BearXP/DLY_2014_Sumo/Electronics/Images as References/2007-09-15 IR Sensor/IR Sensor.jpg

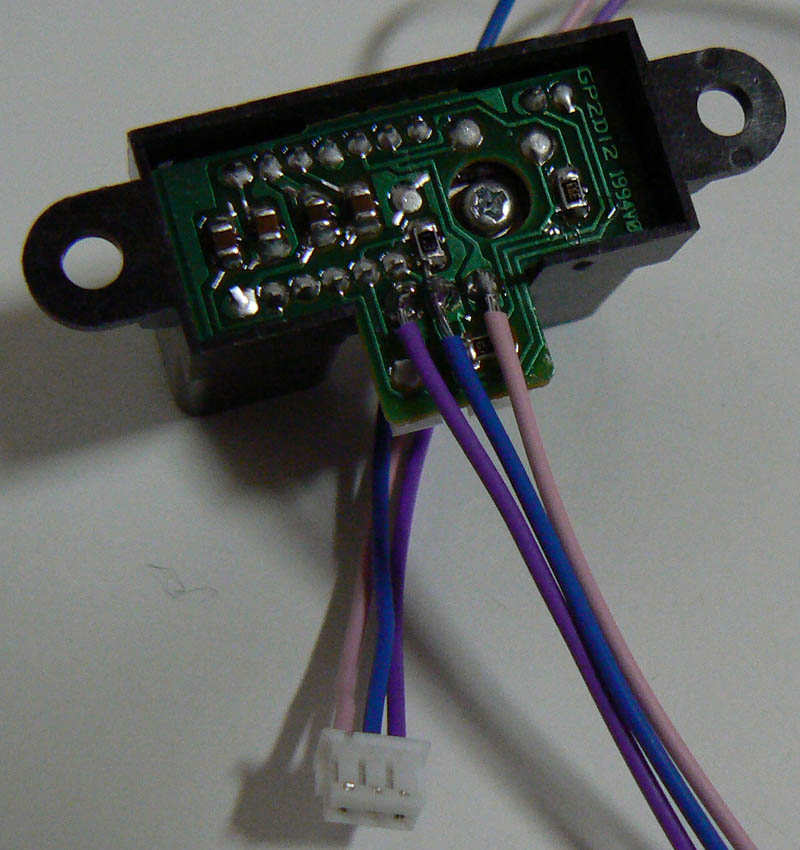
Electronics/Images as References/2007-09-15 IR Sensor/IR Sensor.jpg
