BearXP/DLY_2014_Sumo/Electronics/2007-04-16/Sumobot/Sumo info/Invetech Sumo Helpful Hints.pdf

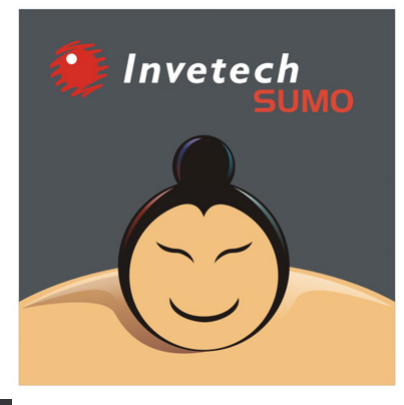
[picture p3: figure]

## Invetech Sumo Startup

Competition Day : Friday, June 30th, 12.30pm

Useful Pages

www.lynxmotion.com

www.minibearings.com.au

www.electusdistribution.com.au

www.jaycar.com.au

Example Sensors

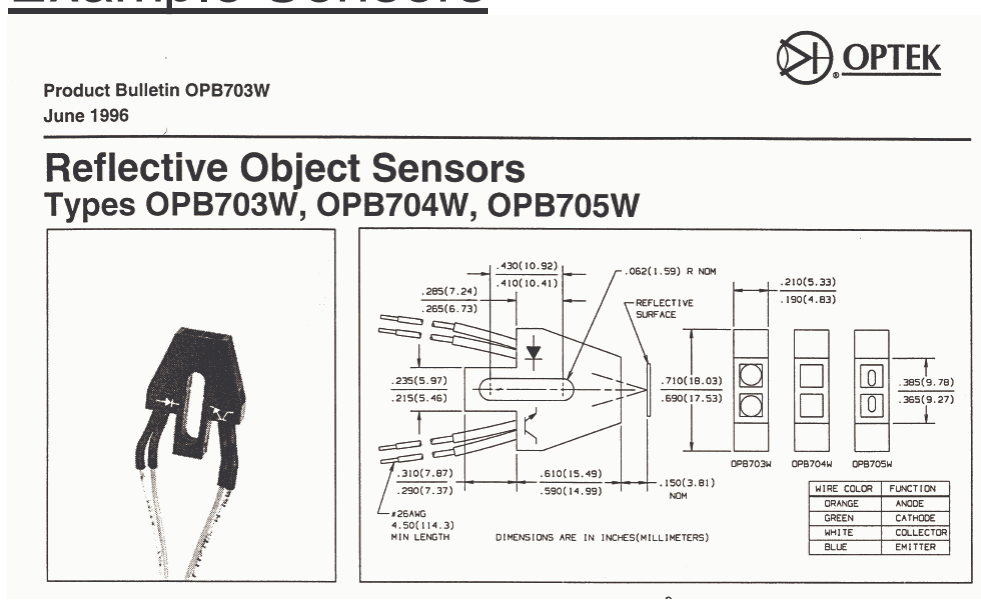
[picture p4: figure]

Farnell part No : 489 0917 $14.89

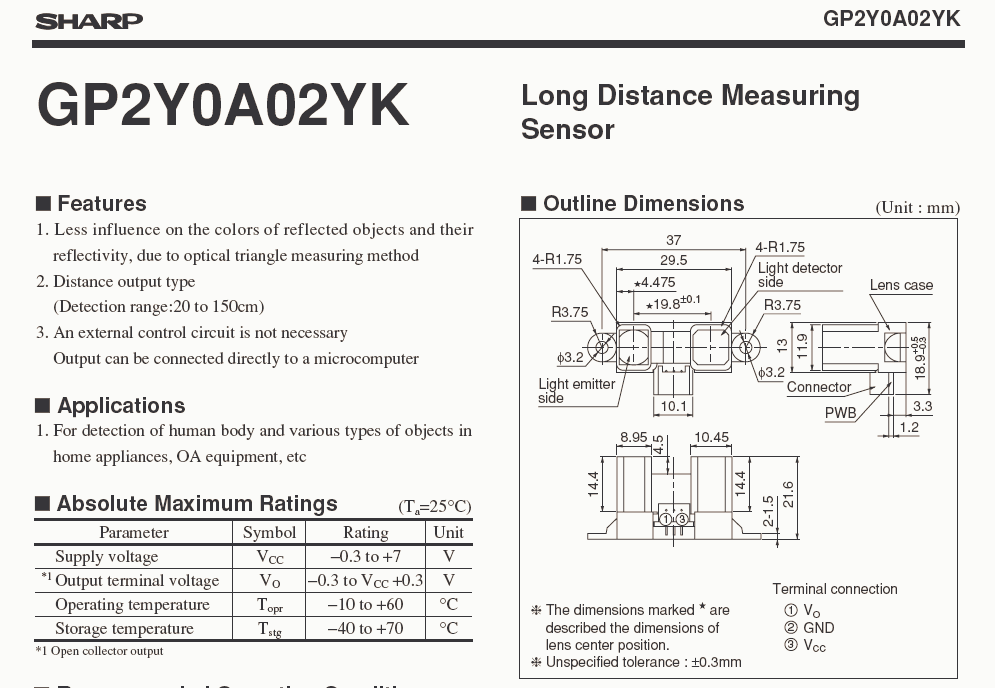
[picture p5: figure]

www.manuco.com.au around $12.00
