BearXP/DLY_2014_Sumo/Electronics/2007-04-16/Sumobot/PDFs/22-03-2007/ToDoList.pdf

## To-Do List Report For Sumobot 2007.PRJPCB

Done | Action Item | Priority | Document | Owner | Category
False | Decouple HIP4081AIBZ VCC and 12V | Normal
False | ARef require decoupling? | Normal
False | Choose resistor values | Normal
False | Sort out duplicated component names | Normal
False | Add fuse for VBat and maybe 5V? | Normal
March 22, 2007 10:26:19 PM | Page 1 of 1
