BearXP/DLY_2014_Sumo/Electronics/2007-04-16/Sumobot/Motor layout copy.gif

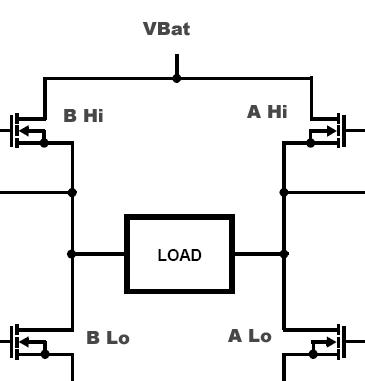
Electronics/2007-04-16/Sumobot/Motor layout copy.gif
