BearXP/DLY_2014_Sumo/Electronics/Programmers/ponyprog_sch.png

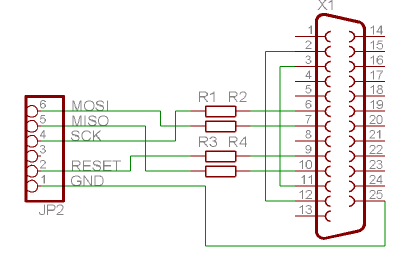
Electronics/Programmers/ponyprog_sch.png
