BearXP/DLY_2014_Sumo/Software/AVRStudio/Atmel Corporation_files/AVRstudio.jpg

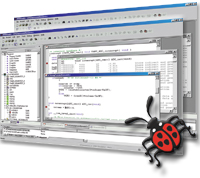
Software/AVRStudio/Atmel Corporation_files/AVRstudio.jpg
