BearXP/DLY_2014_Sumo/Electronics/2007-06-05 reroute/BOM/sumobom.xls

Sheet: Overall
Costs
 |  |  | Board | Components
PCB | 180 | QTY of Sumos | 11 | 6
PCB Components | 571.2907317 | QTY Of Motor | 15 | 11
Sensors | 520.5609756 | QTY of sumobots | 7 | 7
frame |  | Exchange Rate
 |  | $1AU = | 0.82 | $US
Total Cost | 1091.851707
Cost per person | 99.25924612

Sheet: Sumo PWA
Part |  |  |  |  |  |  | Price Each |  | Price |  |  |  | Approx Cost | Order Quantity
No | QTY | Man Part Num | Description | Man | Supplier | Supplier PN | Price AU | Price US | Break | Component | Notes | Cost/board | $US | (Using price break and num boards)
1 | 2 | SN74LVC2G14DCKR | INVERTER DUAL SHMT-T | TI | Digikey/Sample | 296-13011-1-ND |  | $0.40 | 1 | U21,U31(motor) |  | $0.80 | $4.80 | 12
2 | 0 | NTD5406NG (http://www.onsemi.com/PowerSolutions/product.do?id=NTD5406NG) | Power MOSFET 40 V, 70 A, Single N-Channel, DPAK | On Semi |  |  |  |  |  |  |  | $0.00 | $0.00 | 0
2.1 | 0 | IRFR2405TRPBF | HEX/MOS N-CHAN 55V 56A DPAK | IRF | Digikey | IRFR2405PBFCT-ND |  | 1.879 | 10 | Q1,Q2,Q3,Q4,Q5,Q6,Q7,Q8 |  | $0.00 | $0.00 | 0
2.2 | 8 | IRLR2905 | MOSFET N-CH 55V 42A DPAK | IRF | Digikey | IRLR2905-ND |  | $0.88 | 10 | Q1,Q2,Q3,Q4,Q5,Q6,Q7,Q8 |  | $7.04 | $77.44 | 88
3 | 2 | HIP4081AIBZ | IC DRIVER FET FULL BRIDGE 20SOIC | Intersil | Digikey | HIP4081AIBZ-ND |  | $5.50 | 1 | DC motor only | Drops to 4.18 @ 25 | $11.00 | $66.00 | 12
4 | 4 | LTST-C170TBKT | LED BLUE CLEAR 0805 SMD | Lite-on | TDT | 160-1579-1-ND |  | $0.30 | 10 | DS1,DS2,DS3,DS8 |  | $1.20 | $7.20 | 24
5 | 8 | LTST-C170GKT | LED GREEN CLEAR 0805 SMD | Lite-on | TDT | 160-1179-1-ND |  | $0.09 | 10 | DS4,DS5,DS6,DS7,DS10,DS11,DS12,DS13 |  | $0.74 | $4.46 | 48
6 | 1 | LM2595S-5.0 | 5V Switching Reg TO-263-5 | Nat Semi | Digikey/Sample | LM2595S-5.0-ND |  | $3.85 | 1 | VR1 |  | $3.85 | $23.10 | 6
7 | 1 | MC7812CD2T | 1A 12V Linear Reg D2PAK-3 | On Semi | Digikey | MC7812CD2TR4GOSCT-ND |  | $0.91 | 1 | VR2 |  | $0.91 | $5.46 | 6
8 | 1 | TPS76333DBV | 3.3V 150MA LDO REG SOT-23-5 | TI | Digikey | 296-2705-1-ND |  | $0.96 | 1 | VR3 |  | $0.96 | $5.76 | 6
9 | 0 | MAX232CSE | RS232 Tranceiver 5V 16 SOIC | Maxim | Digikey/sample | MAX232ECSE+-ND |  | $4.19 | 1 | U100 |  | $0.00 | $0.00 | 0
9.1 | 1 | MAX232D | RS232 Tranceiver 5V 16 SOIC | TI | Digikey/sample | 296-6936-5-ND |  | $0.90 | 1 | U100 |  | $0.90 | $5.40 | 6
10 | 1 | MAX3392E | Low Voltage Level translator TSSOP | Maxim | sample |  |  | $0.00 |  | U101 |  | $0.00 | $0.00 | 6
11 | 1 | 145638009211862 | SD Card connector press fit | AVX | Digikey | 478-2018-1-ND |  | $2.67 | 1 | CON1 |  | $2.67 | $16.02 | 6
12 | 0 | S1124 | PCB mount tactile switch |  | Alltronics | S1124 |  | $0.50 | 10 | S1, S2 |  | $0.00 | $0.00 | 0
0.1 | 2 |  | Toggle switch |  | Alltronics |  |  | $0.50 |  | S1, S2 |  | $1.00 | $6.00 | 12
13 | 1 | Atmega2560-16AU | AVR MCU 256K 16MHZ 100TQFP | Atmel | Digikey | ATMEGA2560-16AU-ND |  | $17.97 | 1 | U1 |  | $17.97 | $107.82 | 6
14 | 1 | 74VHC373M | LATCH OCTAL D-TYPE 20-SOIC | Fairchild | Digikey | 74VHC373M-ND |  | $0.43 | 1 | U2 |  | $0.43 | $2.58 | 6
15 | 1 | K6R1008C1D | 128Kx8 Bit High-Speed CMOS Static RAM 5V | Samsung | UNKNOWN |  |  |  |  | U3 |  | $0.00 | $0.00 | 6
15.1 |  | CY7C1019B |  | Cypress | Jameco |  |  |  |  |  |  |  |  | 0
15.2 |  | IDT71124 |  | ISSI |  |  |  |  |  |  |  |  |  | 0
16 | 1 | 10BQ100TRPBF | DIODE SCHOTTKY 100V 1A SMB | Vishay SGI | Digikey | 10BQ100PBFCT-ND |  | $0.63 | 10 | D1 |  | $0.63 | $3.78 | 6
17 | 1 | PE-53935SNL | INDUCTOR POWER 250UH 150KHZ SMD | Pulse | Digikey | 553-1418-ND |  | $1.49 | 10 | L2 |  | $1.49 | $8.95 | 6
18 | 1 | CDRH125NP-470MC | POWER INDUCTOR 47UH 1.8A SMD | Sumida | Digikey | 308-1451-1-ND |  | $1.84 | 10 | L1 |  | $1.84 | $11.03 | 6
19 | 5 | EEU-FC1H221 | CAP 220UF 50V ELECT FC RADIAL | Panasonic | Digikey | P10325-ND |  | $0.45 | 10 | C39, C40, C41, C44, C46 |  | $2.24 | $13.44 | 30
20 | 18 | C0805C104K5RACTU (http://www.digikey.com/scripts/DkSearch/dksus.dll?Detail?Ref=16902&Row=164772&Site=US) | CAP 100nF 50V CERAMIC X7R 0805 10% | Kemet | Digikey | 399-1170-1-ND |  | $0.03 | 100 | C8,C10,C11,C12,C13,C14,C15,C43, C45, C47, C60, C61, C110, C111, C130, C131, C132, C133 |  | $0.49 | $2.95 | 108
21 | 2 |  | 22uF 10V Tantalum SMB |  | Sample |  |  | $0.00 |  | C48, C49 |  | $0.00 | $0.00 | 12
22 | 2 | EKY-500ELL102ML25S | CAP 1000UF 50V ELECT KY RAD | United Chemi-Con | digikey | 565-1617-ND |  | $0.62 | 10 | C42, C1(motor) |  | $1.23 | $32.08 | 52
23 | 1 | FOXSLF/160-20 | 16MHz HC49SLF crystal 20pF | FOX | digikey | 631-1108-ND |  | $0.57 | 1 | Y1 |  | $0.57 | $3.42 | 6
24 | 1 | CFS206-32.768KDZB-UB | CRYSTAL 32.768 KHZ CYL 6PF | Citizen | digikey | 300-8301-ND (http://www.digikey.com/scripts/DkSearch/dksus.dll?Detail?Ref=119705&Row=116973&Site=US) |  | $0.28 | 1 | Y2 |  | $0.28 | $1.68 | 6
25 | 2 | CC0805DRNP09BN6R0 | CAP CERAMIC 6.0PF 50V NP0 0805 | Yageo Corporation | digikey | 311-1095-1-ND (http://www.digikey.com/scripts/DkSearch/dksus.dll?Detail?Ref=123550&Row=124398&Site=US) |  | $0.08 | 10 | C6, C7 |  | $0.16 | $0.97 | 12
26 | 2 | GRM1885C2A200JA01D | CAP CER 20PF 100V 5% C0G 0603 | Murata Electronics | digikey | 490-1334-1-ND (http://www.digikey.com/scripts/DkSearch/dksus.dll?Detail?Ref=125249&Row=204994&Site=US) |  | $0.06 | 10 | C4, C5 |  | $0.12 | $0.71 | 12
27 | 12 | SS1H10-E3/61T | DIODE SCHOTTKY 1A 100V SMA | Vishay | digikey | SS1H10-E3/61TGICT-ND (http://www.digikey.com/scripts/DkSearch/dksus.dll?Detail?Ref=4457&Row=1056503&Site=US) |  | $0.20 | 10 | D20,D21,D22,D23,D24,D25,D30,D31,D32,D33,D34.D35 |  | $2.34 | $14.04 | 72
28 | 4 | C0805C473K5RACTU | CAP 47000PF 50V CERAMIC X7R 0805 | Kemet | digikey | 399-1166-1-ND |  | $0.06 | 10 | C20,C21,C30,C31 |  | $0.24 | $1.46 | 24
29 | 2 | 171-009-203L031 | CONN DB9 FEMALE SLD CUP NICKEL | Norcomp Inc. | sample | 3209FE-ND |  | $1.69 | 1 | J100, J101 |  | $3.38 | $20.28 | 12
30 | 2 | 743C083271JPTR | RES ARRAY 270 OHM 8TERM 4RES SMD 4x0603 62.5mW | CTS | digikey |  |  | $0.05 | 10 | RP2, RP3 |  | $0.09 | $0.55 | 12
31 | 8 | ECJ-2FB1E105K | CAP CERAMIC 1UF 25V X5R 0805 | Panasonic | digikey | PCC2319CT-ND |  | $0.13 | 10 | C32,C100,C101,C103,C104,C105,C113, C114,C115 |  | $1.03 | $6.19 | 48
32 | 1 | TLC5920 | 16x8 LED Driver/Controller | TI | digikey | 296-10348-5-ND |  | $2.48 | 1 | U5 |  | $2.48 | $14.88 | 6
33 | 2 |  | 0R 0805 resistor |  | INV |  |  |  |  | R1, R2 |  | $0.00
35 | 1 |  | FuseHolder Miniblade |  | INV |  |  |  |  | FH_8 |  | $0.00
36 | 2 |  | Mini-Fit Jnr 2x1 4.2mm |  | INV |  |  |  |  | JP122, JP123 |  | $0.00
37 | 4 |  | KK 1x2 2.54mm |  | INV |  |  |  |  | JP130, JP131, JP132, JP133 |  | $0.00
38 | 1 |  | DC Jack 2.1mm |  | DLY |  |  |  |  | JP124 |  | $0.00
39 | 4 |  | ZHR 1x3 1.5mm |  | INV |  |  |  |  | JP112, JP113, JP114, JP115 |  | $0.00
40 | 1 |  | KK 1x3 2.54mm |  | INV |  |  |  |  | JP116 |  | $0.00
41 | 2 |  | PHR 1x6 2mm |  | INV |  |  |  |  | JP120, JP121 |  | $0.00
42 | 3 |  | ZHR 1x4 1.5mm |  | INV |  |  |  |  | JP109, JP110, JP111 |  | $0.00
43 | 1 |  | EHR 1x4 2.5mm |  | INV |  |  |  |  | JP105 |  | $0.00
44 | 1 |  | microfit 2x4 3mm |  | INV |  |  |  |  | JP102 |  | $0.00
45 | 4 |  | EHR 1x4 2.5mm |  | INV |  |  |  |  | JP125, JP126, JP127, JP128 |  | $0.00
46 | 2 |  | HDR2X5 |  | INV |  |  |  |  | JP100, JP101 |  | $0.00
47 | 4 |  | ZHR 1x6 1.5mm |  | INV |  |  |  |  | JP30, JP31, JP32, JP33 |  | $0.00
48 | 1 |  | KK 1x7 2.54mm |  | INV |  |  |  |  | JP107 |  | $0.00
49 | 1 |  | PHR 1x8 2mm |  | INV |  |  |  |  | JP1 |  | $0.00
50 | 3 |  | 22uF Polarized Capacitor (Axial) Tant |  | TDT |  |  |  |  | C1, C2, C3 |  | $0.00
51 | 2 |  | DSUB1.385-2H9 Simple |  | INV |  |  |  |  | JP100, JP101 |  | $0.00
52 | 2 |  | 10K 0805 resistor |  | INV |  |  |  |  | R110, R111 |  | $0.00
53 | 38 |  | 1k 0805 resistor |  | INV |  |  |  |  | R3, R4, R5, R10, R65, R66, R67, R68, R70, R71, R72, R73, R74, R75, R76, R77, R100, R101, R102, R103, R104, R105, R106, R107, R120, R121, R122, R123, R124, R125, R126, R127, R201, R202, R203, R204, R205, R206 |  | $0.00
54 | 4 |  | 20k 0805 resistor |  | INV |  |  |  |  | R11, R108, R109, R118 |  | $0.00
55 | 1 |  | SW DPDT |  | Altronics |  |  |  |  | S3 |  | $0.00
56 | 2 |  | 8x8 LED matrix |  | Sure Electronics | 296-10348-5-ND |  |  |  | LED1,LED2 |  | $0.00
57 | 1 | 743C083223JPTR | 22K 4x0805 Resistor pack |  | digikey | 743C083223JPCT-ND |  | $0.16 | 10 | RP1 |  | $0.16
58 | 1 | 743C083124JTR | 120K 4x0805 Resistor pack |  | digikey | 743C083124JCT-ND |  | $0.16 | 10 | RP4 |  | $0.16
 |  |  |  |  |  |  |  |  |  |  | Approx total | $68.42 | $571.29
Motor driver board
 | 4 |  | CAP 47nF 0805 |  | INV |  |  |  |  | C20,C21,C30,C31
 | 2 |  | CAP 100nF 50V CERAMIC X7R 0805 10% |  | INV |  |  |  |  | C22,C32 |  |  |  | NA( ordered above)
 | 4 |  | FuseHolder Miniblade |  | INV |  |  |  |  | FH_1,FH_3,FH_5,FH_7
 | 1 |  | PHR 1x8 2mm |  | INV |  |  |  |  | JP1
 | 2 |  | microfit 2x3 3mm |  | INV |  |  |  |  | JP20,JP21
 | 1 |  | Screw Terminals x 2 x M4 |  | INV |  |  |  |  | JP30
 | 1 |  | Mini-Fit Jnr 2x1 4.2mm |  | INV |  |  |  |  | JP31
 | 1 |  | 1k 0805 resistor |  | INV |  |  |  |  | R1
 | 8 |  | 10R 0805 resistor |  | INV |  |  |  |  | R22,R23,R24,R25,R32,R33,R34,R35
 | 2 |  | 20K 0805 resistor |  | INV |  |  |  |  | R30,R31
 | 2 | HIP4081AIBZ | 80V/2.5A Peak, High Frequency Full Bridge FET Driver SOIC20A |  | Only if using DC motor |  |  |  |  | U20,U30
 | 12 |  | Jumper SMT 3 Way |  | N/A |  |  |  |  | W20,W21,W22,W23,W24,W25,W30,W31,W32,W33,W34,W35
Programmer and development kit
 |  | AVRDEVKIT1-ND | Dragon programmer |  | Digikey | AVRDEVKIT1-ND |  | $49 |  |  |  |  | $196 | 4

Sheet: Sumo Sensors
 |  |  |  |  |  | Price Each |  | Price |  |  |  | Approx Cost | Approx Cost | Order Quantity
QTY | Man Part Num | Description | Man | Supplier | Supplier PN | Price AU | Price US | Break | Component | Notes | Cost/bot | $AU | $US | (Using price break
4 |  | Bump Switches |  |  |  | $1.00 |  | 1 |  |  | $4.00 | $28.00 | $0.00 | 28
4 | GP2Y0A02YK | IR Range Sensors Analog output | Sharp | digikey |  |  | $11.50 | 25 |  |  | $46.00 | $0.00 | $322.00 | 28
4 | QRB1114 | Opto reflective line sensors | Fairchild | digikey |  |  | 0.875 | 10 |  |  | $3.50 | $0.00 | $24.50 | 28
2 | OM02 | Mouse Sensors |  | MSY |  | $5.00 |  | 1 | Cheap optical mouse |  | $10.00 | $70.00 | $0.00 | 14
 |  |  |  |  |  |  |  |  |  | Total | 63.5 | $520.56

Sheet: PCBs
Description | PCB specs | PCB Cost | Price Break
 |  | per board | QTY
Main board | 30 sq inch | 12 | 10 | 120
Motor board | 11 sq inch | 6 | 10 | 60
 |  | Total | 180
