BearXP/DLY_2014_Sumo/Electronics/2007-04-16/Sumobot/BOM/sumo bom.xls

Sheet: Sumo PWA
Part |  |  |  |  |  |  | Price Each |  | Price
No | QTY | Man Part Num | Description | Man | Supplier | Supplier PN | Price AU | Price US | Break | Component | Notes
1 | 2 | SN74LVC2G14DCKR | INVERTER DUAL SHMT-T | TI | Digikey/Sample | 296-13011-1-ND |  | $0.40 | 1 | U21,U31
2 | 8 | NTD5406NG (http://www.onsemi.com/PowerSolutions/product.do?id=NTD5406NG) | Power MOSFET 40 V, 70 A, Single N-Channel, DPAK | On Semi
2.1 | 0.1 | IRFR2405TRPBF | HEX/MOS N-CHAN 55V 56A DPAK | IRF | Digikey | IRFR2405PBFCT-ND |  | 1.879 | 10 | Q1,Q2,Q3,Q4,Q5,Q6,Q7,Q8
2.2 | 0.2 | IRLR2905 | MOSFET N-CH 55V 42A DPAK | IRF | Digikey | IRLR2905-ND |  | $0.88 | 10 | Q1,Q2,Q3,Q4,Q5,Q6,Q7,Q8
3 | 2 | HIP4081AIBZ | IC DRIVER FET FULL BRIDGE 20SOIC | Intersil | Digikey | HIP4081AIBZ-ND |  | $5.50 | 1 | Q1,Q2,Q3,Q4,Q5,Q6,Q7,Q8 | Drops to 4.18 @ 25
4 | 4 | LTST-C170TBKT | LED BLUE CLEAR 0805 SMD | Lite-on | Digikey | 160-1579-1-ND |  | $0.30 | 10 | DS1,DS2,DS3,DS8
5 | 4 | LTST-C170GKT | LED GREEN CLEAR 0805 SMD | Lite-on | Digikey | 160-1179-1-ND |  | $0.09 | 10 | DS4,DS5,DS6,DS7
6 | 1 | LM2595S-5.0 | 5V Switching Reg TO-263-5 | Nat Semi | Digikey/Sample | LM2595S-5.0-ND |  | $3.85 | 1 | VR1
7 | 1 | MC7812CD2T | 1A 12V Linear Reg D2PAK-3 | On Semi | Digikey | MC7812CD2TR4GOSCT-ND |  | $0.91 | 1 | VR2
8 | 1 | TPS76333DBV | 3.3V 150MA LDO REG SOT-23-5 | TI | Digikey | 296-2705-1-ND |  | $0.96 | 1 | VR3
9 | 1 | MAX232CSE | RS232 Tranceiver 5V 16 SOIC | Maxim | Digikey/sample | MAX232ECSE+-ND |  | $4.19 | 1 | U100
9.1 | 0.1 | MAX232D | RS232 Tranceiver 5V 16 SOIC | TI | Digikey/sample | 296-6936-5-ND |  | $0.90 | 1 | U100
10 | 1 | MAX3392E | Low Voltage Level translator TSSOP | Maxim | sample |  |  | $0.00 |  | U101
11 | 1 | 145638009211862 | SD Card connector press fit | AVX | Digikey | 478-2018-1-ND |  | $2.67 | 1 | CON1
12 | 2 | S1124 | PCB mount tactile switch |  | Alltronics | S1124 |  | $0.50 | 10 | S1, S2
0.1 | 2 |  | Toggle switch |  | Alltronics |  |  |  |  | S1, S2
13 | 1 | Atmega2560-16AU | AVR MCU 256K 16MHZ 100TQFP | Atmel | Digikey | ATMEGA2560-16AU-ND |  | $17.97 | 1 | U1
14 | 1 | 74VHC373M | LATCH OCTAL D-TYPE 20-SOIC | Fairchild | Digikey | 74VHC373M-ND |  | $0.43 | 1 | U2
15 | 1 | K6R1008C1D | 128Kx8 Bit High-Speed CMOS Static RAM 5V | Samsung | UNKNOWN |  |  |  |  | U3
16 | 1 | 10BQ100TRPBF | DIODE SCHOTTKY 100V 1A SMB | Vishay SGI | Digikey | 10BQ100PBFCT-ND |  | $0.63 | 10 | D1
17 | 1 | PE-53935SNL | INDUCTOR POWER 250UH 150KHZ SMD | Pulse | Digikey | 553-1418-ND |  | $1.49 | 10 | L2
18 | 1 | CDRH125NP-470MC | POWER INDUCTOR 47UH 1.8A SMD | Sumida | Digikey | 308-1451-1-ND |  | $1.84 | 10 | L1
19 | 1 | EEU-FC1H221 | CAP 220UF 50V ELECT FC RADIAL | Panasonic | Digikey | P10325-ND |  | $0.45 | 10 | C40, C41, C44, C46
20 | 10 | C0805C104K5RACTU (http://www.digikey.com/scripts/DkSearch/dksus.dll?Detail?Ref=16902&Row=164772&Site=US) | CAP 100nF 50V CERAMIC X7R 0805 10% | Kemet | Digikey | 399-1170-1-ND |  | $0.03 | 100 | C10,C11,C12,C13,C14,C15,C43, C45, C47
21 | 2 |  | 22uF 10V Tantalum SMB |  | Sample |  |  | $0.00 |  | C48, C49
22 | 1 | EKY-500ELL102ML25S | CAP 1000UF 50V ELECT KY RAD | United Chemi-Con | digikey | 565-1617-ND |  | $0.62 | 10 | C42
23 | 1 | FOXSLF/160-20 | 16MHz HC49SLF crystal 20pF | FOX | digikey | 631-1108-ND |  | $0.57 | 1 | Y1
24 | 1 | CFS206-32.768KDZB-UB | CRYSTAL 32.768 KHZ CYL 6PF | Citizen | digikey | 300-8301-ND (http://www.digikey.com/scripts/DkSearch/dksus.dll?Detail?Ref=119705&Row=116973&Site=US) |  | $0.28 | 1 | Y2
25 | 2 | CC0805DRNP09BN6R0 | CAP CERAMIC 6.0PF 50V NP0 0805 | Yageo Corporation | digikey | 311-1095-1-ND (http://www.digikey.com/scripts/DkSearch/dksus.dll?Detail?Ref=123550&Row=124398&Site=US) |  | $0.08 | 10 | C6, C7
26 | 2 | GRM1885C2A200JA01D | CAP CER 20PF 100V 5% C0G 0603 | Murata Electronics | digikey | 490-1334-1-ND (http://www.digikey.com/scripts/DkSearch/dksus.dll?Detail?Ref=125249&Row=204994&Site=US) |  | $0.06 | 10 | C4, C5
27 | 4 | SS1H10-E3/61T | DIODE SCHOTTKY 1A 100V SMA | Vishay | digikey | SS1H10-E3/61TGICT-ND (http://www.digikey.com/scripts/DkSearch/dksus.dll?Detail?Ref=4457&Row=1056503&Site=US) |  | $0.20 | 10 | D20, D21,D30,D31
28 | 4 | C0805C473K5RACTU | CAP 47000PF 50V CERAMIC X7R 0805 | Kemet | digikey | 399-1166-1-ND |  | $0.06 | 10 | C20,C21,C30,C31
29 | 2 | 171-009-203L031 | CONN DB9 FEMALE SLD CUP NICKEL | Norcomp Inc. | digikey | 3209FE-ND |  | $1.69 | 1
30 | 2 | 742C083471JPTR | RES ARRAY 470 OHM 8TERM 4RES SMD 4x0603 62.5mW | CTS | digikey | 742C083471JPCT-ND |  | $0.05 | 10 | RP2, RP3
31 | 5 | ECJ-2FB1E105K | CAP CERAMIC 1UF 25V X5R 0805 | Panasonic | digikey | PCC2319CT-ND |  | $0.13 | 10 | C32,C100,C101,C103,C104,C105
32
33
34
35
36
37
38
39

Sheet: Sumo Sensors
 |  |  |  |  |  | Price Each |  | Price
QTY | Man Part Num | Description | Man | Supplier | Supplier PN | Price AU | Price US | Break | Component | Notes
4 |  | Bump Switches
4 | GP2Y0A02YK | IR Range Sensors Analog output | Sharp | digikey |  |  | $11.50 | 25
4 | QRB1114 | Opto reflective line sensors | Fairchild | digikey |  |  | 0.875 | 10
2 | OM02 | Mouse Sensors |  | MSY |  | $5.00 |  | 1 | Cheap optical mouse
