BearXP/DLY_2014_Sumo/Electronics/Images as References/2007-07-30 Pics Assembled Boards/motor bottom.jpg

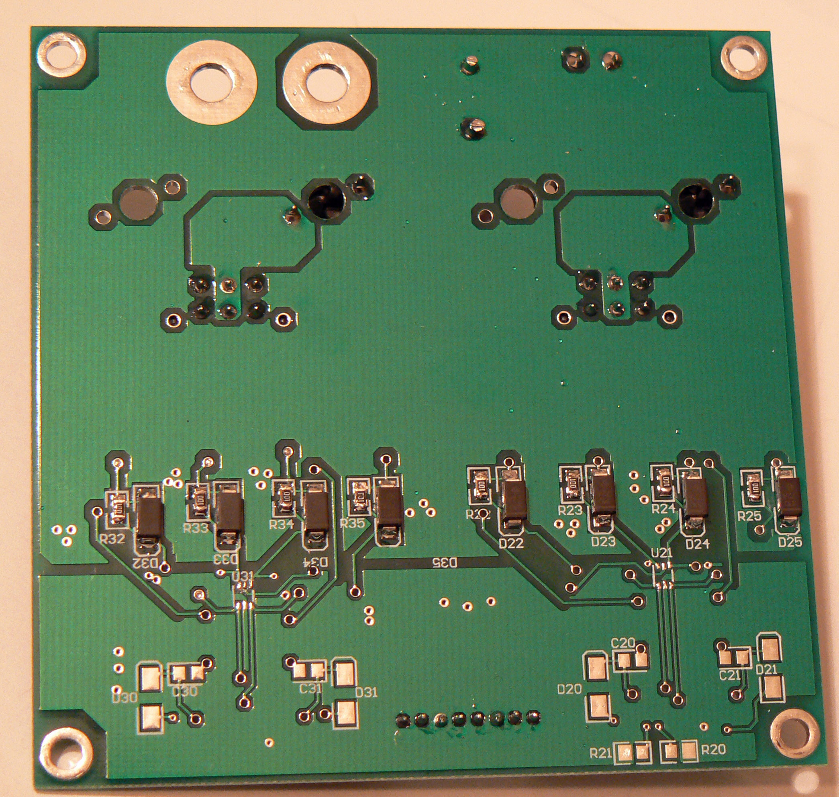
Electronics/Images as References/2007-07-30 Pics Assembled Boards/motor bottom.jpg
