BearXP/DLY_2014_Sumo/Electronics/2007-03-05 sch export/Interface and Connectors - Sensors.pdf

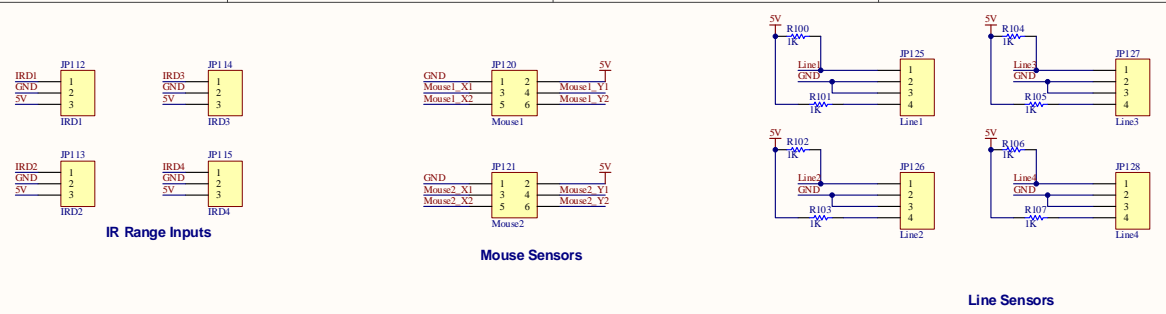
[picture p13: page 1]

Title

Size A4 | Number | | Revision

Date: 04-Mar-07 | | Sheet of
File: C:\Documents and Settings\..\Interfaces and Connectors - Sensors.SCHDOC Drawn By:
