BearXP/DLY_2014_Sumo/Electronics/2007-03-05 sch export/Interface and Connectors.pdf

## RS-232 Interface

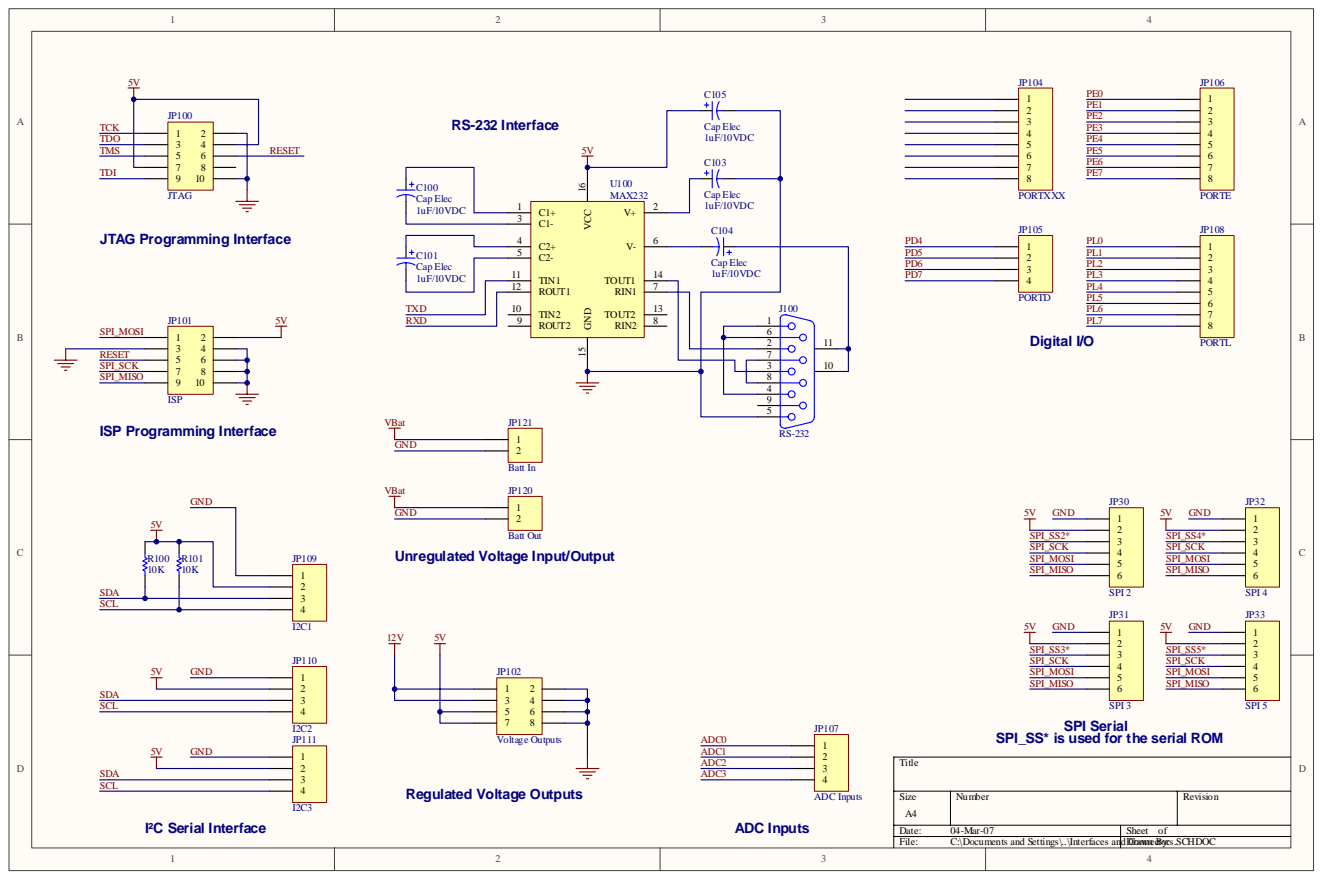
[picture p14: page 1]

Unregulated Voltage Input/Output

SPI_SS* is used for the serial ROM

Date: 04-Mar-07 | Sheet of
File: C:\Documents and Settings\..\Interfaces and Connectors.SCHDOC Drawn By:
