BearXP/DLY_2014_Sumo/Electronics/2007-03-05 sch export/Microcontroller.pdf

## Static RAM Extension

RESET* 30 | VCC ¹⁰ GND 11 XTAL2 33 | XTAL1 34 | I2C/SCL/INT0/PD0 | 43 I2C-SDA/INT1/PD1 | 44 RXD1/INT2/PD2 | 45 TXD1/INT3/PD3 | 46 ICP1/PD4 | 47 XCK1/PD5 | 48 T1/PD6 | 49 T0/PD7 | 50 PC0/A8 | 53 PC1/A9 | 54 PC2/A10 | 55 PC3/A11 | 56 PC4/A12 | 57 PC5/A13 | 58 PC6/A14 | 59 PC7/A15 | 60 PA7/AD7 | 71 PA6/AD6 | 72 PA5/AD5 | 73 PA4/AD4 | 74 PA3/AD3 | 75 PA2/AD2 | 76 PA1/AD1 | 77 PA0/AD0 | 78

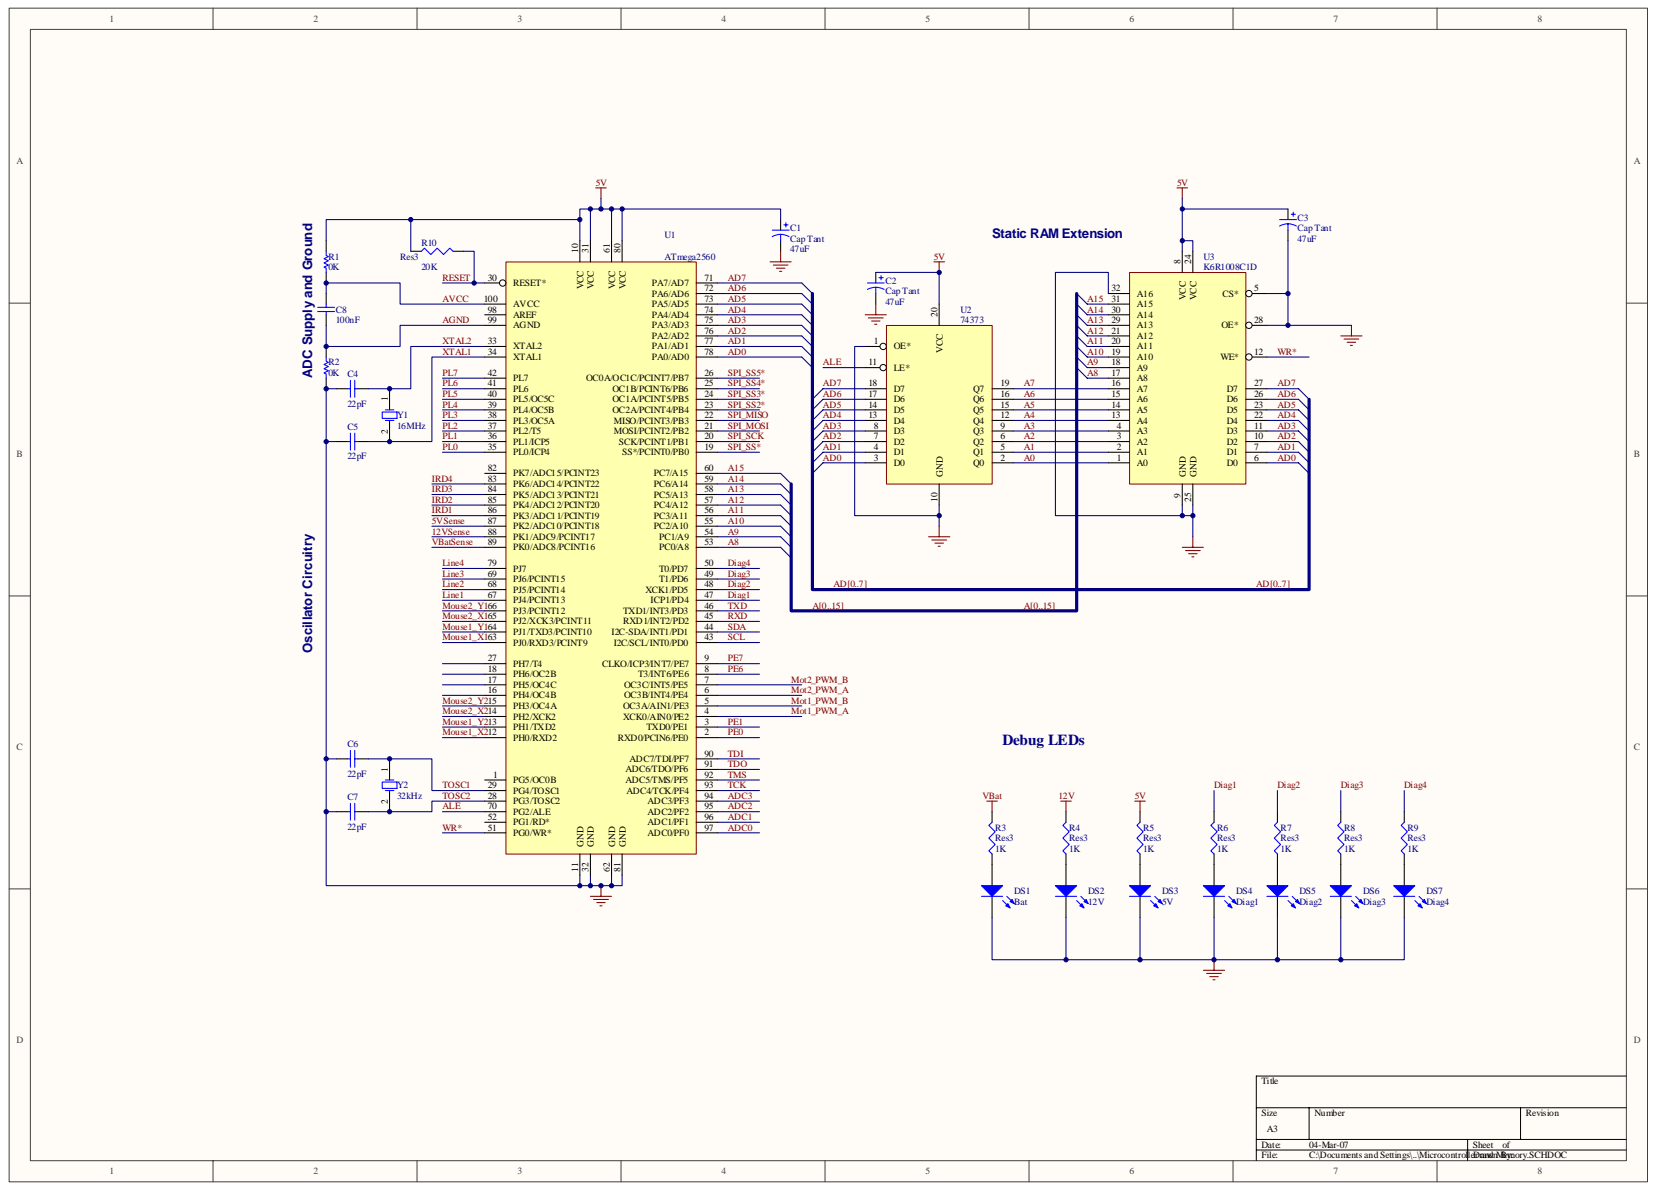
[picture p15: page 1]

ADC Supply and Ground PL7

VCC 61 GND 62 AREF 98 AGND 99 AVCC 100

VCC 20 GND 10 LE* 11 OE* 1 U2 74373 A7 A6 A5 A4 A3 A2 A1 A0

Title

Size A3 | Number | | Revision

Date: 04-Mar-07 | | Sheet of
File: C:\Documents and Settings\..\Microcontroller and Memory.SCHDOC Drawn By:
