BearXP/DLY_2014_Sumo/Electronics/2007-03-05 sch export/Motor Control.pdf

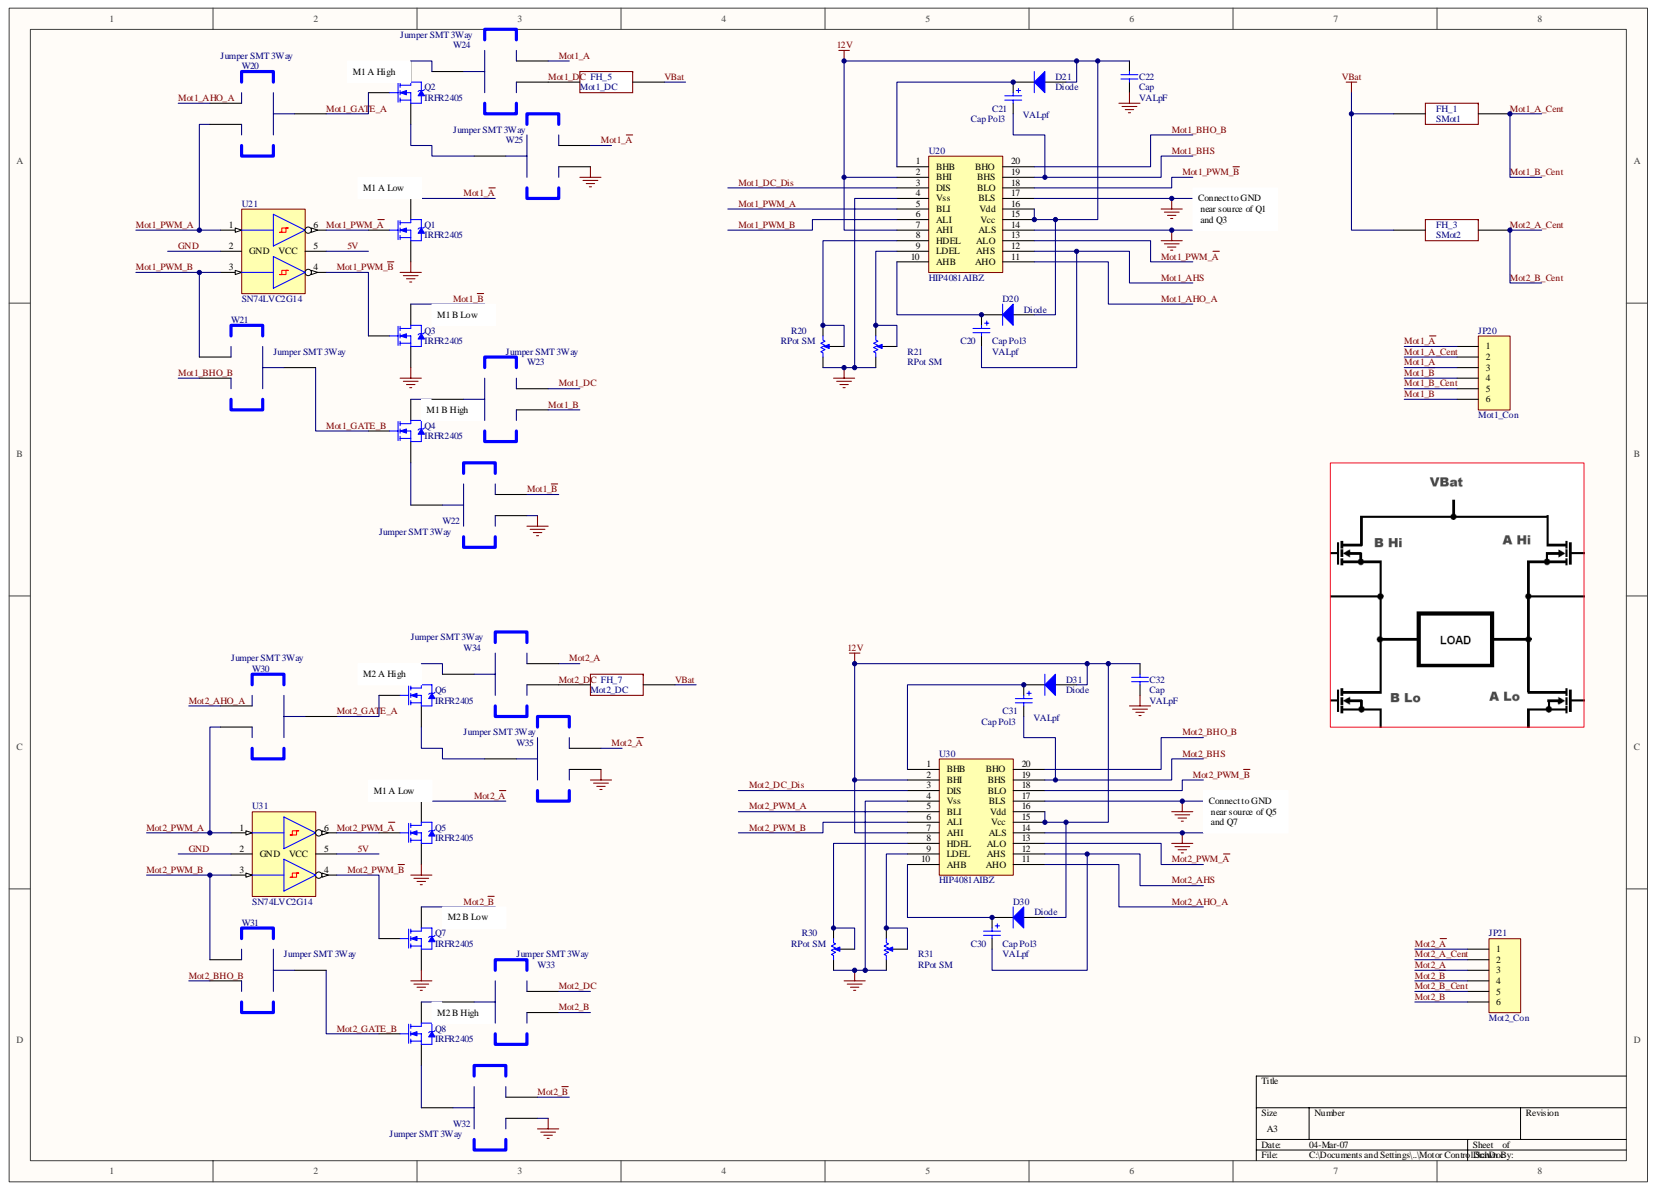
[picture p16: page 1]

Jumper SMT 3Way | W24 | Mot1_DC_Dis Mot1_PWM_A | 12V | | VBat

B | | W21 | M1 B Low | Jumper SMT 3Way | Diode | Mot1_A Mot1_A Mot1_B Mot1_B | JP20 | B

VALpf

AHI 7

LDEL 9

Mot2_B | R30 RPot SM | D30 | Diode | Mot2_AHO_A | JP21
M2 B Low

Title

Size A3 | Number | | Revision

Date: 04-Mar-07 | | Sheet of
File: C:\Documents and Settings\..\Motor Control.SchDoc Drawn By:
