BearXP/DLY_2014_Sumo/Electronics/2007-03-05 sch export/Power.pdf

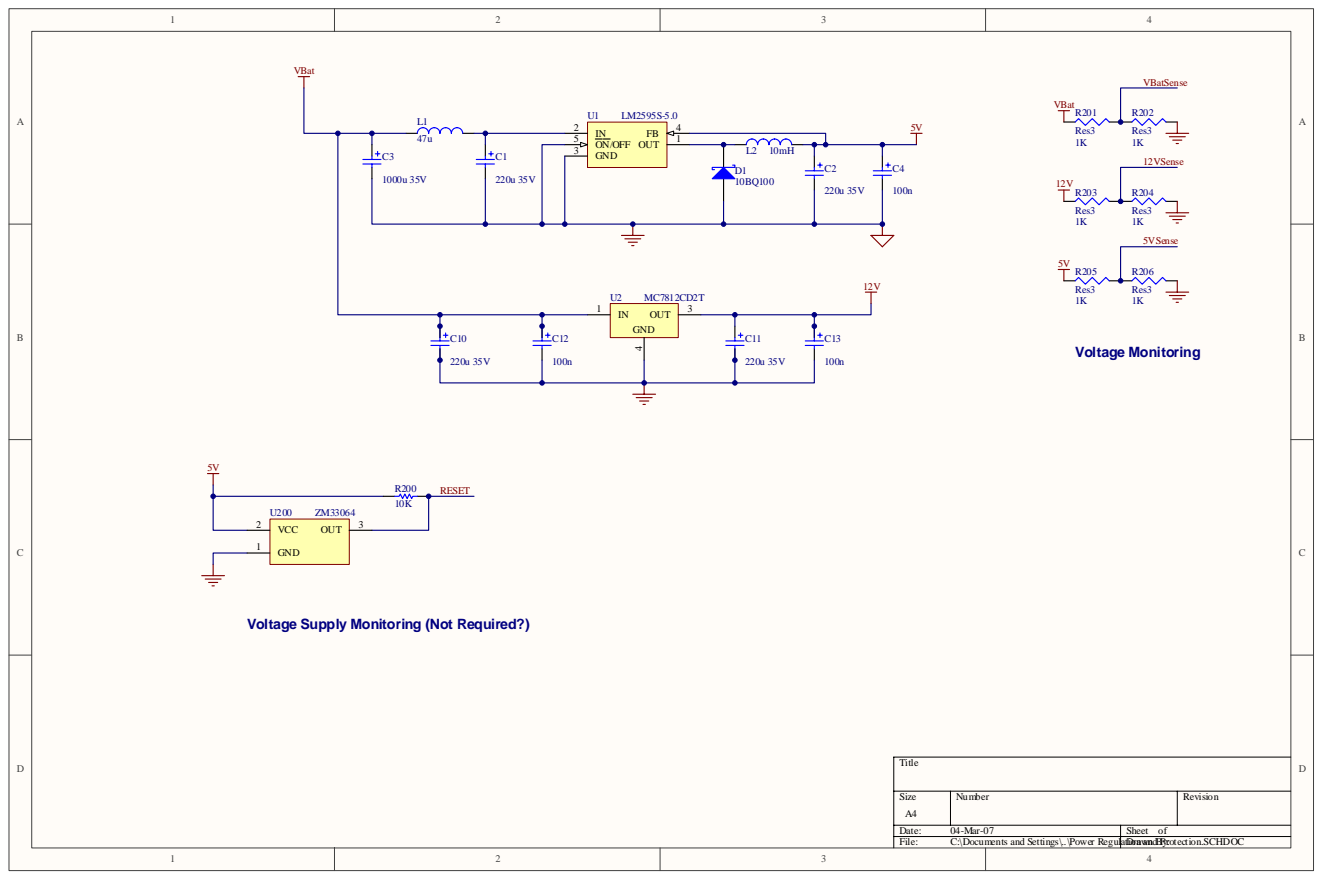
[picture p17: page 1]

VBat U1 LM2595S-5.0 | | VBatSense VBat

Voltage Supply Monitoring (Not Required?)

Title

Size A4 | Number | | Revision

Date: 04-Mar-07 | | Sheet of
File: C:\Documents and Settings\..\Power Regulation and Protection.SCHDOC Drawn By:
