BearXP/DLY_2014_Sumo/Electronics/2007-03-30/Interface and Connectors.pdf

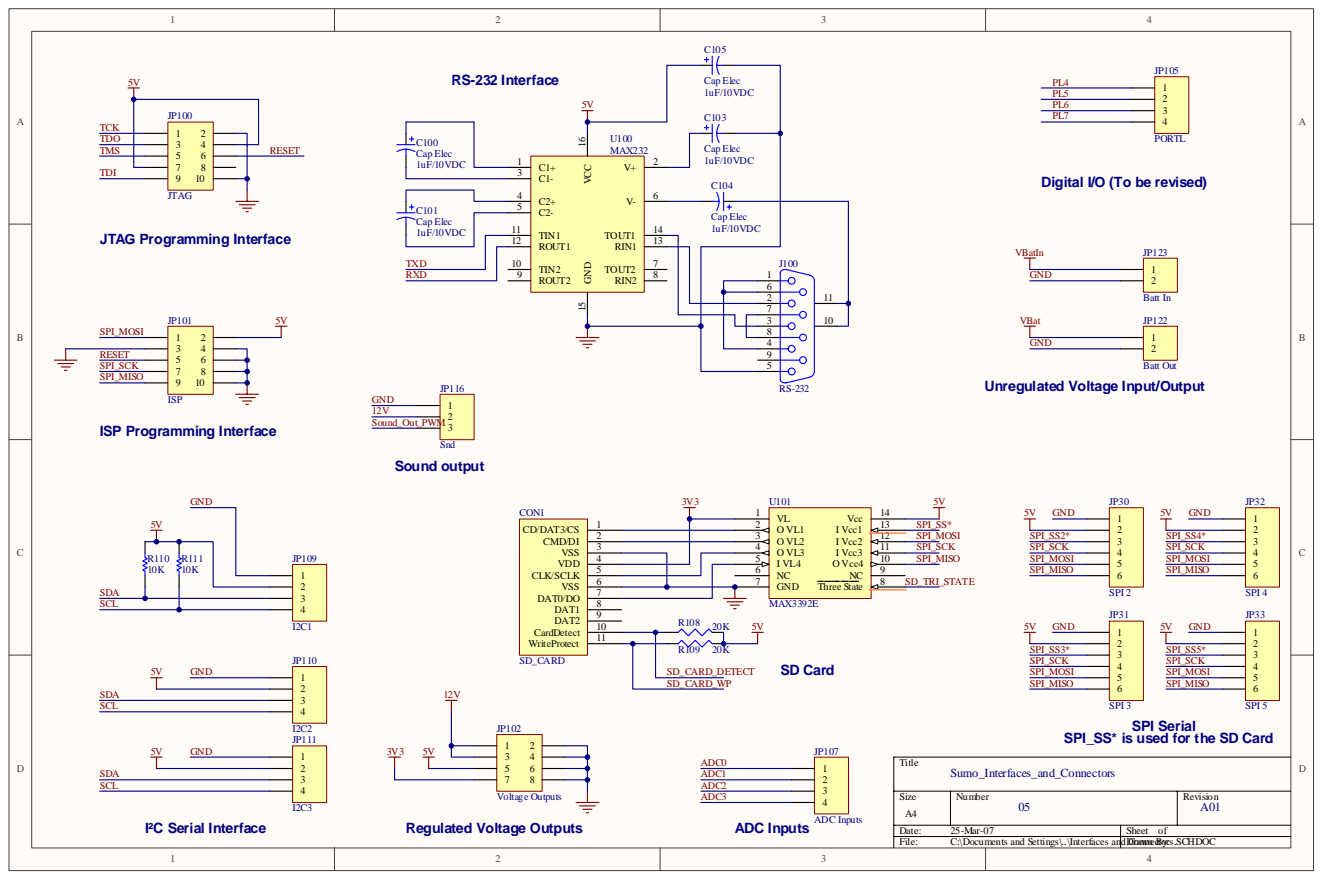
[picture p18: page 1]

RS-232 Interface 5V | C105 | JP105 Digital I/O (To be revised)

Unregulated Voltage Input/Output

SPI_SS* is used for the SD Card

Date: 25-Mar-07 | Sheet of
File: C:\Documents and Settings\..\Interfaces and Connectors.SCHDOC Drawn By:
