BearXP/DLY_2014_Sumo/Electronics/2007-03-30/Power.pdf

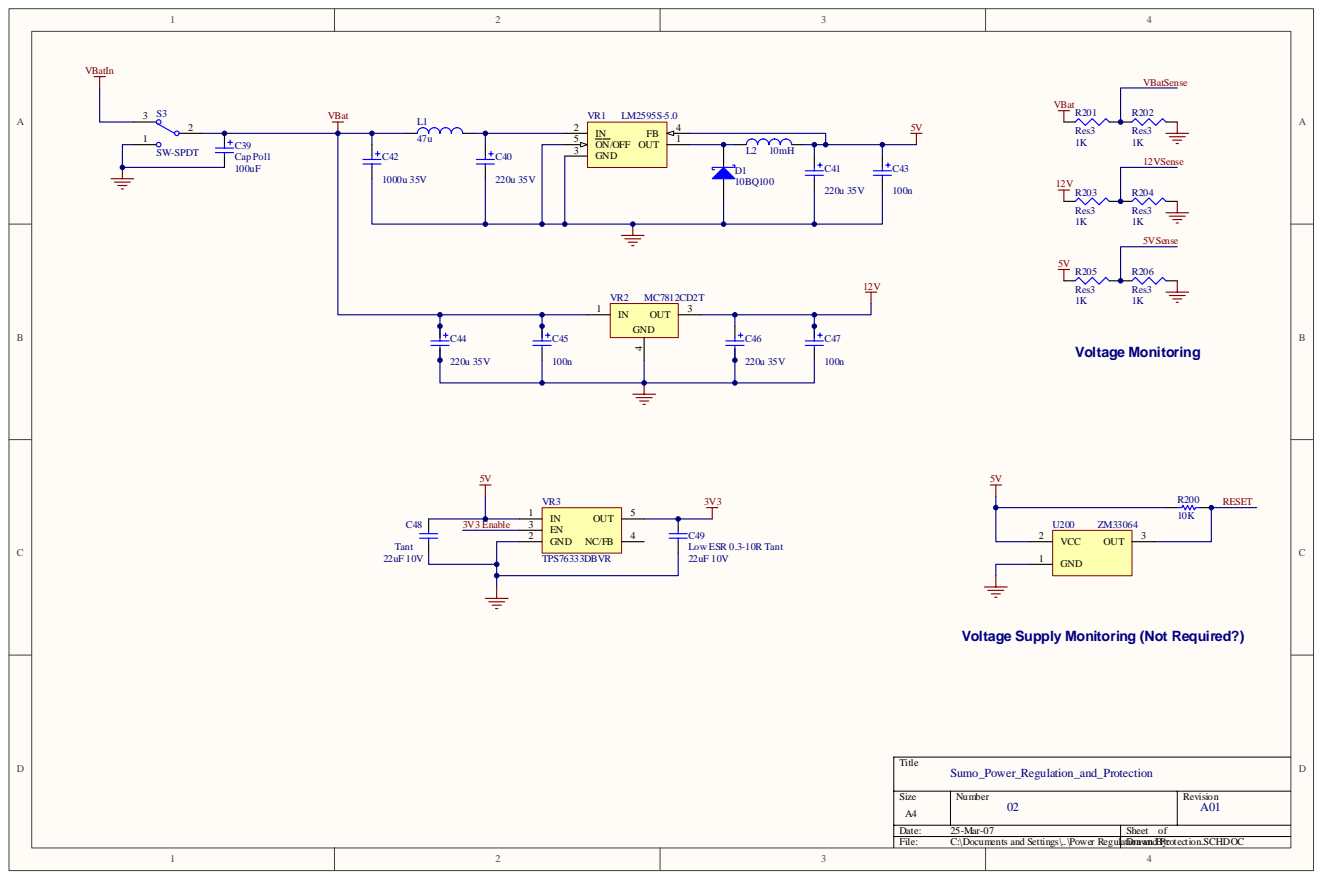
[picture p19: page 1]

VBatIn 3 S3 VBat VR1 LM2595S-5.0 | | VBatSense VBat

Voltage Supply Monitoring (Not Required?)

Title Sumo_Power_Regulation_and_Protection

Size A4 | Number | 02 | Revision A01

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
