BearXP/DLY_2014_Sumo/Electronics/2007-03-30/Sensors.pdf

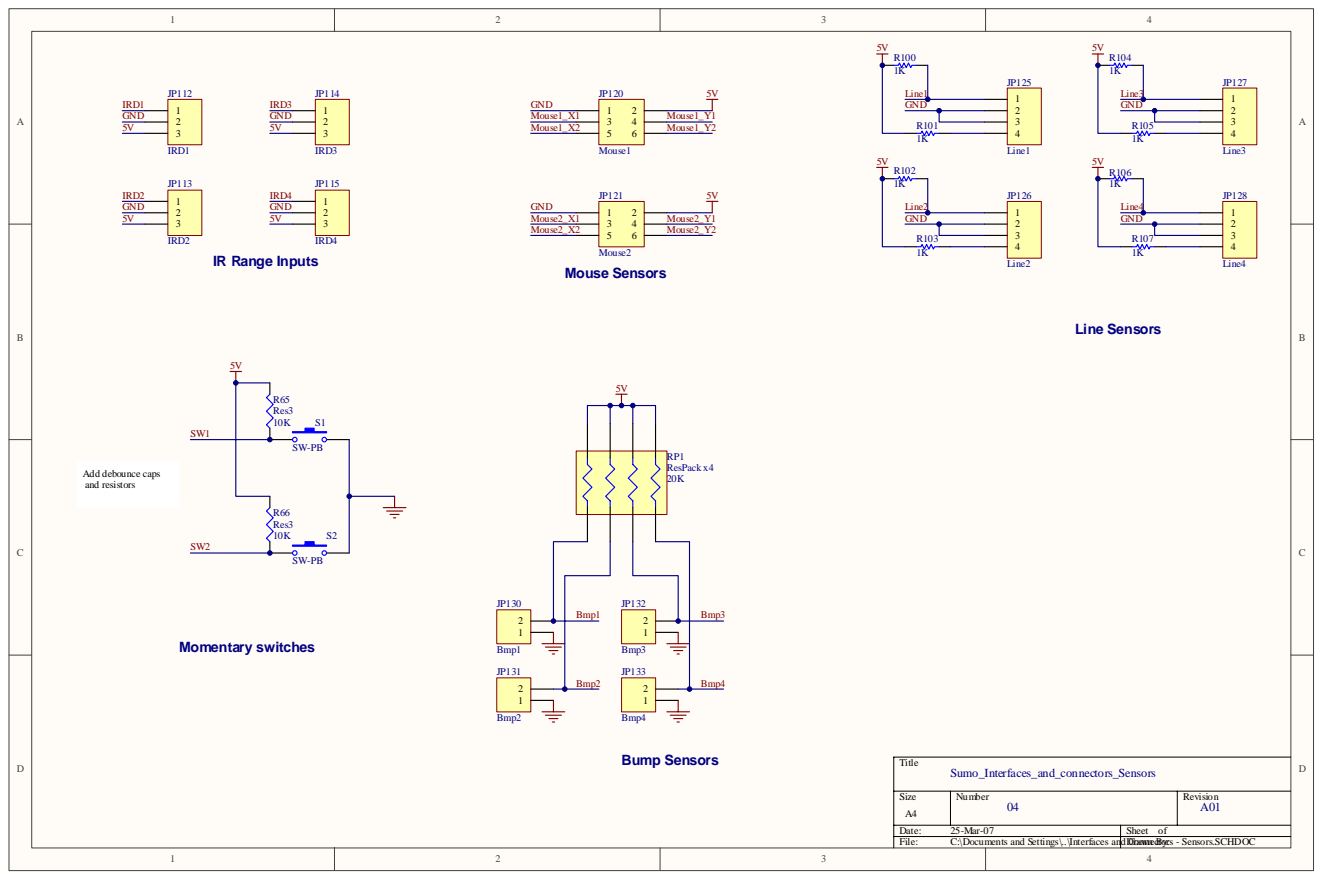
[picture p20: page 1]

Title Sumo_Interfaces_and_connectors_Sensors

Size A4 | Number | 04 | Revision A01

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
