BearXP/DLY_2014_Sumo/Electronics/2007-04-10 sch export/Microcontroller.pdf

## Static RAM Extension

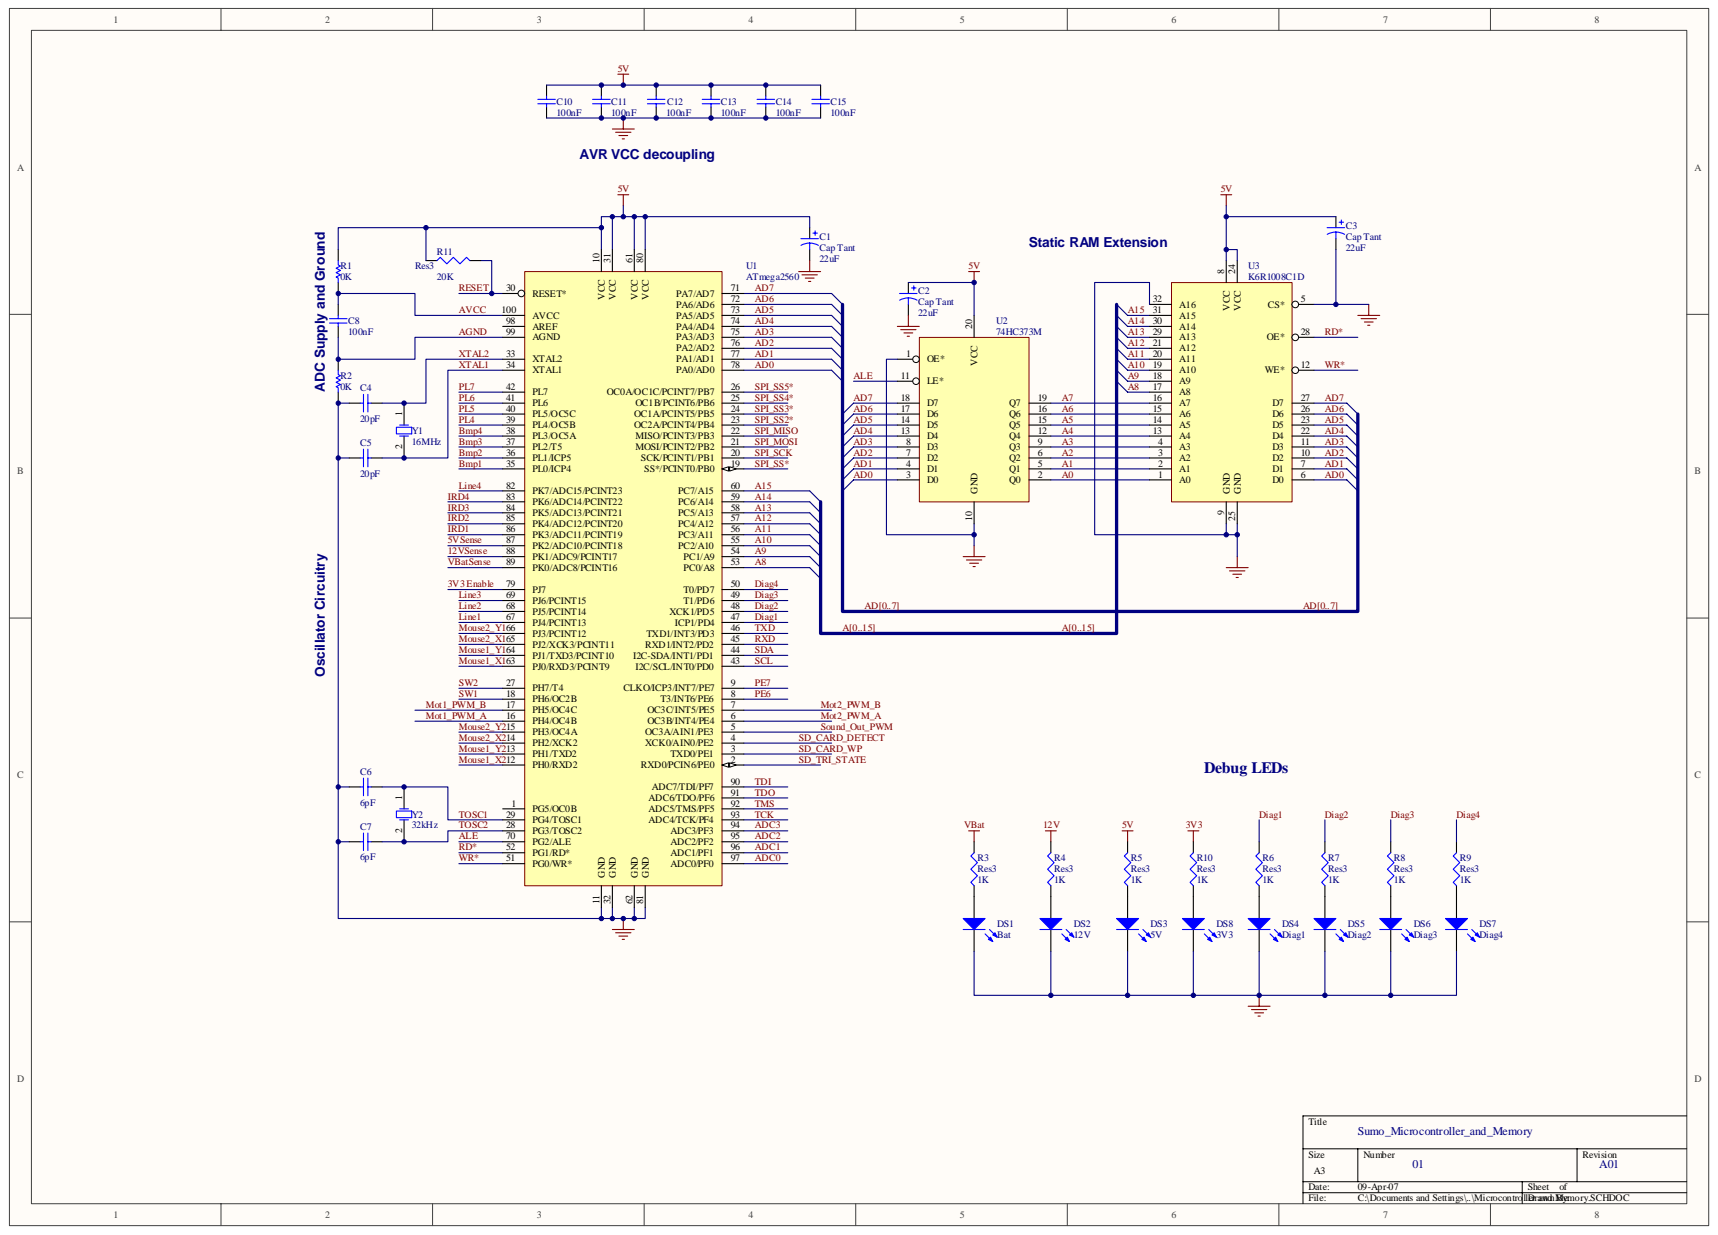
[picture p21: page 1]

5V AVR VCC decoupling | | | 5V | 5V

ADC Supply and Ground PL7

VCC 61 GND 62 AREF 98 AGND 99 AVCC 100

VCC 10 GND 11 XTAL2 33 XTAL1 34 I2C/SCL/INT0/PD0 43 I2C-SDA/INT1/PD1 44 RXD1/INT2/PD2 45 TXD1/INT3/PD3 46 ICP1/PD4 47 XCK1/PD5 48 T1/PD6 49 T0/PD7 50 PC0/A8 53 PC1/A9 54 PC2/A10 55 PC3/A11 56 PC4/A12 57 PC5/A13 58 PC6/A14 59 PC7/A15 60 PA7/AD7 71 PA6/AD6 72 PA5/AD5 73 PA4/AD4 74 PA3/AD3 75 PA2/AD2 76 PA1/AD1 77 PA0/AD0 78

RESET* 30

B | C8 100nF | AGND | SS*/PCINT0/PB0 | AD4 AD3 AD2 AD1 AD0 23 OC1A/PCINT5/PB5 24 OC1B/PCINT6/PB6 20 MOSI/PCINT2/PB2 19 SCK/PCINT1/PB1 26 21 MISO/PCINT3/PB3 22 OC2A/PCINT4/PB4 25 OC0A/OC1C/PCINT7/PB7 SPI_SS5* SPI_SS4* SPI_SS3* SPI_SS2* SPI_MISO SPI_MOSI SPI_SCK SPI_SS* A15 | A14 A13 A12 A11 A10 A9 A8 | A14 30 OE* | 28 RD* | B

VCC 20 GND 10 LE* 11 OE* 1 U2 74HC373M A7 A6 A5 A4 A3 A2 A1 A0

Title Sumo_Microcontroller_and_Memory

Size A3 | Number 01 | | Revision A01

Date: 09-Apr-07 | | Sheet of
File: C:\Documents and Settings\..\Microcontroller and Memory.SCHDOC Drawn By:
