BearXP/DLY_2014_Sumo/Electronics/2007-04-12 sch pcb export/Motor.pdf

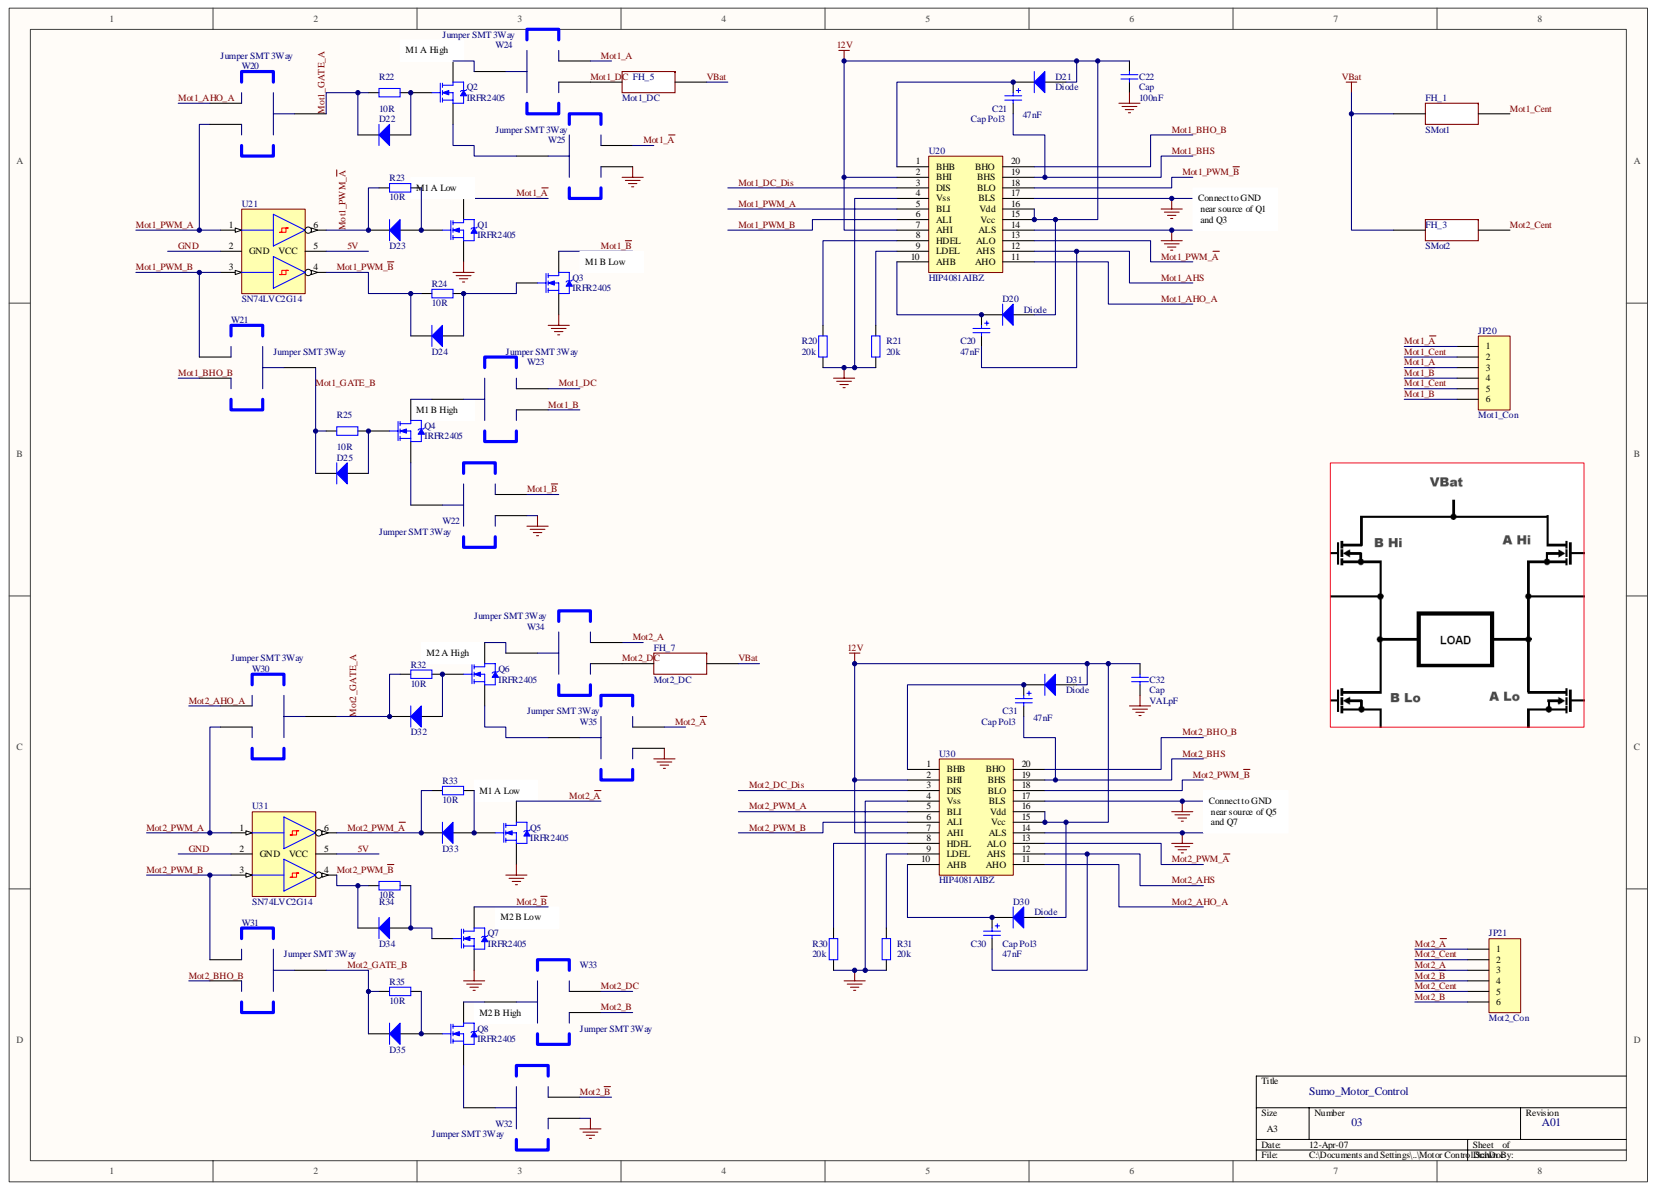
[picture p22: page 1]

W20 | | | | Mot1_DC_Dis Mot1_PWM_A | 12V | | VBat

AHI 7

LDEL 9

10R R34 | Mot2_B | R30 20k | D30 | Diode | Mot2_AHO_A | JP21

M2 B Low

Date: 12-Apr-07 | Sheet of
File: C:\Documents and Settings\..\Motor Control.SchDoc Drawn By:
