BearXP/DLY_2014_Sumo/Electronics/2007-04-23/Schematic Prints.pdf

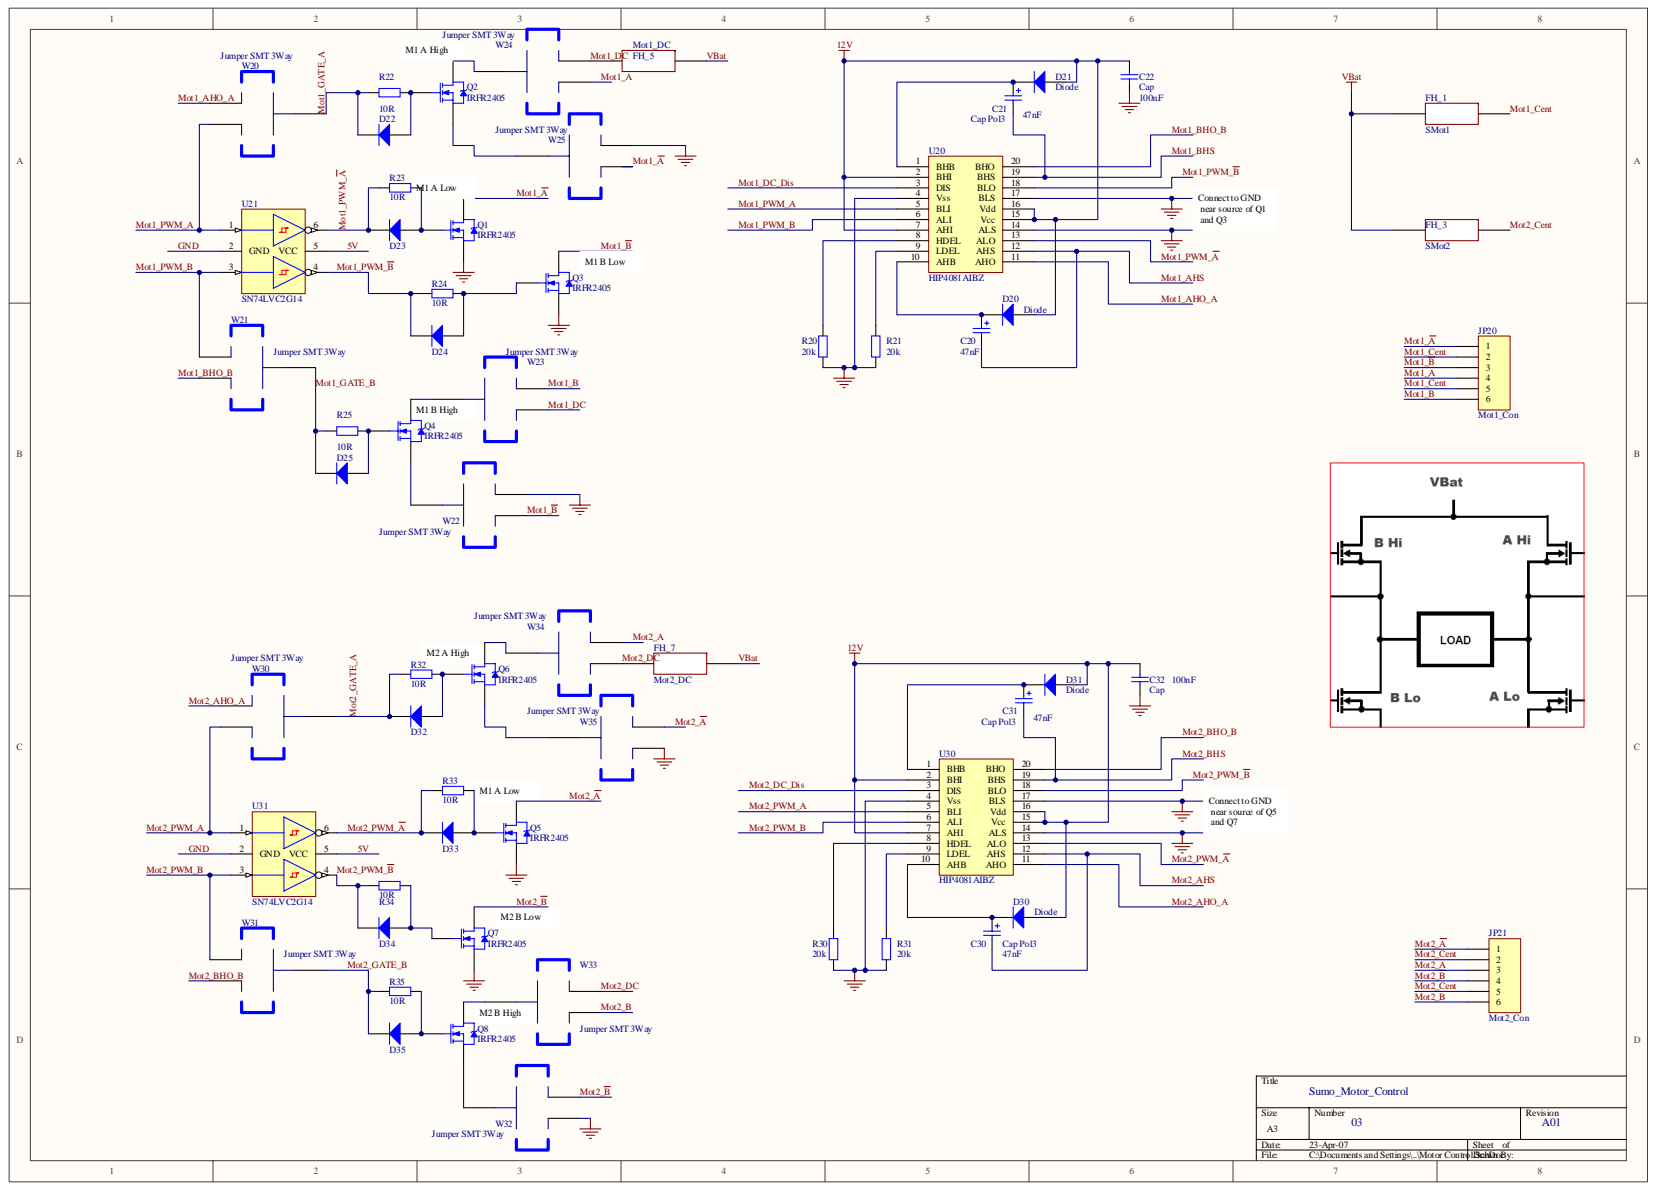
[picture p23: page 1]

AHI 7

LDEL 9

10R R34 | Mot2_B | R30 20k | D30 | Diode | Mot2_AHO_A | JP21

M2 B Low

Date: 23-Apr-07 | Sheet of
File: C:\Documents and Settings\..\Motor Control.SchDoc Drawn By:

## Static RAM Extension

## AVR VCC decoupling

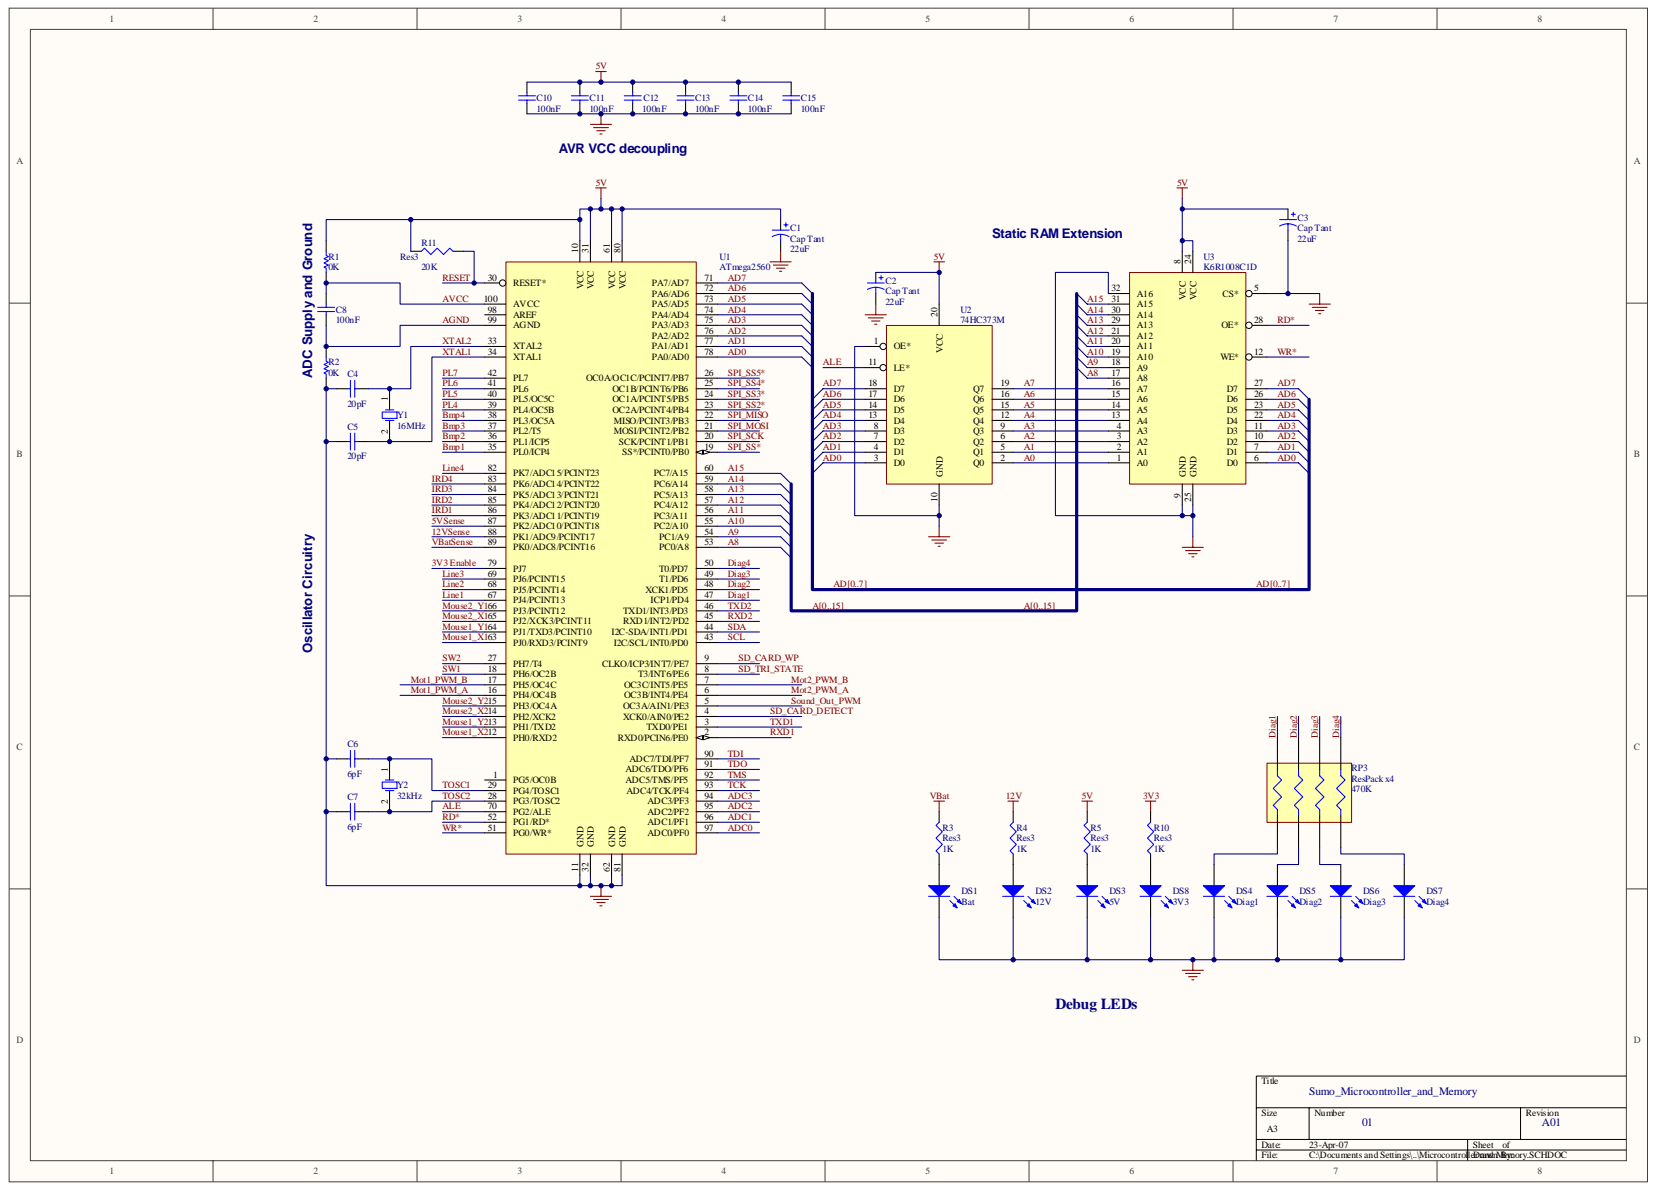
[picture p24: page 2]

ADC Supply and Ground PL7

VCC 61 GND 62 AREF 98 AGND 99 AVCC 100

VCC 20 GND 10 LE* 11 OE* 1 U2 74HC373M A7 A6 A5 A4 A3 A2 A1 A0

Title Sumo_Microcontroller_and_Memory

A | A

1

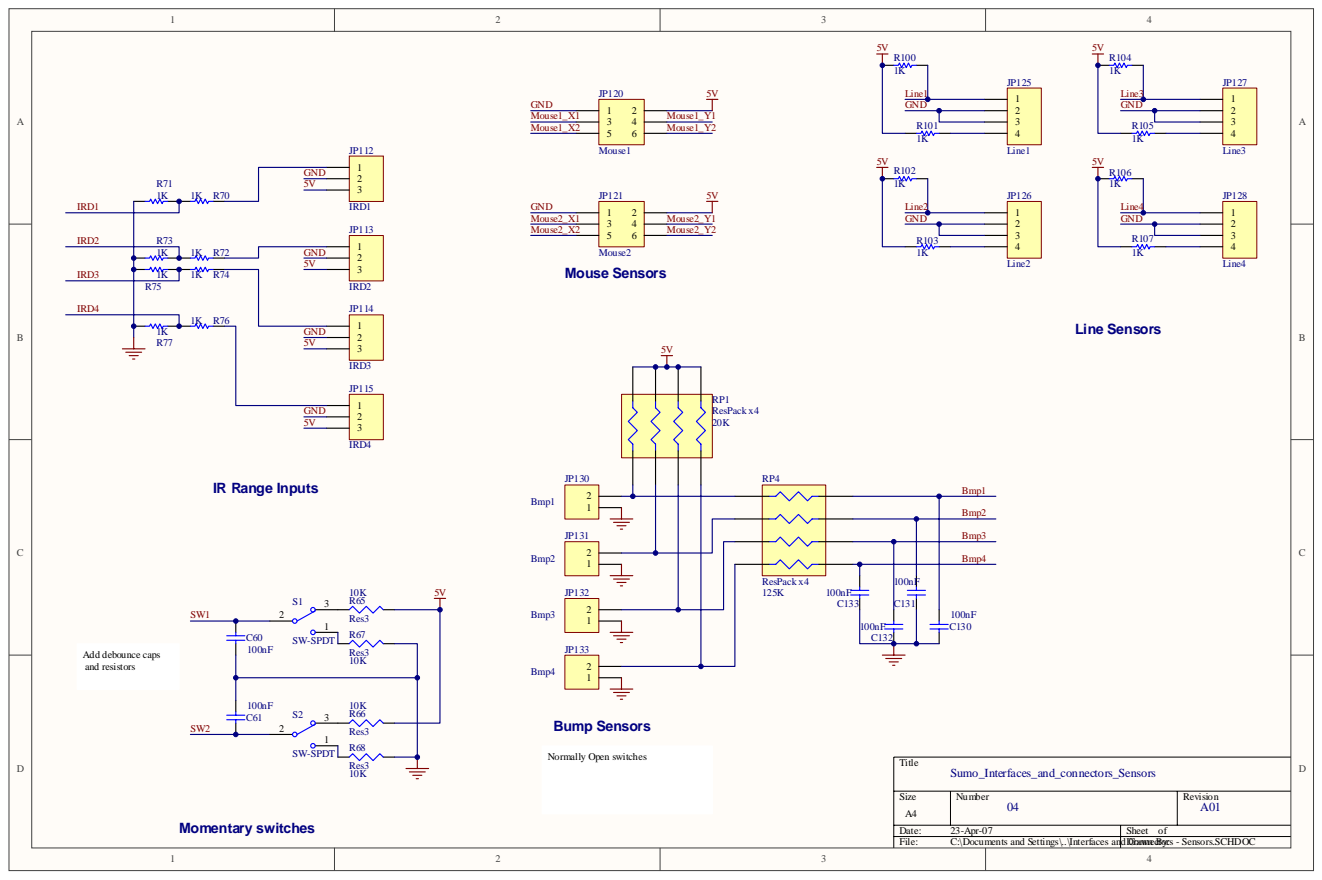
[picture p25: page 3]

Title Sumo_Interfaces_and_connectors_Sensors

Size A4 | Number | 04 | Revision A01

## JTAG Programming Interface

## RS-232 Interface

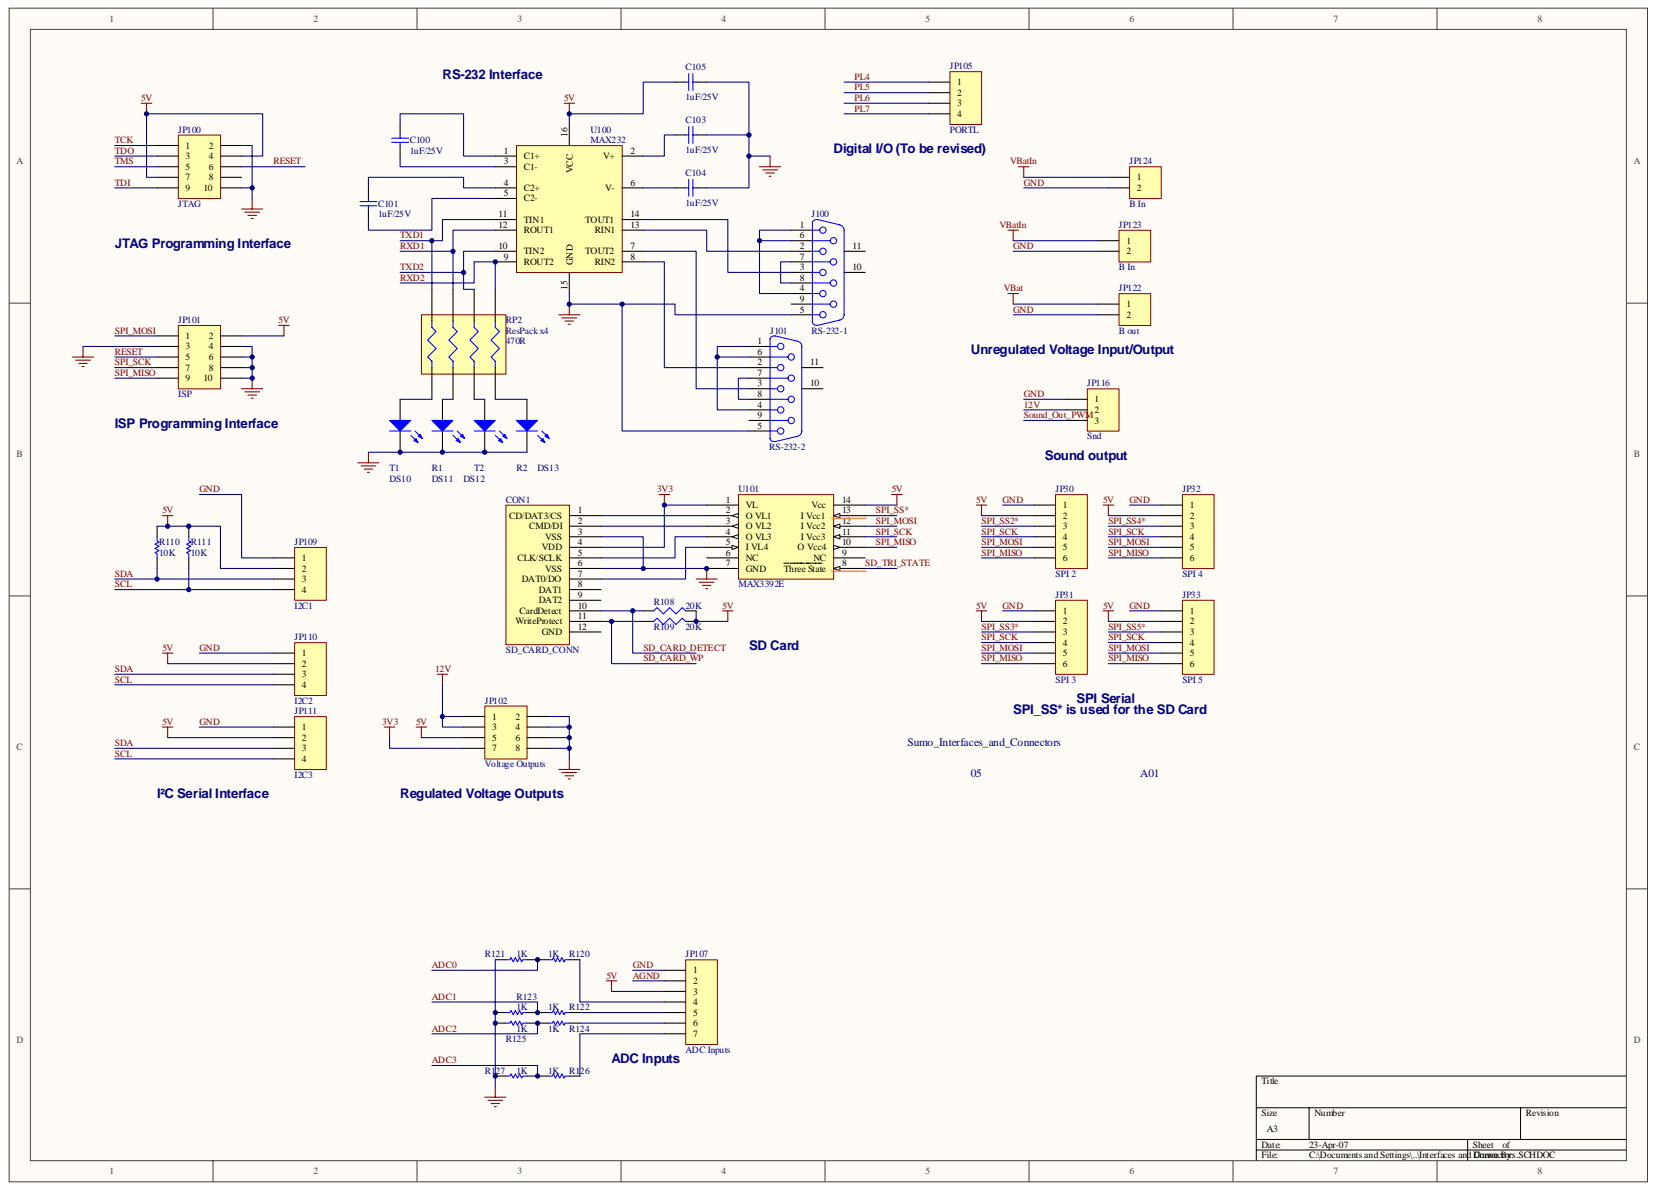
[picture p26: page 4]

Digital I/O (To be revised)

Unregulated Voltage Input/Output

SPI_SS* is used for the SD Card

A | A

### VBat

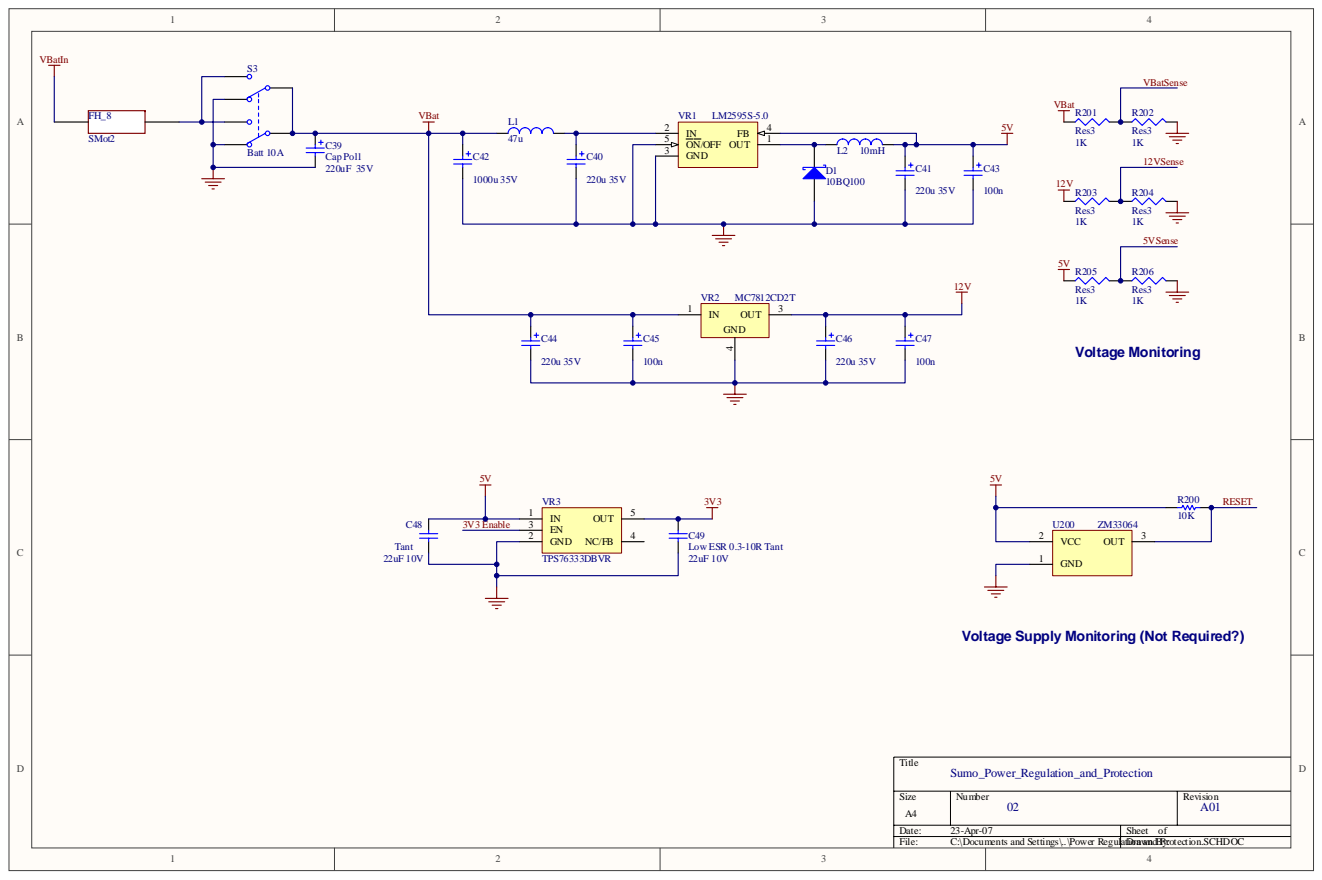
[picture p27: page 5]

Voltage Supply Monitoring (Not Required?)

Title Sumo_Power_Regulation_and_Protection

Size A4 | Number | 02 | Revision A01

D | D
B | B
C | | C
A | A

### Title

Size A4 | Number | Revision
File: | C:\Documents and Settings\..\Schematic of Schematics.SCHDOC Drawn By:

### Microcontroller and Memory Microcontroller and Memory.schdoc

### Interfaces and Connectors Interfaces and Connectors.schdoc

### Power Regulation and Protection Power Regulation and Protection.schdoc

### Motor Control Motor Control.SchDoc

### Interfaces and Connectors - Sensors Interfaces and Connectors - Sensors.schdoc
