BearXP/DLY_2014_Sumo/Electronics/2007-07-30 sch pcb export/Motor Schematics.pdf

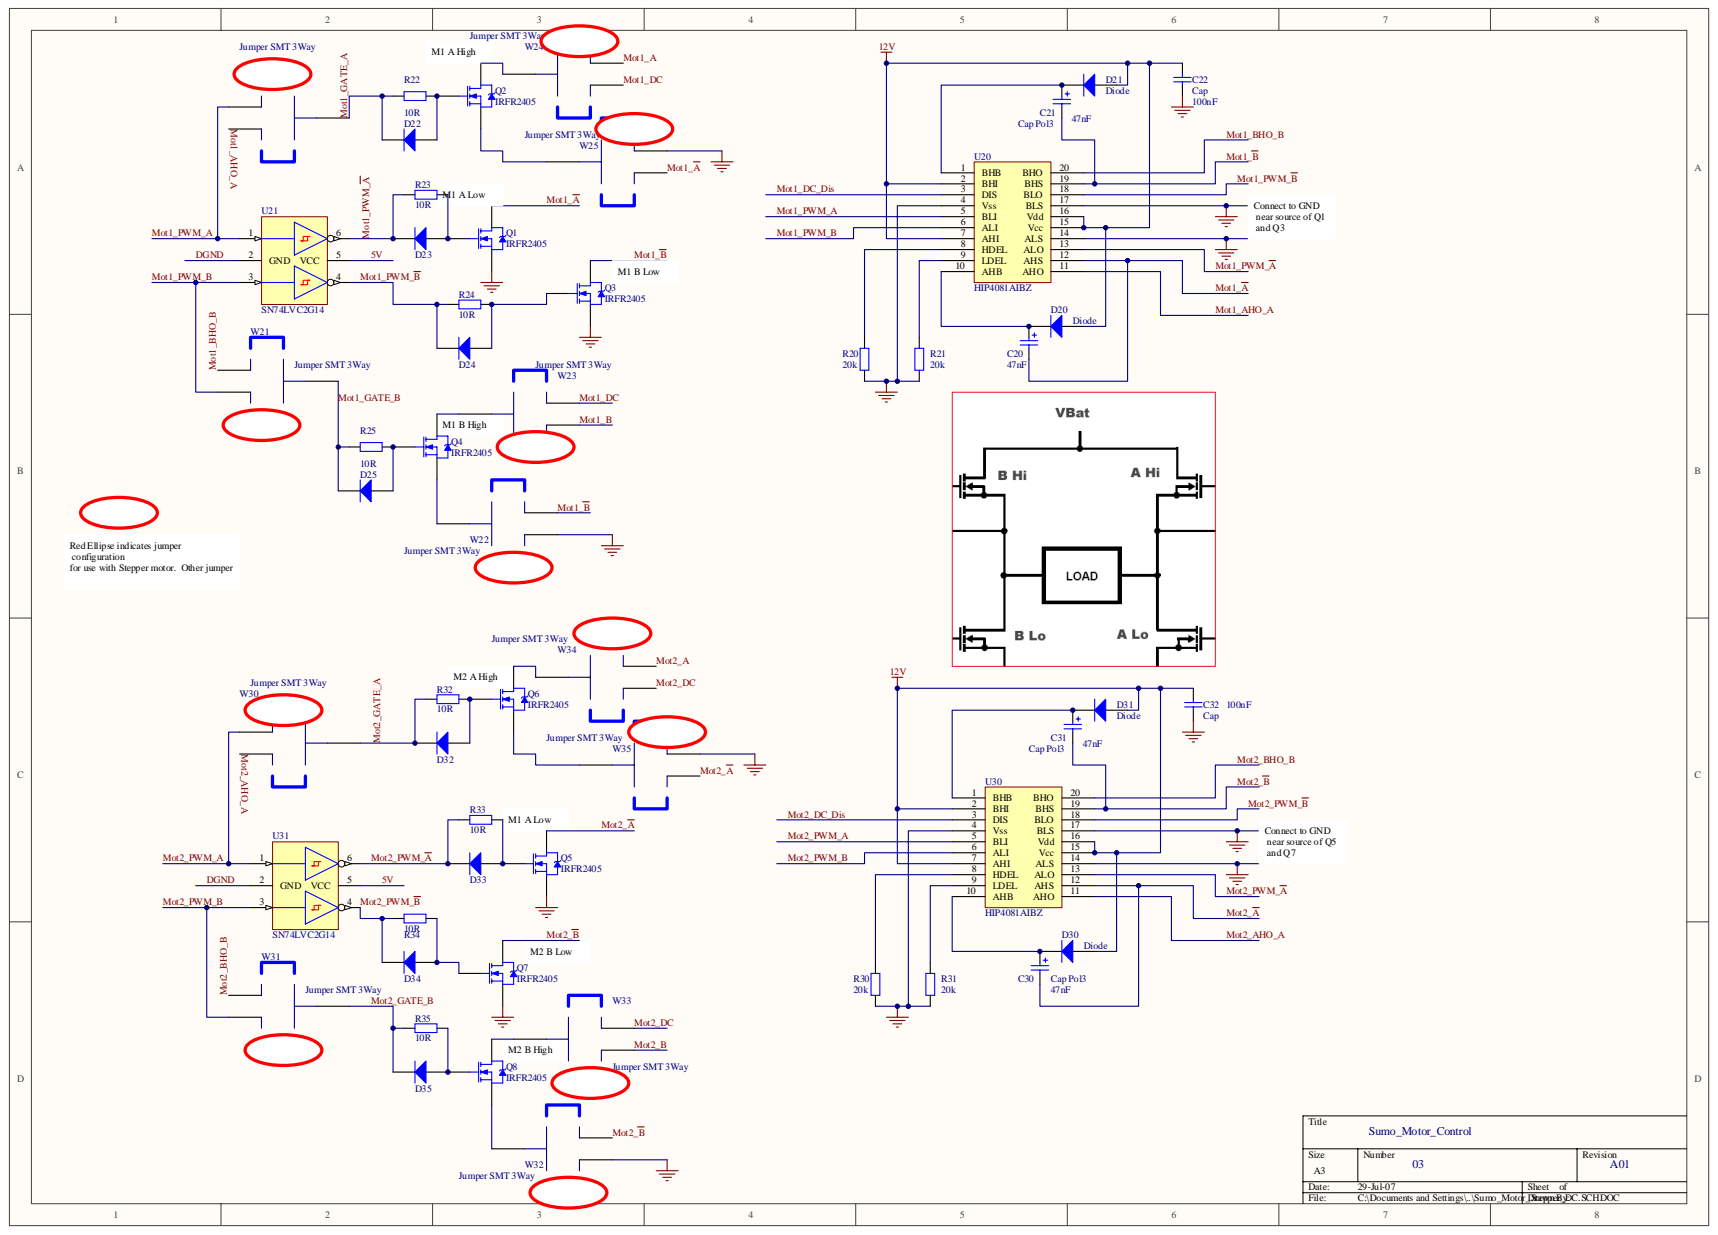
[picture p28: page 1]

LDEL 9

M1 B Low

Red Ellipse indicates jumper
configuration
for use with Stepper motor. Other jumper

Connect to GND near source of Q5 and Q7

AHI 7

10R R34 | Mot2_B | D30 | Diode | Mot2_AHO_A

M2 B Low

Date: 29-Jul-07 | Sheet of
File: C:\Documents and Settings\..\Sumo_Motor_Stepper_DC.SCHDOC Drawn By:

A | A

## VBat

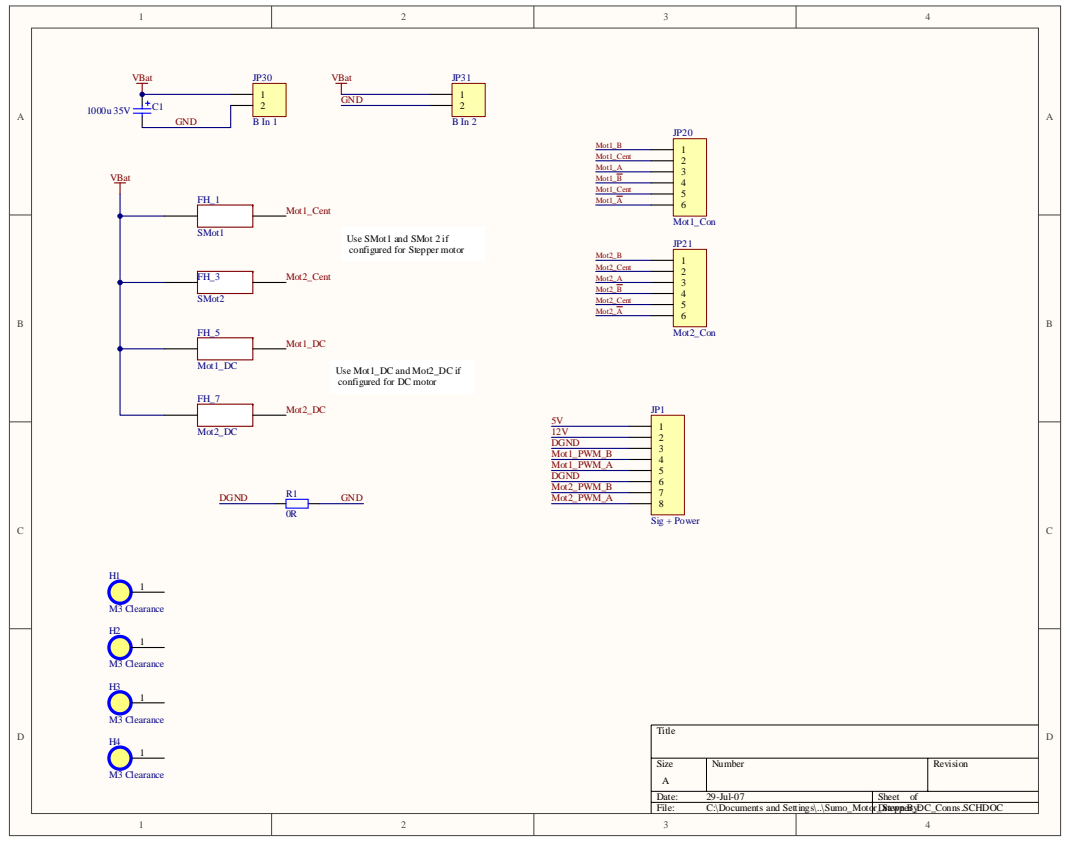
[picture p29: page 2]
Mot1_Cent; Mot2_Cent; SMot2; SMot1; GND; VBat; Mot1_A; Mot1_B; Mot1_Con; Mot2_A; Mot2_B; Mot2_Con; Mot1_DC; Mot2_DC; Sig + Power; Mot1_PWM_A; Mot1_PWM_B; Mot2_PWM_A; Mot2_PWM_B; DGND; M3 Clearance; R1 DGND

Use SMot1 and SMot 2 if
configured for Stepper motor

Use Mot1_DC and Mot2_DC if
configured for DC motor

1 M3 Clearance H3 1 M3 Clearance H4 1 M3 Clearance

Title

Size A | Number | Revision

File: C:\Documents and Settings\..\Sumo_Motor_Stepper_DC_Conns.SCHDOC Drawn By:

D | D
B | B
C | C
A | A

## Title

Size A | Number | Revision
File: | C:\Documents and Settings\..\Sumo_Motor_Stepper_DC_TopLevel.SCHDOC Drawn By:

## Control Sumo_Motor_Stepper_DC.SCHDOC

## Connectors Sumo_Motor_Stepper_DC_Conns.SCHDOC
