BearXP/DLY_2014_Sumo/Electronics/2007-04-16/Sumobot/MCU and Memory.pdf

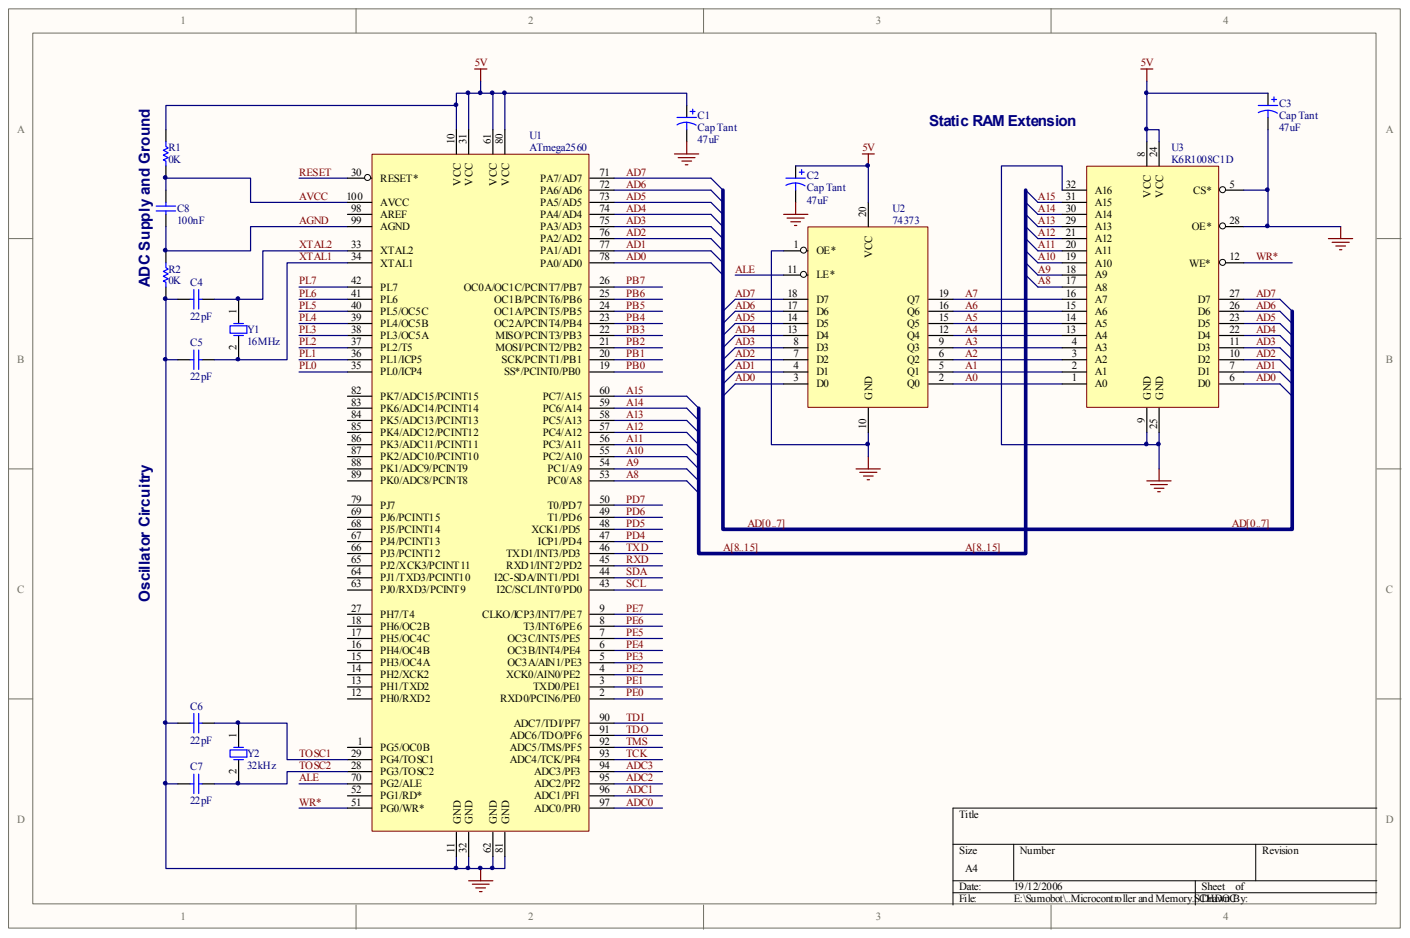
[picture p34: page 1]

ADC Supply and Ground
