BearXP/DLY_2014_Sumo/Electronics/2007-04-16/Sumobot/Power Regulation and Protection.pdf

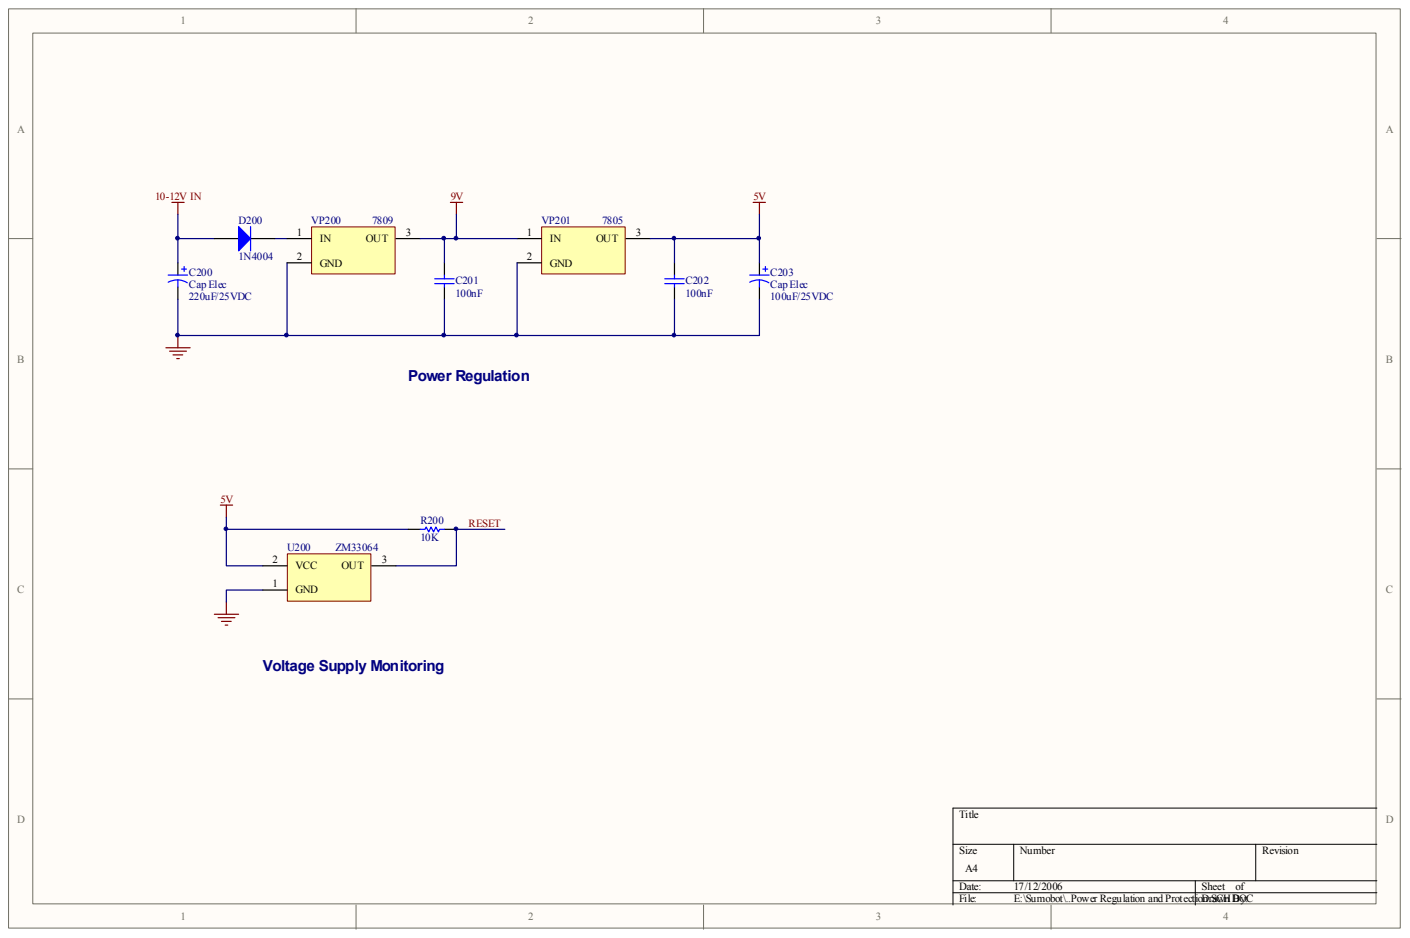
[picture p35: page 1]
Title; Size; Number; Revision; Date:; Sheet of; File:; E:\Sumobot\..Power Regulation and Protection.S Drawn By: CHDOC; 220uF/25VDC; Cap Elec; 100uF/25VDC; C203 Cap Elec; Power Regulation; RESET; OUT; GND 2; VCC 2; GND 1

Voltage Supply Monitoring
