BearXP/DLY_2014_Sumo/Electronics/2007-04-16/Sumobot/PDFs/Motor Control.pdf

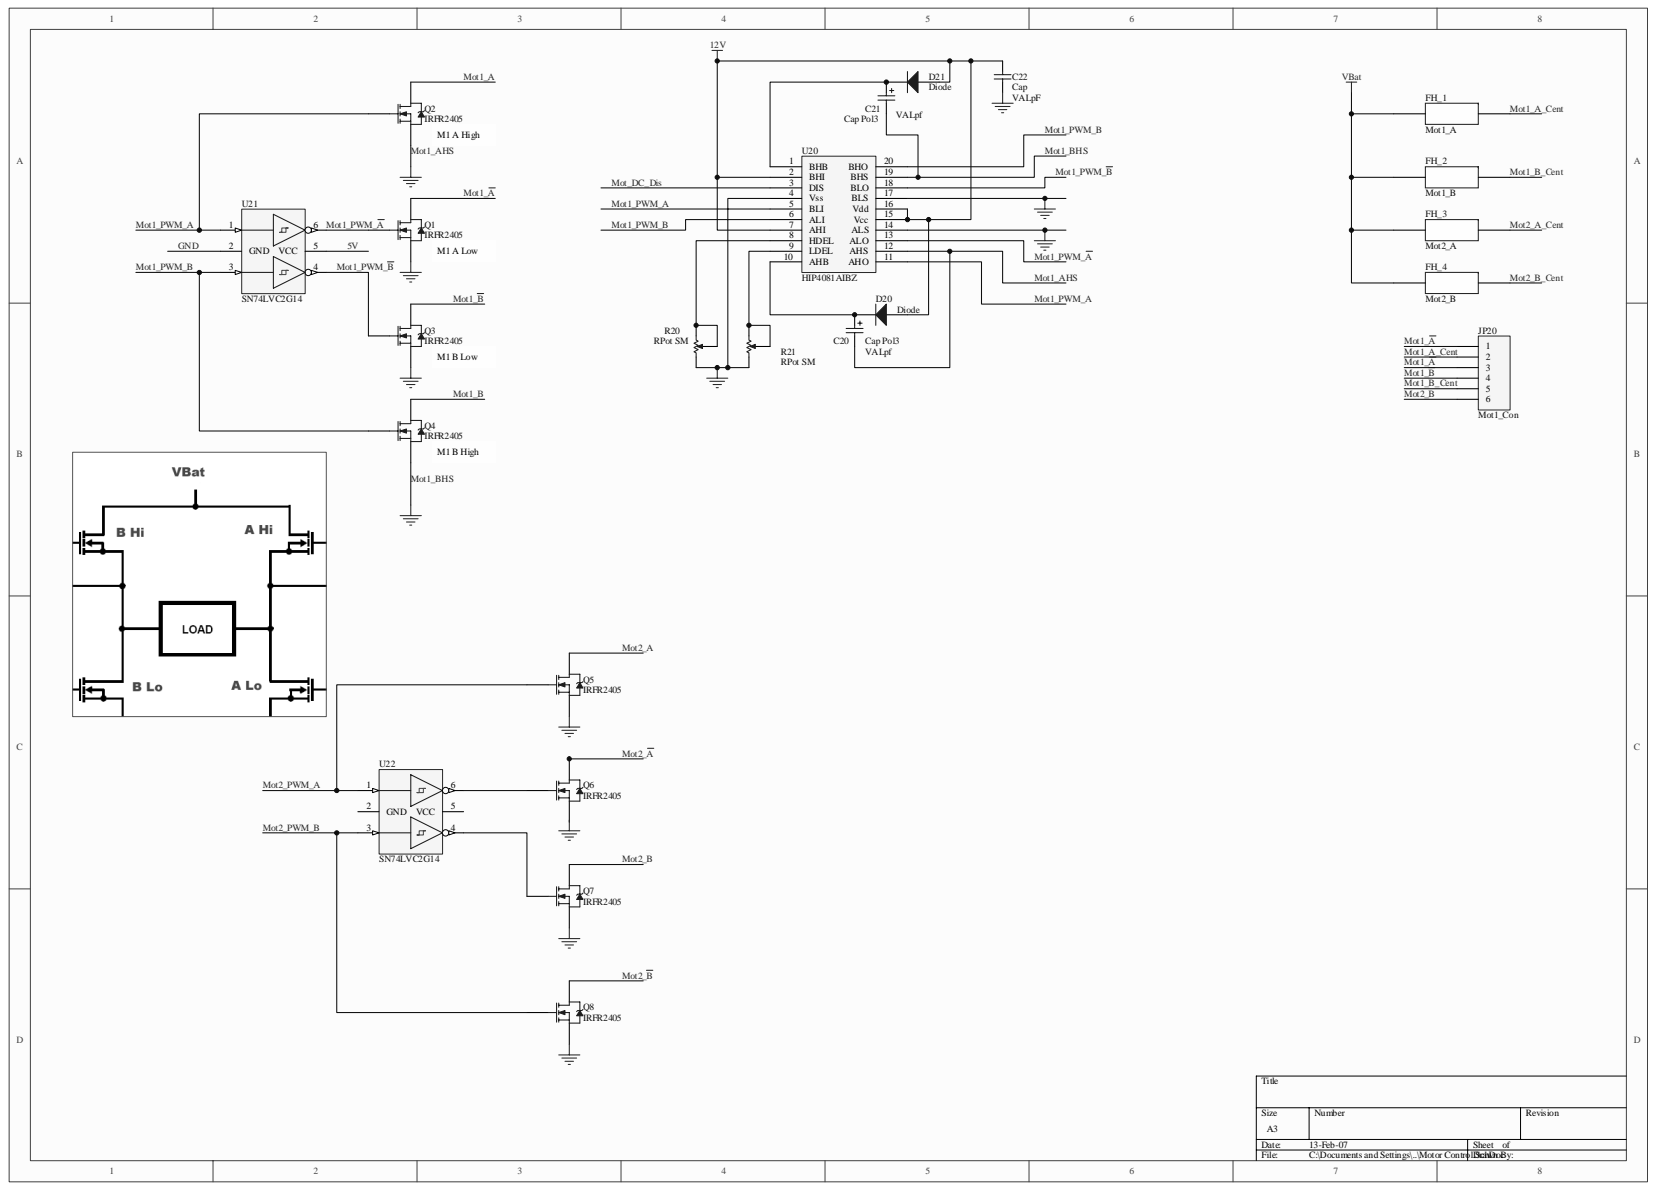
[picture p36: page 1]

Mot1_A | 12V | | Mot1_PWM_B Mot1_BHS Mot1_PWM_A Mot1_AHS Mot1_PWM_A | VBat

B | | Q3 IRFR2405 | Diode | Mot1_A Mot1_A Mot1_B Mot2_B | JP20 | B

VALpf

C | Mot2_A Mot2_A Mot2_B | C

Mot2_B

Title

Size A3 | Number | | Revision

Date: 13-Feb-07 | | Sheet of
File: C:\Documents and Settings\..\Motor Control.SchDoc Drawn By:
