BearXP/DLY_2014_Sumo/Electronics/2007-05-31 quote requested/exports/2007-05-23/Schematic Prints.pdf

## Static RAM Extension

## AVR VCC decoupling

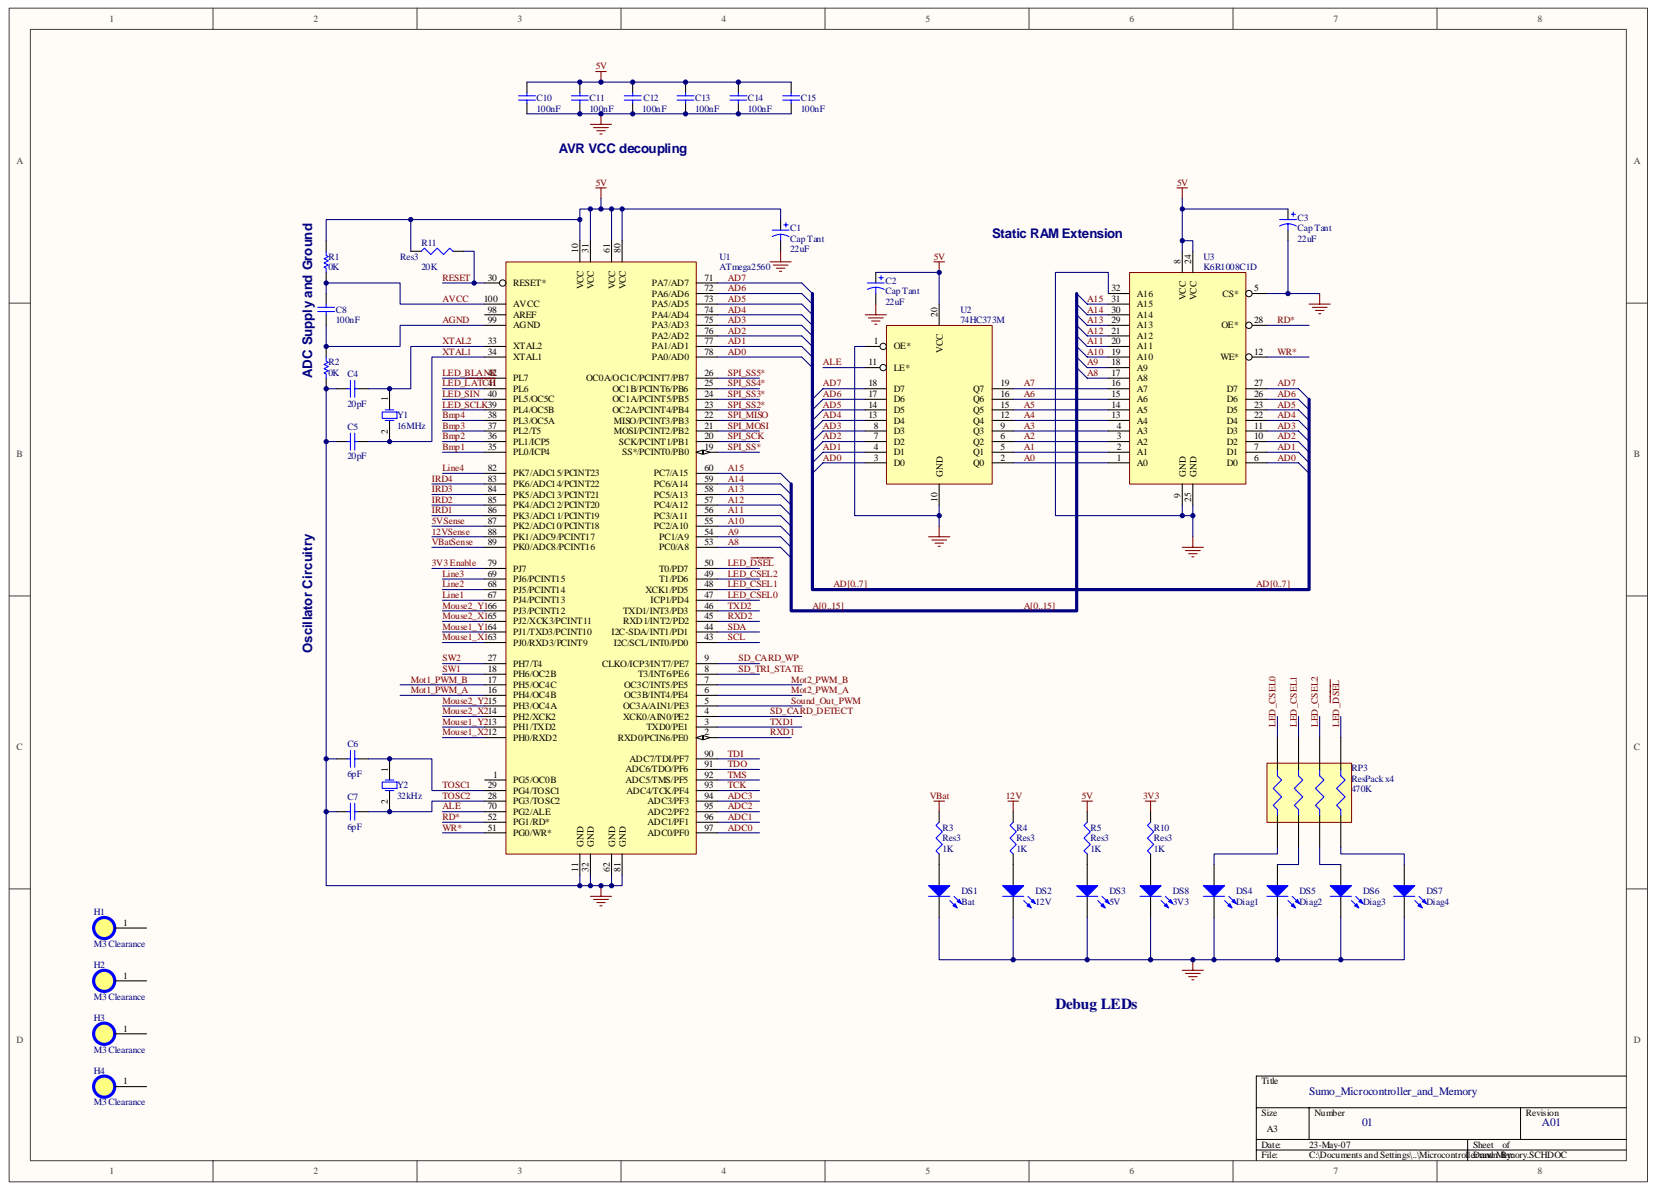
[picture p41: page 1]

ADC Supply and Ground

VCC 61 GND 62 AREF 98 AGND 99 AVCC 100

VCC 20 GND 10 LE* 11 OE* 1 U2 74HC373M A7 A6 A5 A4 A3 A2 A1 A0

Title Sumo_Microcontroller_and_Memory

Size A3 | Number 01 | | Revision A01

Date: 23-May-07 | | Sheet of
File: C:\Documents and Settings\..\Microcontroller and Memory.SCHDOC Drawn By:

A | A

1

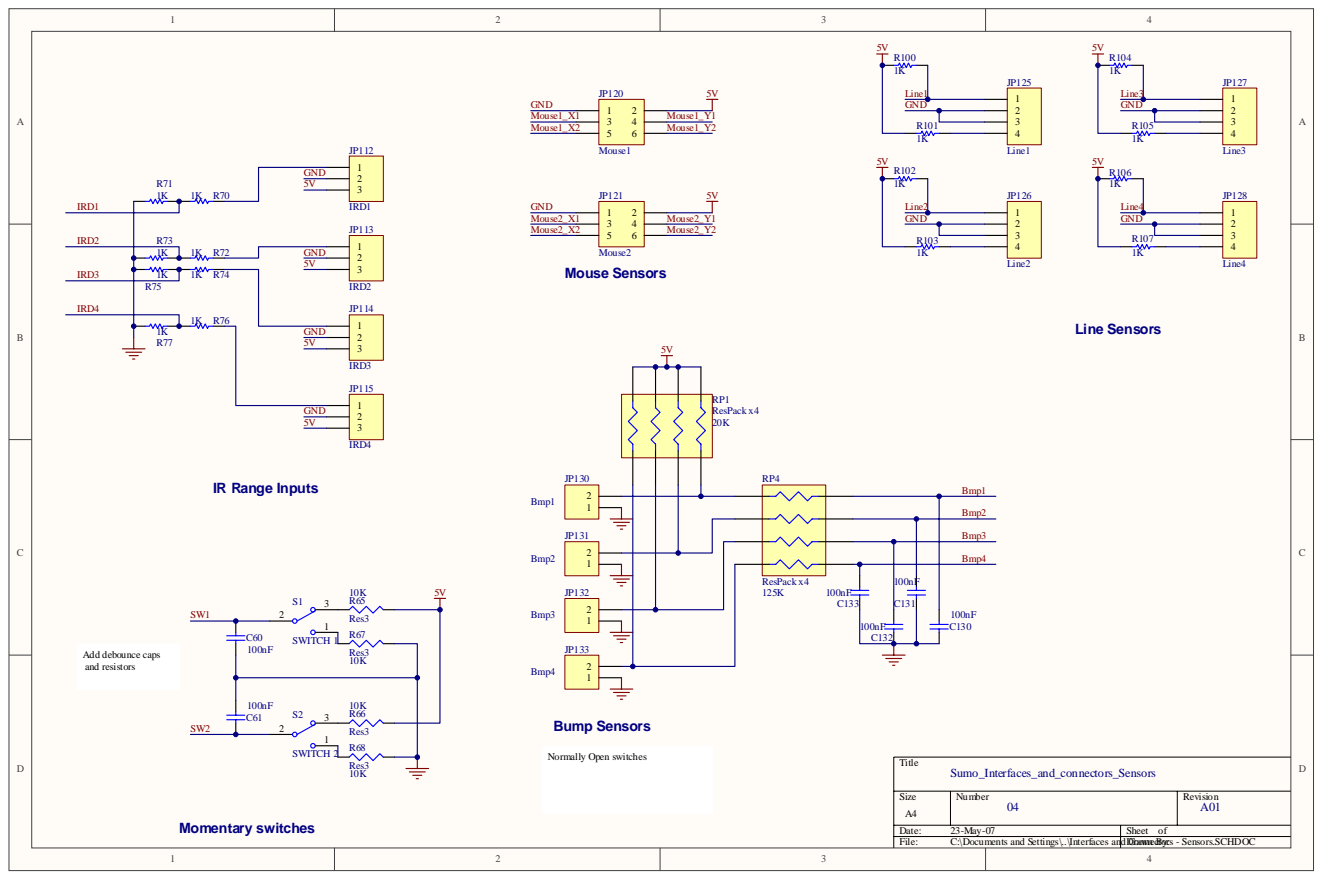
[picture p42: page 2]

Title Sumo_Interfaces_and_connectors_Sensors

Size A4 | Number | 04 | Revision A01

## JTAG Programming Interface

## RS-232 Interface

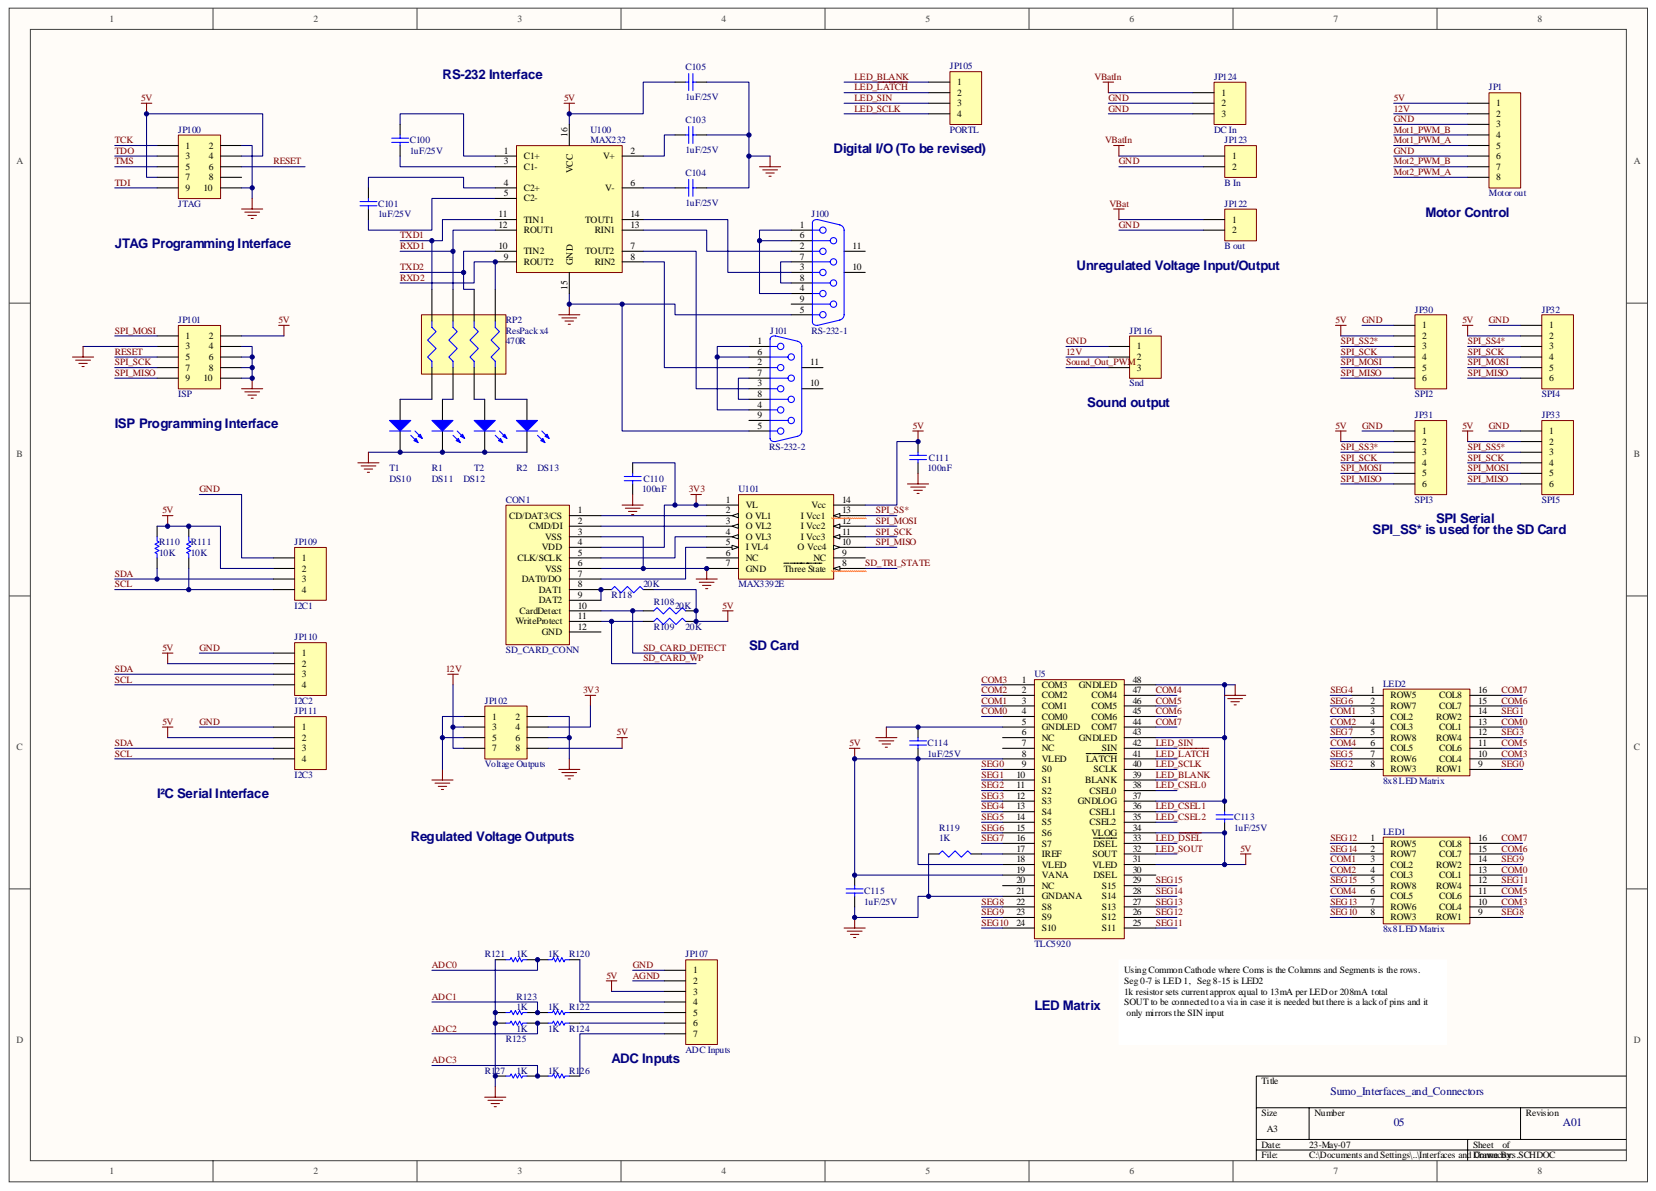
[picture p43: page 3]

Digital I/O (To be revised)

Unregulated Voltage Input/Output

SPI_SS* is used for the SD Card

VANA 19 NC 20 | SEG15

R121 1K 1K R120 | JP107 | GNDANA 21 | COL5 6 ROW6 7

Using Common Cathode where Coms is the Columns and Segments is the rows.
Seg 0-7 is LED 1, Seg 8-15 is LED2
1k resistor sets current approx equal to 13mA per LED or 208mA total
SOUT to be connected to a via in case it is needed but there is a lack of pins and it
only mirrors the SIN input

Title Sumo_Interfaces_and_Connectors

Size A3 | Number 05 | Revision A01

A | A

### VBat

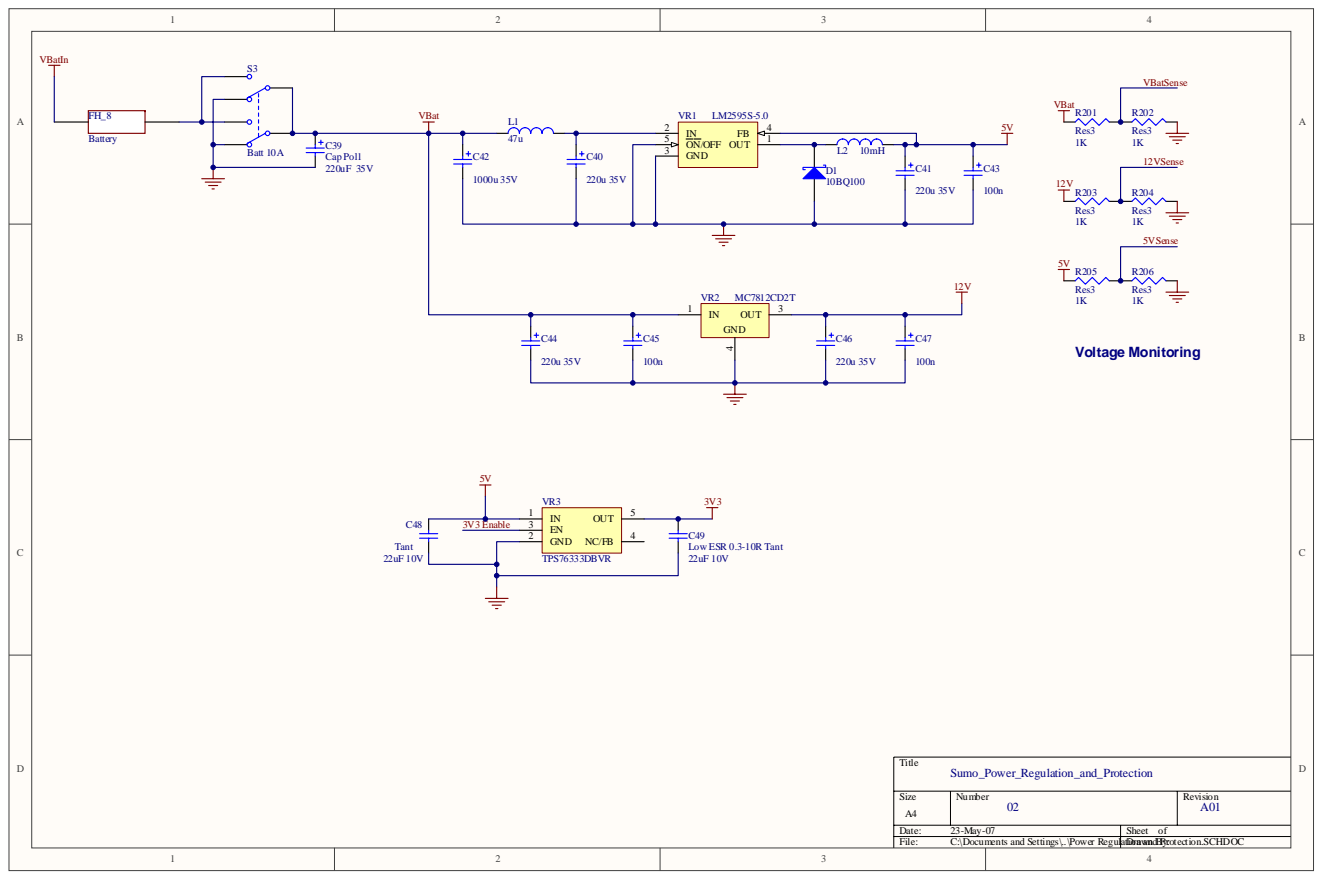
[picture p44: page 4]

Title Sumo_Power_Regulation_and_Protection

Size A4 | Number | 02 | Revision A01

D | D
B | B
C | | C
A | A

### Title

Size A4 | Number | Revision
File: | C:\Documents and Settings\..\Schematic of Schematics.SCHDOC Drawn By:

### Microcontroller and Memory Microcontroller and Memory.schdoc

### Interfaces and Connectors Interfaces and Connectors.schdoc

### Power Regulation and Protection Power Regulation and Protection.schdoc

### Interfaces and Connectors - Sensors Interfaces and Connectors - Sensors.schdoc
