BearXP/DLY_2014_Sumo/Electronics/2007-04-16/Sumobot/PDFs/21-03-2007/Interfaces and Connectors sensors.pdf

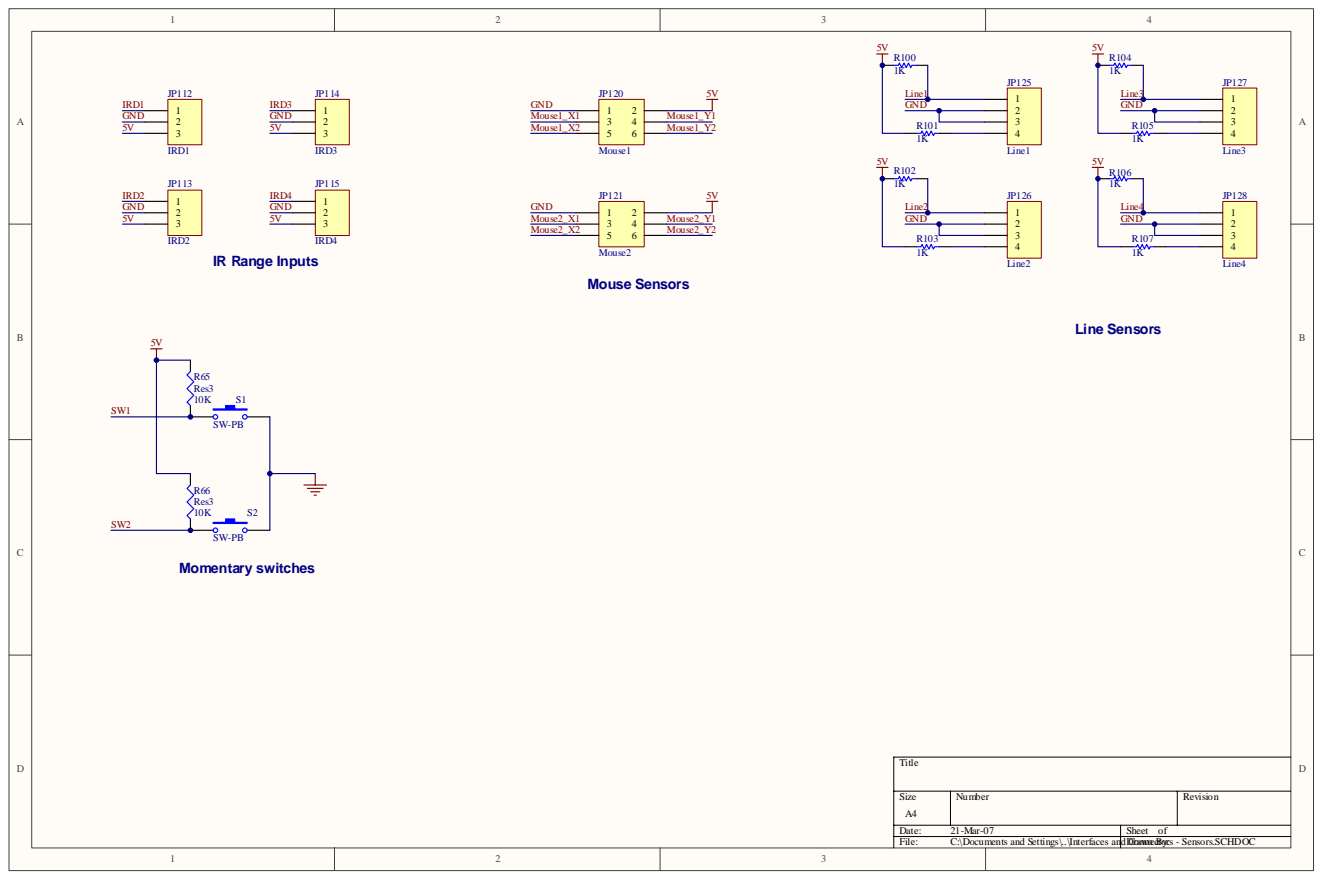
[picture p45: page 1]

Title

Size A4 | Number | | Revision

Date: 21-Mar-07 | | Sheet of
File: C:\Documents and Settings\..\Interfaces and Connectors - Sensors.SCHDOC Drawn By:
