BearXP/DLY_2014_Sumo/Electronics/2007-04-16/Sumobot/PDFs/21-03-2007/Interfaces and Connectors.pdf

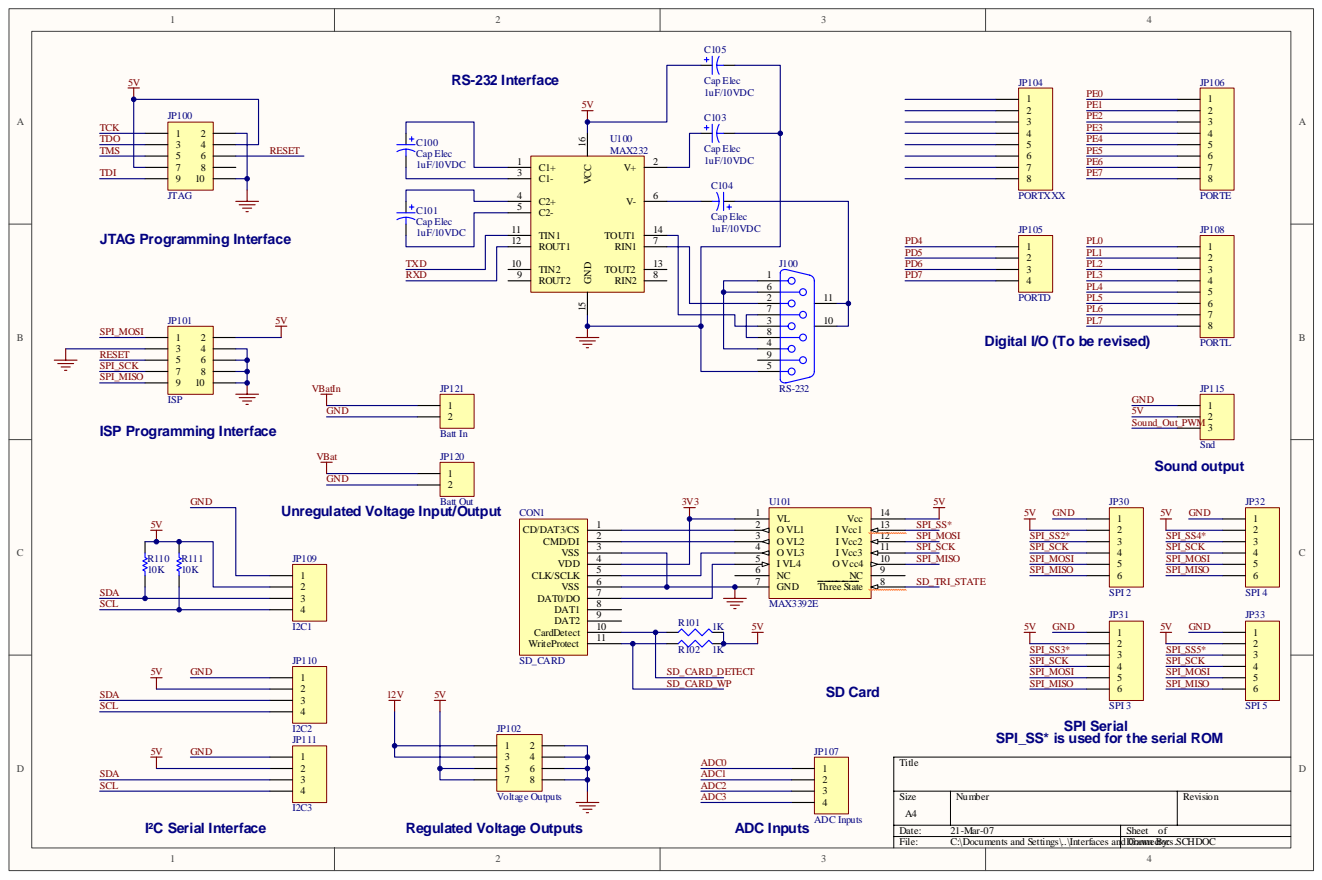
[picture p46: page 1]

RS-232 Interface 5V | C105 | JP104 JP106

Digital I/O (To be revised)

GND
Unregulated Voltage Input/Output

SPI_SS* is used for the serial ROM

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
