BearXP/DLY_2014_Sumo/Electronics/2007-04-16/Sumobot/PDFs/22-03-2007/Interfaces and Connectors - Sensors.pdf

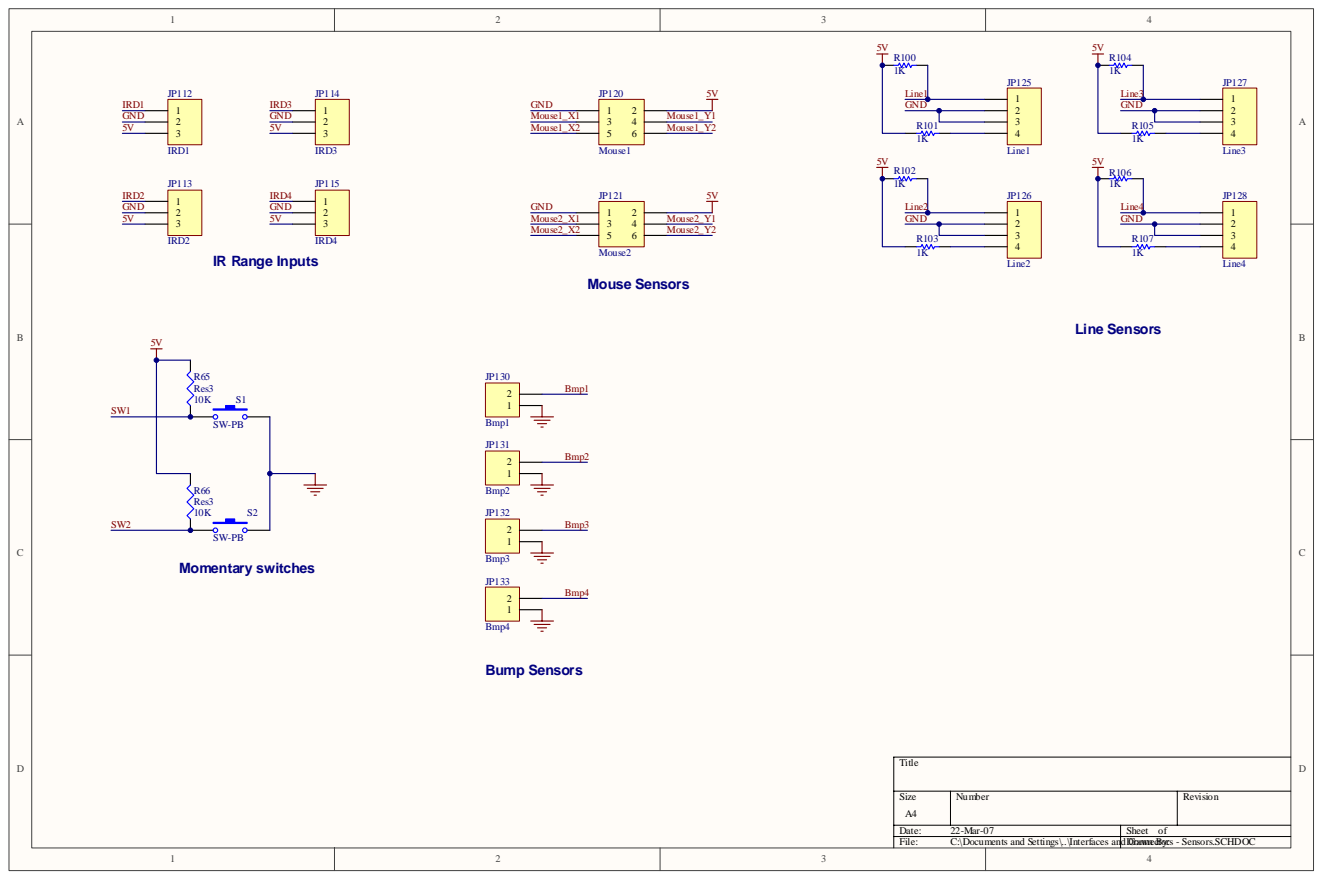
[picture p47: page 1]

Bump Sensors

Title

Size A4 | Number | | Revision

Date: 22-Mar-07 | | Sheet of
File: C:\Documents and Settings\..\Interfaces and Connectors - Sensors.SCHDOC Drawn By:
