BearXP/DLY_2014_Sumo/Electronics/2007-07-30 sch pcb export/sumoPCBgrid.pdf

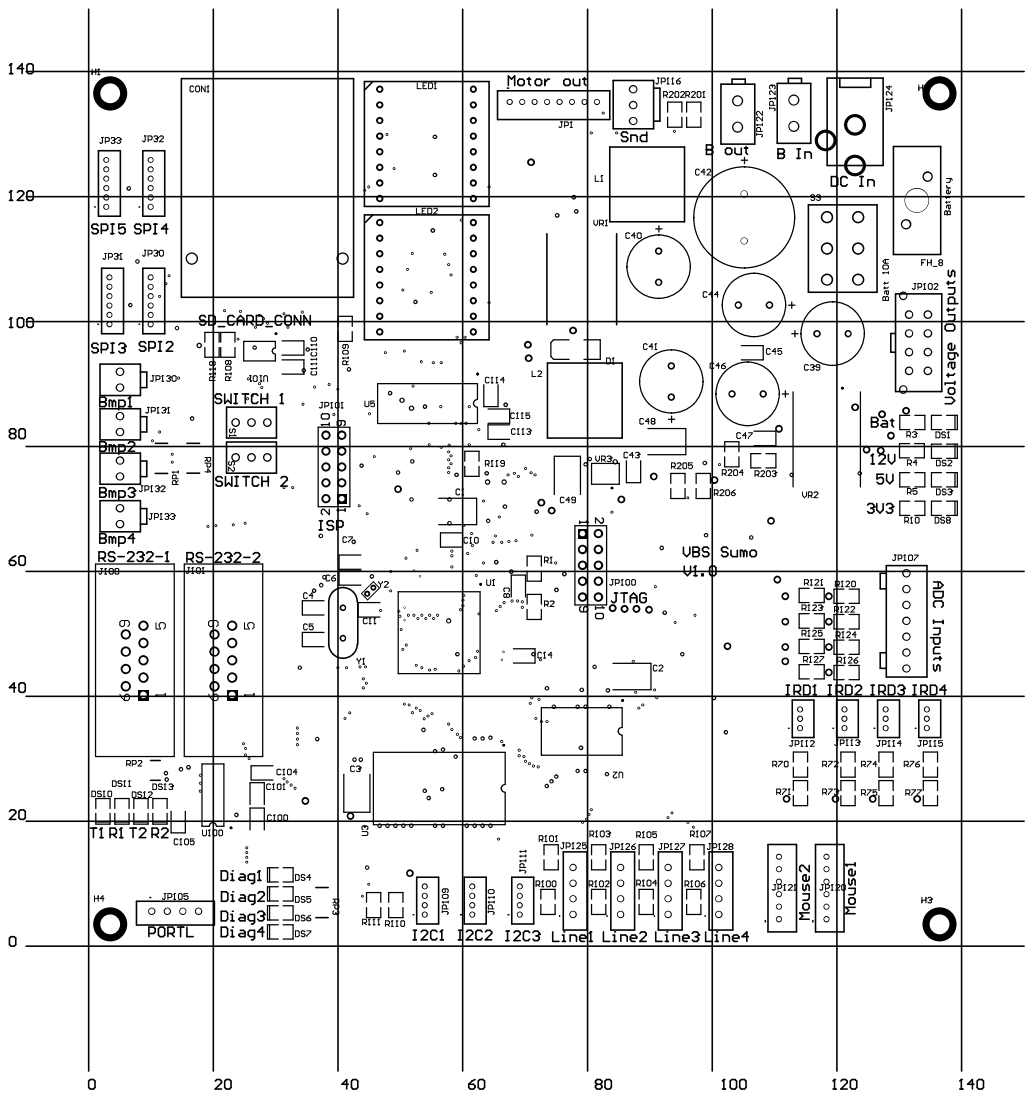
[picture p48: page 1]
