BearXP/DLY_2014_Sumo/Electronics/2007-04-16/Sumobot/Interfaces and Connectors.pdf

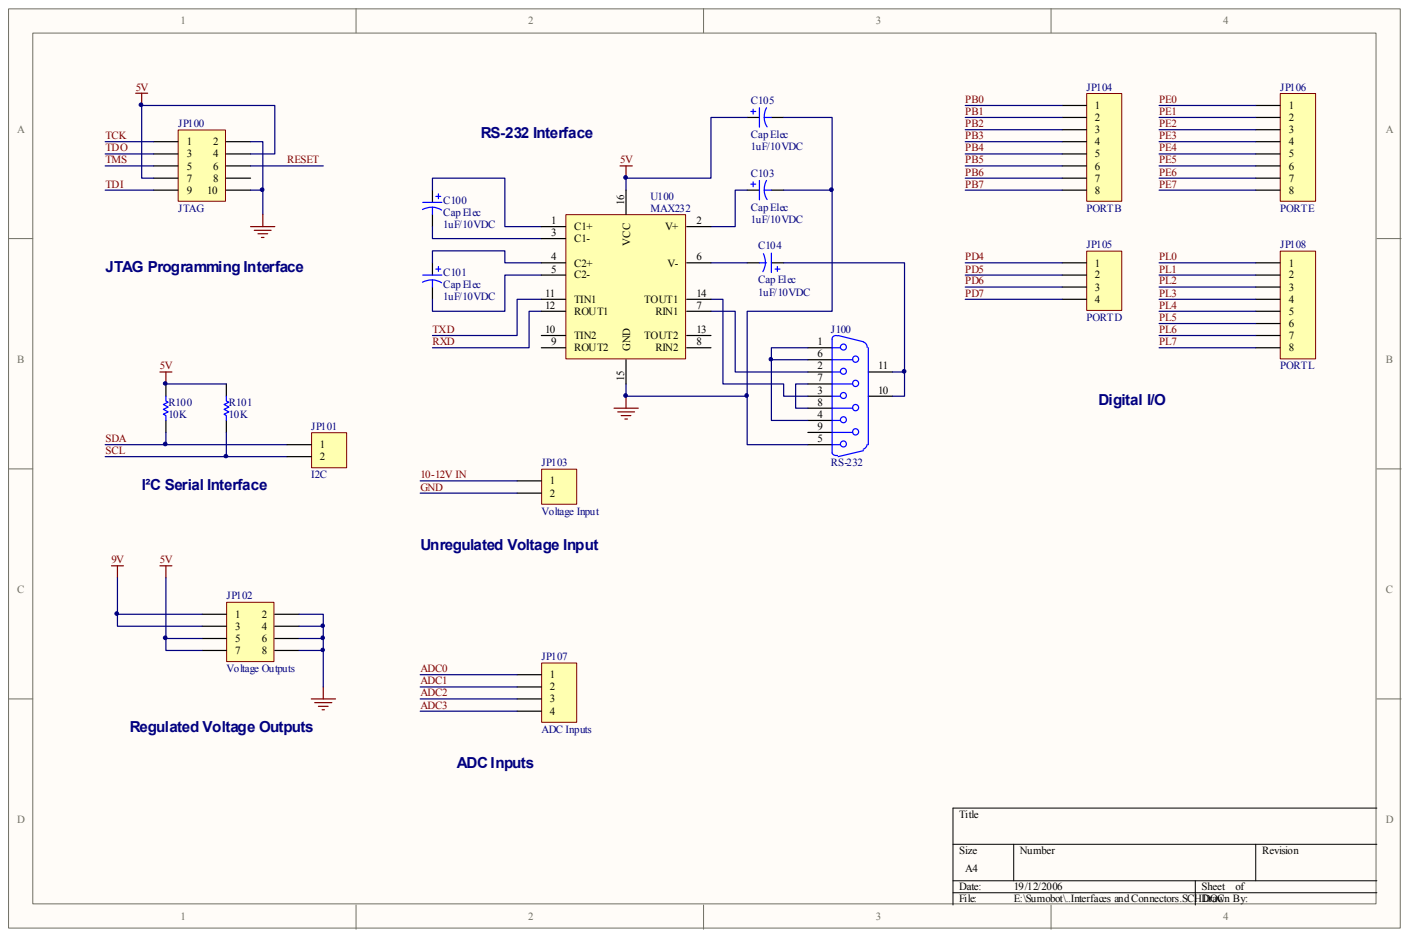
[picture p49: page 1]
