BearXP/DLY_2014_Sumo/Electronics/2007-04-16/Sumobot/PCB Layout.pdf

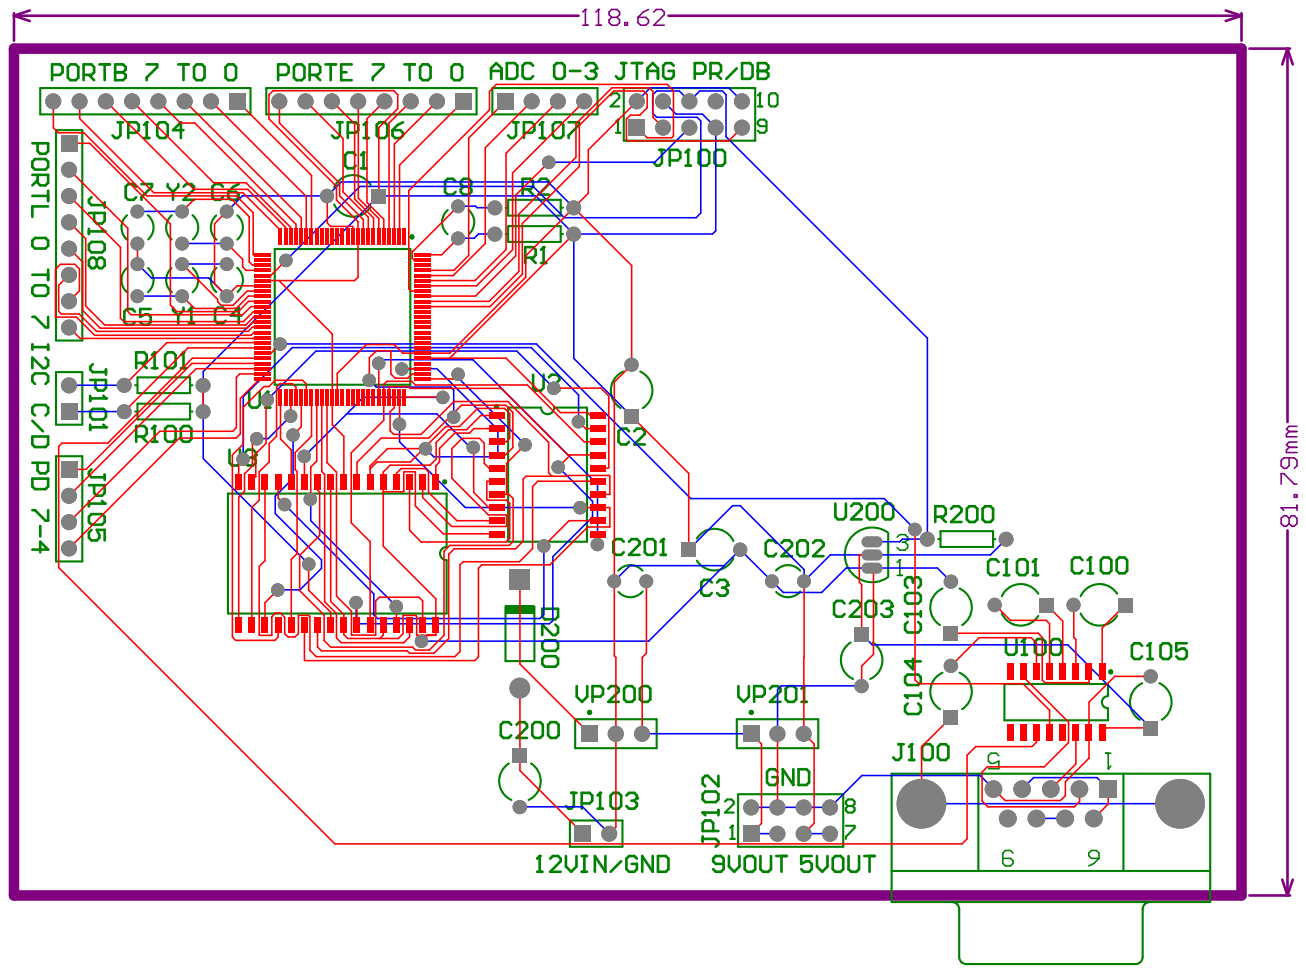
[picture p50: page 1]
