BearXP/DLY_2014_Sumo/Electronics/Example Schematics/Power Board/PBoard%20-%20comp.pdf

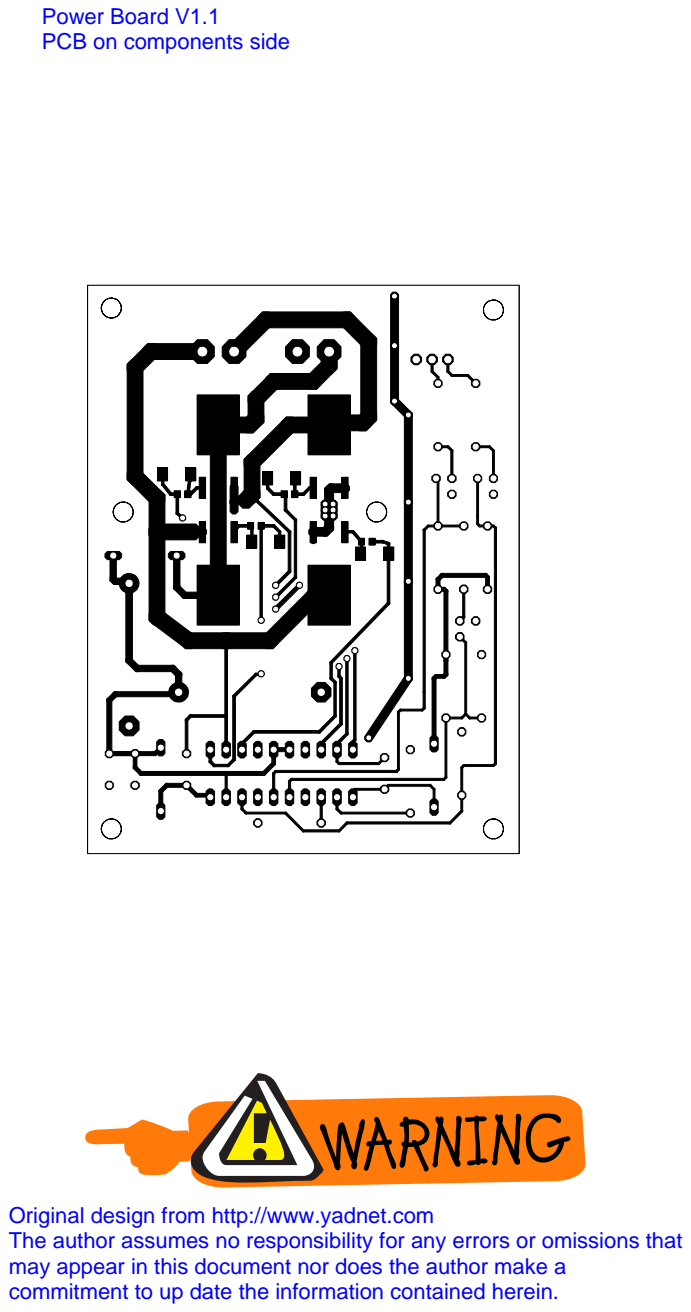
[picture p51: page 1]
