BearXP/DLY_2014_Sumo/Electronics/Example Schematics/Power Board/PBoard%20-%20place.pdf

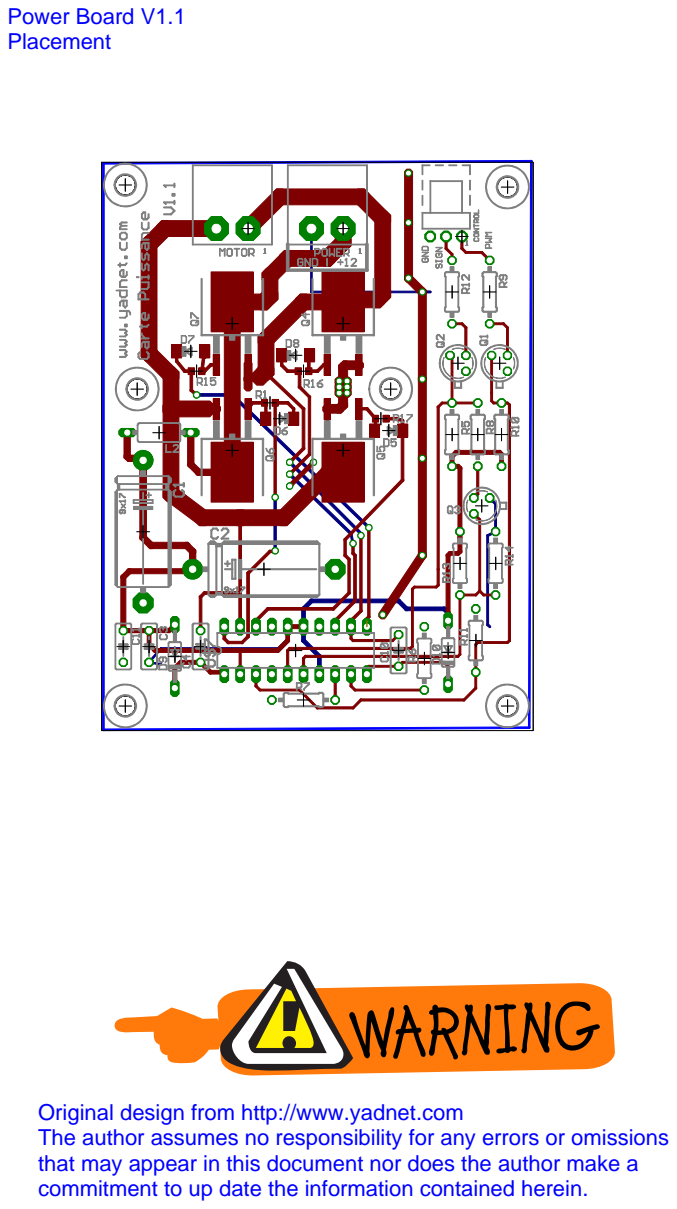
[picture p52: page 1]
