BearXP/DLY_2014_Sumo/Electronics/Example Schematics/Power Board/PBoard%20-%20solder.pdf

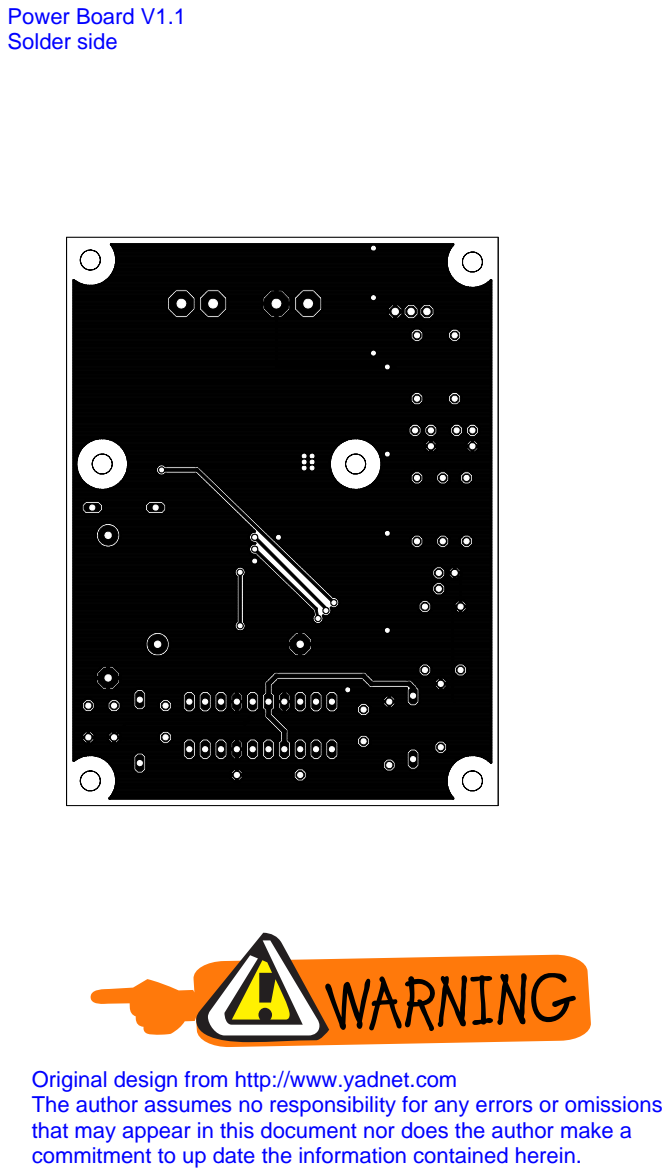
[picture p53: page 1]
