BearXP/DLY_2014_Sumo/Electronics/Example Schematics/Power Board/PBoard.pdf

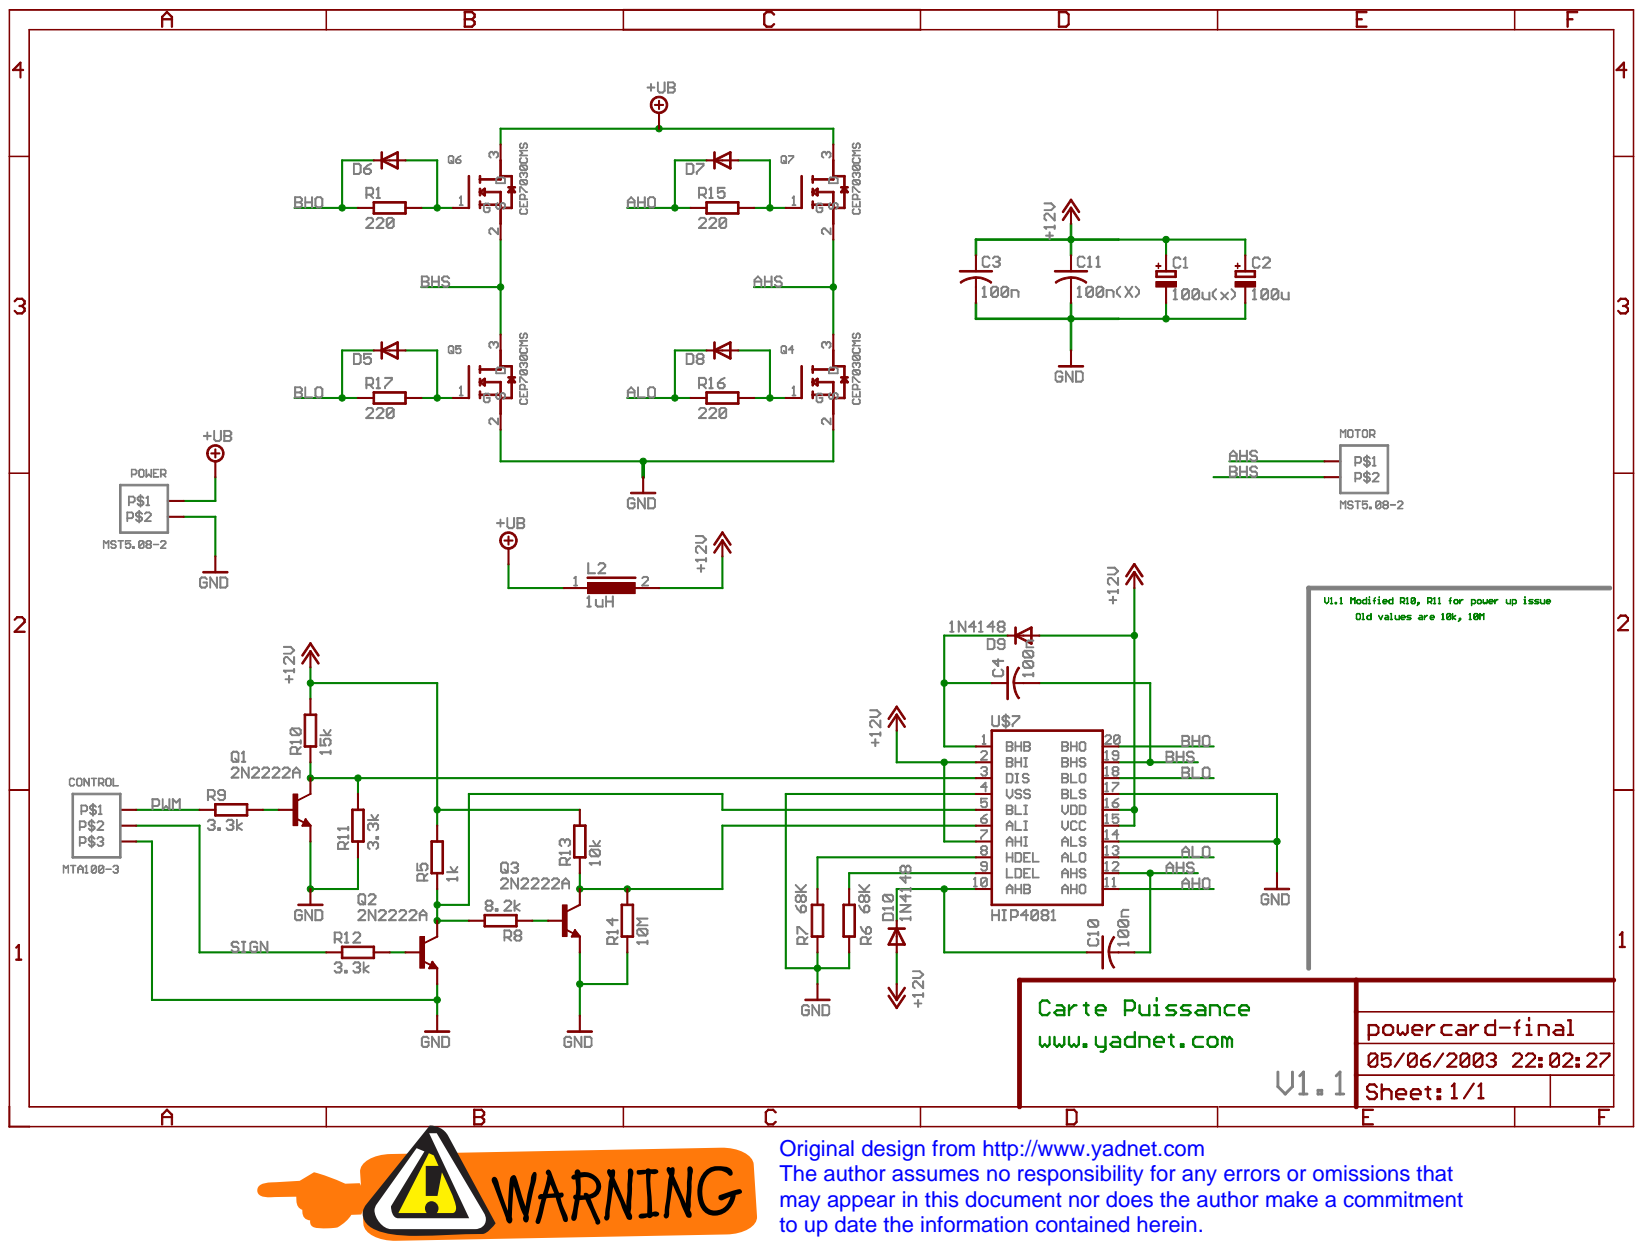
[picture p54: page 1]
