BearXP/DLY_2014_Sumo/Electronics/2007-04-16/Sumobot/PDFs/SumPCB.pdf

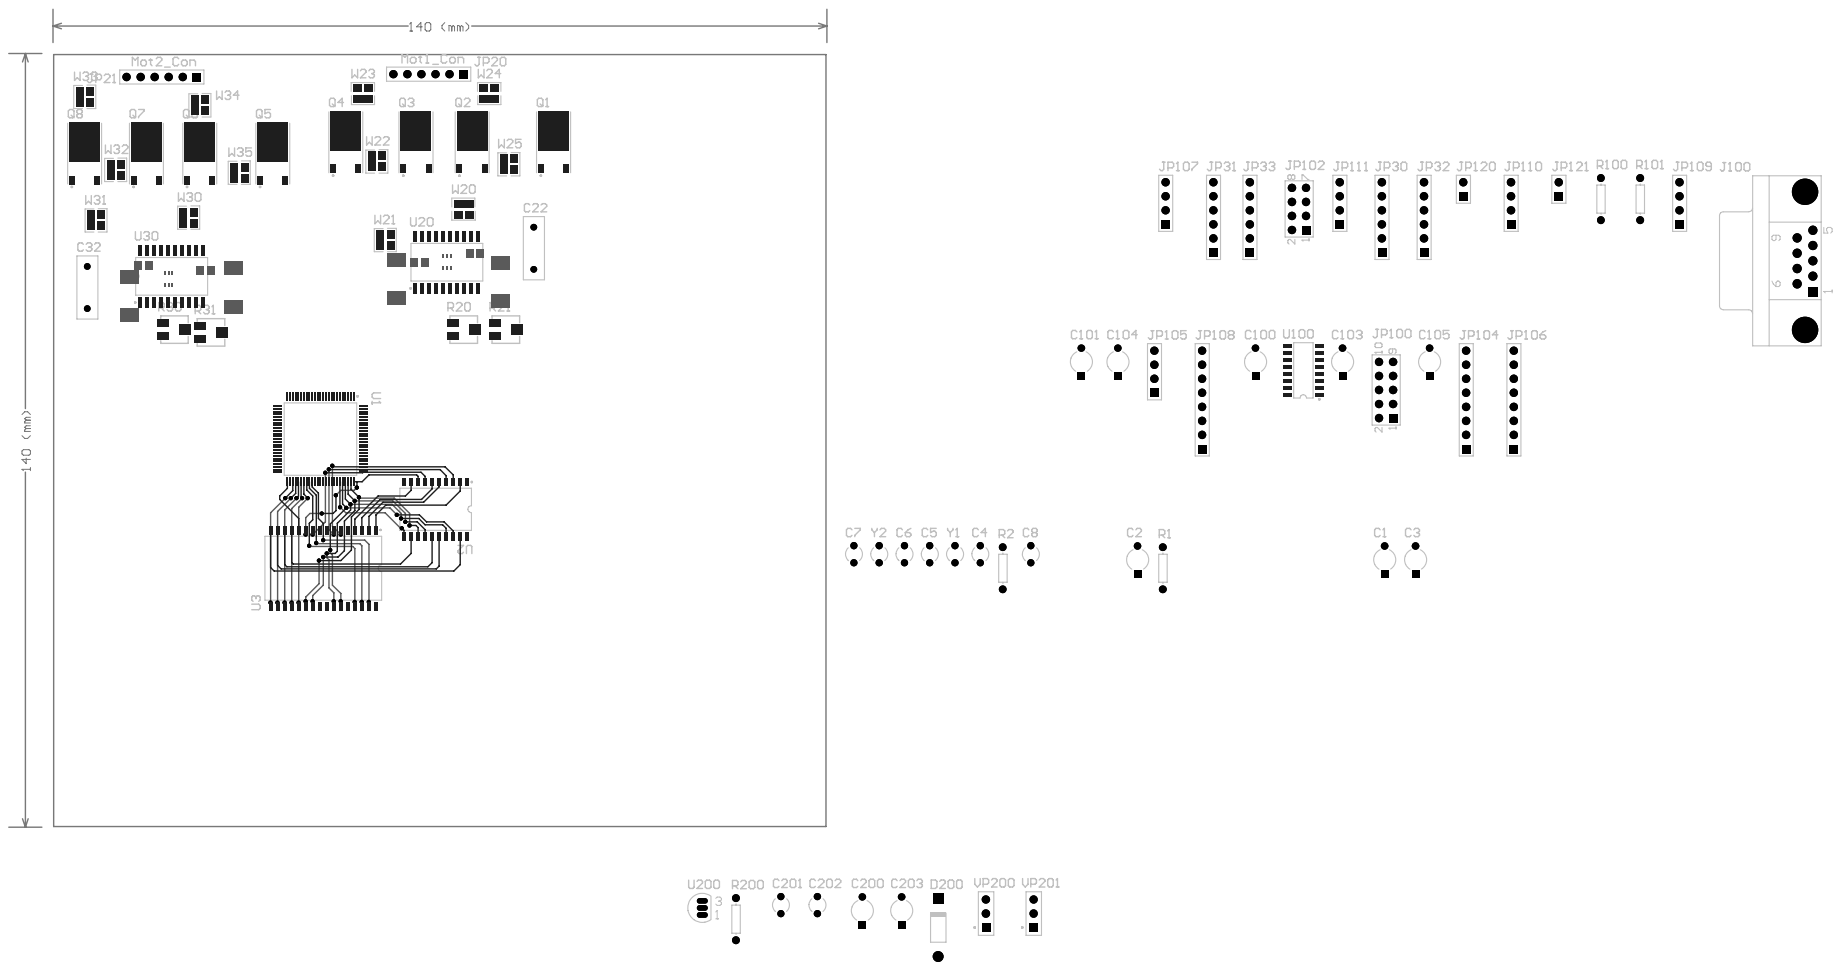
[picture p55: page 1]
