BearXP/DLY_2014_Sumo/Electronics/2007-05-31 quote requested/exports/2007-05-30/Motor_Driver.pdf

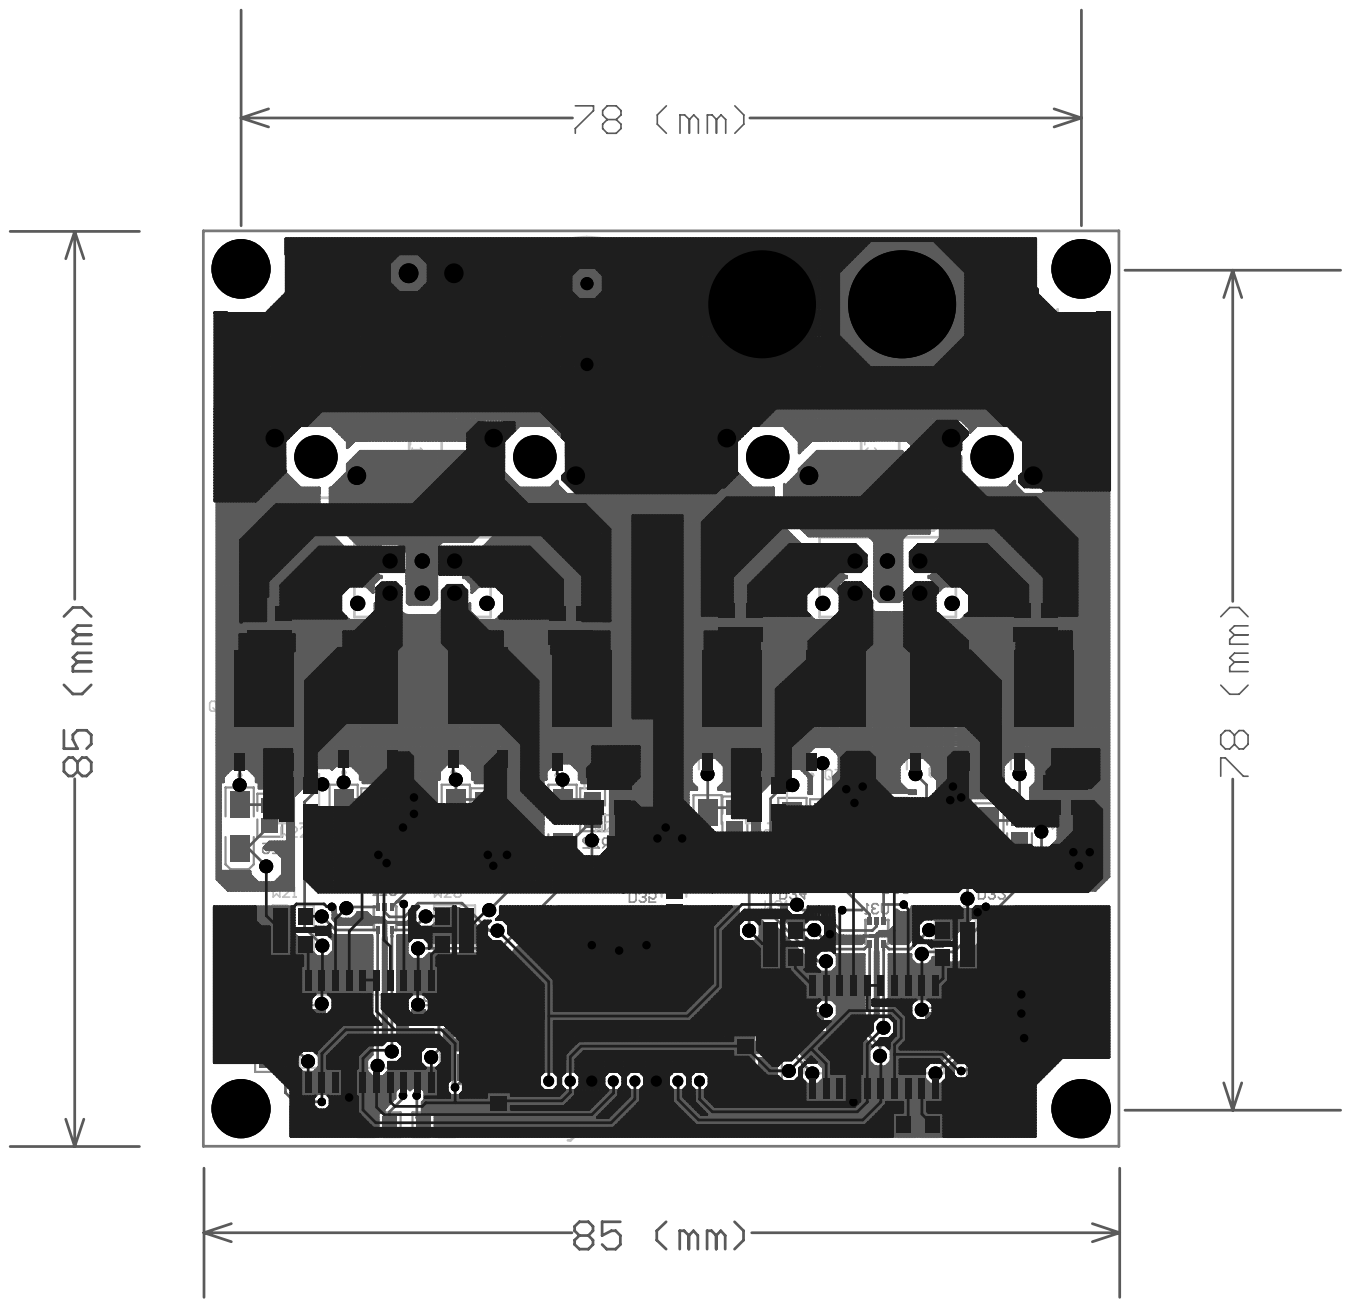
[picture p56: page 1]
