BearXP/DLY_2014_Sumo/(list of files, drawings)

Other design files:
Electronics/2007-04-12 sch pcb export/SumoPCB.PCB
Electronics/2007-04-16/Sumobot/Backup/Manual 22-02-2007/Interfaces and Connectors.SCHDOC
Electronics/2007-04-16/Sumobot/Backup/Manual 22-02-2007/Microcontroller and Memory.SCHDOC
Electronics/2007-04-16/Sumobot/Backup/Manual 22-02-2007/Motor Control.SchDoc
Electronics/2007-04-16/Sumobot/Backup/Manual 22-02-2007/PCB Layout.PCBDOC
Electronics/2007-04-16/Sumobot/Backup/Manual 22-02-2007/Power Regulation and Protection.SCHDOC
Electronics/2007-04-16/Sumobot/Backup/Manual 22-02-2007/Schematic Library.SCHLIB
Electronics/2007-04-16/Sumobot/Backup/Manual 22-02-2007/Schematic of Schematics.SCHDOC
Electronics/2007-04-16/Sumobot/Backup/Manual 22-02-2007/Sumo Footprints.PcbLib
Electronics/2007-04-16/Sumobot/Backup/Manual 22-02-2007/Sumobot 2007.PRJPCB
Electronics/2007-04-16/Sumobot/Backup/Manual 22-02-2007/SumoPCB.PCB
Electronics/2007-04-16/Sumobot/Backup/Manual 22-02-2007/SumoPCB.PcbDoc
Electronics/2007-04-16/Sumobot/copy SumoPCB.PcbDoc
Electronics/2007-04-16/Sumobot/Draft 1/Interfaces and Connectors.SCHDOC
Electronics/2007-04-16/Sumobot/Draft 1/Microcontroller and Memory.SCHDOC
Electronics/2007-04-16/Sumobot/Draft 1/PCB Layout.PCBDOC
Electronics/2007-04-16/Sumobot/Draft 1/Power Regulation and Protection.SCHDOC
Electronics/2007-04-16/Sumobot/Draft 1/Schematic Library.SCHLIB
Electronics/2007-04-16/Sumobot/Draft 1/Schematic of Schematics.SCHDOC
Electronics/2007-04-16/Sumobot/Draft 1/Sumobot 2007.PRJPCB
Electronics/2007-04-16/Sumobot/Interfaces and Connectors - Sensors.SCHDOC
Electronics/2007-04-16/Sumobot/Interfaces and Connectors.SCHDOC
Electronics/2007-04-16/Sumobot/Microcontroller and Memory.SCHDOC
Electronics/2007-04-16/Sumobot/Motor Control.SchDoc
Electronics/2007-04-16/Sumobot/PCB Layout.PCBDOC
Electronics/2007-04-16/Sumobot/Power Regulation and Protection.SCHDOC
Electronics/2007-04-16/Sumobot/Schematic Library.SCHLIB
Electronics/2007-04-16/Sumobot/Schematic of Schematics.SCHDOC
Electronics/2007-04-16/Sumobot/Sheet1.SchDoc
Electronics/2007-04-16/Sumobot/Sumo Footprints.PcbLib
Electronics/2007-04-16/Sumobot/sumo power supply/sumo power supply/power supply.PRJPCB
Electronics/2007-04-16/Sumobot/sumo power supply/sumo power supply/Sheet1.SchDoc
Electronics/2007-04-16/Sumobot/Sumobot 2007.PRJPCB
Electronics/2007-04-16/Sumobot/SumoPCB.PCB
Electronics/2007-04-16/Sumobot/SumoPCB.PcbDoc
Electronics/2007-04-23/SumoPCB.PCB
Electronics/2007-05-31 quote requested/exports/2007-05-27/SumoPCB.PCB
Electronics/2007-05-31 quote requested/exports/2007-05-30/Sumo_Motor_Stepper_DC.PCB
Electronics/2007-05-31 quote requested/exports/2007-05-30/SumoPCB.PCB
Electronics/2007-05-31 quote requested/exports/SumoPCB.PcbDoc
Electronics/2007-05-31 quote requested/Sumobot/Backup/SumoPCB pre power from dong.PcbDoc
Electronics/2007-05-31 quote requested/Sumobot/Interfaces and Connectors - Sensors.SCHDOC
Electronics/2007-05-31 quote requested/Sumobot/Interfaces and Connectors.SCHDOC
Electronics/2007-05-31 quote requested/Sumobot/Microcontroller and Memory.SCHDOC
Electronics/2007-05-31 quote requested/Sumobot/Power Regulation and Protection.SCHDOC
Electronics/2007-05-31 quote requested/Sumobot/Schematic of Schematics.SCHDOC
Electronics/2007-05-31 quote requested/Sumobot/Sumobot 2007.PRJPCB
Electronics/2007-05-31 quote requested/Sumobot/SumoPCB.PcbDoc
Electronics/2007-05-31 quote requested/SumoLibrary/Schematic Library.SCHLIB
Electronics/2007-05-31 quote requested/SumoLibrary/Sumo Footprints.PcbLib
Electronics/2007-05-31 quote requested/SumoMotorStepper/exports/Sumo_Motor_Stepper_DC.PCB
Electronics/2007-05-31 quote requested/SumoMotorStepper/Sumo_Motor_Stepper_DC.PCBDOC
Electronics/2007-05-31 quote requested/SumoMotorStepper/Sumo_Motor_Stepper_DC.PRJPCB
Electronics/2007-05-31 quote requested/SumoMotorStepper/Sumo_Motor_Stepper_DC.SCHDOC
Electronics/2007-05-31 quote requested/SumoMotorStepper/Sumo_Motor_Stepper_DC_Conns.SCHDOC
Electronics/2007-05-31 quote requested/SumoMotorStepper/Sumo_Motor_Stepper_DC_TopLevel.SCHDOC
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
