BearXP/DLY_2014_Sumo/Software/Source Code/DLY/Motor2/SIN.H

//
//         SIN.H
//		   
//
//	FILE DESCRIPTION
//  Sin and Cos tables
//

#ifndef SIN_H
#define SIN_H

#include "puresin.h"

const DWord sinFact = (DWord)(bigNum/127.5/2);
//Compiler can't perform array fetches at compile time so
//this table is generated at run time by init code
//therefore can't use floating point
//sin[x] = (SWord)(sinTable[x]*127.5/bigNum + 0.5)
const SWord sinWord[256] = {
(SWord)((sinTable[0]/sinFact+1)-255),
(SWord)((sinTable[1]/sinFact+1)-255),
(SWord)((sinTable[2]/sinFact+1)-255),
(SWord)((sinTable[3]/sinFact+1)-255),
(SWord)((sinTable[4]/sinFact+1)-255),
(SWord)((sinTable[5]/sinFact+1)-255),
(SWord)((sinTable[6]/sinFact+1)-255),
(SWord)((sinTable[7]/sinFact+1)-255),
(SWord)((sinTable[8]/sinFact+1)-255),
(SWord)((sinTable[9]/sinFact+1)-255),
(SWord)((sinTable[10]/sinFact+1)-255),
(SWord)((sinTable[11]/sinFact+1)-255),
(SWord)((sinTable[12]/sinFact+1)-255),
(SWord)((sinTable[13]/sinFact+1)-255),
(SWord)((sinTable[14]/sinFact+1)-255),
(SWord)((sinTable[15]/sinFact+1)-255),
(SWord)((sinTable[16]/sinFact+1)-255),
(SWord)((sinTable[17]/sinFact+1)-255),
(SWord)((sinTable[18]/sinFact+1)-255),
(SWord)((sinTable[19]/sinFact+1)-255),
(SWord)((sinTable[20]/sinFact+1)-255),
(SWord)((sinTable[21]/sinFact+1)-255),
(SWord)((sinTable[22]/sinFact+1)-255),
(SWord)((sinTable[23]/sinFact+1)-255),
(SWord)((sinTable[24]/sinFact+1)-255),
(SWord)((sinTable[25]/sinFact+1)-255),
(SWord)((sinTable[26]/sinFact+1)-255),
(SWord)((sinTable[27]/sinFact+1)-255),
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
sinWord[255],
sinWord[0],
sinWord[1],
sinWord[2],
sinWord[3],
sinWord[4],
sinWord[5],
sinWord[6],
sinWord[7],
sinWord[8],
sinWord[9],
sinWord[10],
sinWord[11],
sinWord[12],
sinWord[13],
sinWord[14],
sinWord[15],
sinWord[16],
sinWord[17],
sinWord[18],
sinWord[19],
sinWord[20],
sinWord[21],
sinWord[22],
sinWord[23],
sinWord[24],
sinWord[25],
sinWord[26],
sinWord[27],
sinWord[28],
sinWord[29],
sinWord[30],
sinWord[31],
sinWord[32],
sinWord[33],
sinWord[34],
sinWord[35],
sinWord[36],
sinWord[37],
sinWord[38],
sinWord[39],
sinWord[40],
sinWord[41],
sinWord[42],
sinWord[43],
sinWord[44],
sinWord[45],
sinWord[46],
sinWord[47],
sinWord[48],
sinWord[49],
sinWord[50],
sinWord[51],
sinWord[52],
sinWord[53],
sinWord[54],
sinWord[55],
sinWord[56],
sinWord[57],
sinWord[58],
sinWord[59],
sinWord[60],
sinWord[61],
sinWord[62],
sinWord[63],
};
#endif //SIN_H
