BearXP/DLY_2014_Sumo/Software/Source Code/DLY/Motor2/data.h

#ifndef DATA_H
#define DATA_H

/* Array size: 58335 bytes. */
#include <avr/pgmspace.h>

char packed [] PROGMEM = {
0xef, 0xc1, 0xff, 0xde, 0x7b, 0xff, 0xff, 0xff, 
0xfe, 0xfb, 0xff, 0xff, 0xf7, 0xfe, 0x7f, 0xff, 
0xad, 0xfc, 0xff, 0xff, 0x81, 0x14, 0x73, 0xd0, 
0x31, 0x44, 0xf4, 0x8d, 0xaf, 0xb5, 0xd6, 0xde, 
0x7b, 0x2f, 0xce, 0x39, 0xef, 0xfe, 0x47, 0x29, 
0xe4, 0xeb, 0x5b, 0xed, 0xc5, 0xfa, 0x9b, 0xa4, 
0x94, 0x4a, 0xe8, 0x20, 0x84, 0x10, 0x3a, 0xa6, 
0x88, 0x8d, 0x6d, 0xb5, 0xd6, 0xde, 0x7b, 0x31, 
0xce, 0x7a, 0x7f, 0x51, 0x0e, 0x2a, 0xe3, 0xdf, 
0x4a, 0xed, 0xcd, 0x3c, 0x18, 0xa5, 0x52, 0x4a, 
0x09, 0x21, 0x84, 0xce, 0x29, 0x5f, 0x63, 0x5b, 
0xad, 0xb5, 0xf7, 0x5e, 0x9c, 0x77, 0x1f, 0xe6, 
0x9c, 0x63, 0xc4, 0xbe, 0x94, 0xd6, 0x8b, 0xb7, 
0x2f, 0x28, 0xa9, 0x94, 0x94, 0x4a, 0xe9, 0x18, 
0x13, 0xf4, 0xbd, 0xf7, 0xde, 0x6b, 0xad, 0xbd, 
0xb9, 0x0f, 0x83, 0x50, 0x21, 0xbf, 0x6b, 0x5c, 
0xe9, 0xac, 0x37, 0x87, 0x93, 0x54, 0x42, 0x07, 
0xa5, 0x94, 0x90, 0x09, 0xfb, 0xda, 0x9b, 0xb5, 
0xb6, 0xb5, 0xd6, 0xcc, 0x0b, 0x3a, 0x85, 0x67, 
0xdd, 0x4b, 0xb1, 0x33, 0xd2, 0xfb, 0x8d, 0x52, 
0xa7, 0x0c, 0xa3, 0x96, 0x42, 0xc3, 0x67, 0x9c, 
0xb7, 0xdf, 0xb7, 0xce, 0x8a, 0xb5, 0x20, 0x3e, 
0xdf, 0x2c, 0xce, 0x32, 0x7a, 0x4e, 0x7a, 0xb9, 
0x38, 0xc7, 0x1c, 0xa4, 0x94, 0x42, 0xa6, 0x14, 
0x53, 0x7c, 0xb6, 0x17, 0x73, 0x5e, 0x25, 0xbd, 
0x5a, 0x10, 0x9f, 0xb1, 0x26, 0x0b, 0x79, 0x2b, 
0xe9, 0xd5, 0xe4, 0x1c, 0x73, 0x94, 0x52, 0xa9, 
0x8c, 0x82, 0x50, 0xf1, 0xd5, 0x6e, 0x5f, 0x3a, 
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
0x16, 0x6b, 0x8b, 0xed, 0xbd, 0x9a, 0x66, 0xf2, 
0xc7, 0x36, 0x1f, 0x11, 0x3c, 0xb6, 0xc9, 0x49, 
0x28, 0x7b, 0x48, 0xfa, 0xfc, 0xec, 0x53, 0x15, 
0x3d, 0xc4, 0x5c, 0xd1, 0x85, 0xbd, 0x05, 0xf3, 
0x96, 0xa7, 0x11, 0xc5, 0xea, 0x31, 0xc6, 0x29, 
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
*/
#endif //DATA_H
