BearXP/DLY_2014_Sumo/Software/Source Code/DLY/Motor2/PURESIN.H

//
//         PURESIN.H
//		   
//
//	FILE DESCRIPTION
//  A pure sin table
//

#ifndef PURESIN_H
#define PURESIN_H

#include <avr/pgmspace.h>

const DWord bigNum = 1l<<30;
//A general purpose sin table 256 elements
//input = 0 to 2*pi (-1/256*2*pi) output from 0 to 2
const DWord sinTable[256] PROGMEM = {
(DWord)(bigNum*(1+0.0)),
(DWord)(bigNum*(1+0.024541229)),
(DWord)(bigNum*(1+0.049067674)),
(DWord)(bigNum*(1+0.073564564)),
(DWord)(bigNum*(1+0.09801714)),
(DWord)(bigNum*(1+0.122410675)),
(DWord)(bigNum*(1+0.146730474)),
(DWord)(bigNum*(1+0.170961889)),
(DWord)(bigNum*(1+0.195090322)),
(DWord)(bigNum*(1+0.21910124)),
(DWord)(bigNum*(1+0.24298018)),
(DWord)(bigNum*(1+0.266712757)),
(DWord)(bigNum*(1+0.290284677)),
(DWord)(bigNum*(1+0.31368174)),
(DWord)(bigNum*(1+0.336889853)),
(DWord)(bigNum*(1+0.359895037)),
(DWord)(bigNum*(1+0.382683432)),
(DWord)(bigNum*(1+0.405241314)),
(DWord)(bigNum*(1+0.427555093)),
(DWord)(bigNum*(1+0.44961133)),
(DWord)(bigNum*(1+0.471396737)),
(DWord)(bigNum*(1+0.492898192)),
(DWord)(bigNum*(1+0.514102744)),
(DWord)(bigNum*(1+0.53499762)),
(DWord)(bigNum*(1+0.555570233)),
(DWord)(bigNum*(1+0.575808191)),
(DWord)(bigNum*(1+0.595699304)),
(DWord)(bigNum*(1+0.615231591)),
(DWord)(bigNum*(1+0.634393284)),
(DWord)(bigNum*(1+0.653172843)),
(DWord)(bigNum*(1+0.671558955)),
(DWord)(bigNum*(1+0.689540545)),
(DWord)(bigNum*(1+0.707106781)),
(DWord)(bigNum*(1+0.724247083)),
(DWord)(bigNum*(1+0.740951125)),
(DWord)(bigNum*(1+0.757208847)),
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
(DWord)(bigNum*(1+-0.195090322)),
(DWord)(bigNum*(1+-0.170961889)),
(DWord)(bigNum*(1+-0.146730474)),
(DWord)(bigNum*(1+-0.122410675)),
(DWord)(bigNum*(1+-0.09801714)),
(DWord)(bigNum*(1+-0.073564564)),
(DWord)(bigNum*(1+-0.049067674)),
(DWord)(bigNum*(1+-0.024541229))
};
#endif //PURESIN_H
