BearXP/DLY_2014_Sumo/Software/Source Code/TDT/2007_09_14_TDT/src/sprites.h

#ifndef __SUMOBOT_SPRITES_H__
#define __SUMOBOT_SPRITES_H__

#define SPRITE_ALPHANUMERIC_WIDTH		5
#define SPRITE_ALPHANUMERIC_HEIGHT		7

static const USHORT sc_sprite_0[] = {
	0b01110,
	0b10001,
	0b10001,
	0b10001,
	0b10001,
	0b10001,
	0b01110
};

static const USHORT sc_sprite_1[] = {
	0b00100,
	0b01100,
	0b00100,
	0b00100,
	0b00100,
	0b00100,
	0b01110
};

static const USHORT sc_sprite_2[] = {
	0b01110,
	0b10001,
	0b00010,
	0b00100,
	0b01000,
	0b10000,
	0b11111
};

static const USHORT sc_sprite_3[] = {
	0b01110,
	0b10001,
	0b00001,
	0b00110,
	0b00001,
	0b10001,
	0b01110
};

static const USHORT sc_sprite_4[] = {
	0b00010,
	0b00110,
	0b01010,
	0b10010,
	0b11111,
	0b00010,
	0b00010
};

static const USHORT sc_sprite_5[] = {
	0b11111,
	0b10000,
	0b10000,
	0b11110,
	0b00001,
	0b10001,
	0b01110
};

static const USHORT sc_sprite_6[] = {
	0b01110,
	0b10001,
	0b10000,
	0b11110,
	0b10001,
	0b10001,
	0b01110
};

static const USHORT sc_sprite_7[] = {
	0b11111,
	0b00001,
	0b00010,
	0b00100,
	0b01000,
	0b10000,
	0b10000
};

static const USHORT sc_sprite_8[] = {
	0b01110,
	0b10001,
	0b10001,
	0b01110,
	0b10001,
	0b10001,
	0b01110
};

static const USHORT sc_sprite_9[] = {
	0b01110,
	0b10001,
	0b10001,
	0b01111,
	0b00001,
	0b10001,
	0b01110
};

static const USHORT sc_sprite_A[] = {
	0b01110,
	0b10001,
	0b10001,
	0b11111,
	0b10001,
	0b10001,
	0b10001
};

static const USHORT sc_sprite_B[] = {
	0b11110,
	0b10001,
	0b10001,
	0b11110,
	0b10001,
	0b10001,
	0b11110
};

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
	sc_sprite_mini4, sc_sprite_mini5, sc_sprite_mini6, sc_sprite_mini7,
	sc_sprite_mini8, sc_sprite_mini9, sc_sprite_miniA, sc_sprite_miniB,
	sc_sprite_miniC, sc_sprite_miniD, sc_sprite_miniE, sc_sprite_miniF
};

#endif // __SUMOBOT_SPRITES_H__
