BearXP/DLY_2014_Sumo/Software/Source Code/TDT/2007_11_05_Readout_Range_TDT/src/sumo_ircalib.h

#ifndef __SUMOBOT_IRCALIBS_H__
#define __SUMOBOT_IRCALIBS_H__


const UBYTE ircalib_length = 20;


//for all but front right sensor
static USHORT ircalib_1[20][2] = {										
										{100,560},
										{200,553},
										{300,432},
										{400,338},
										{500,264},
										{600,222},
										{700,191},
										{800,166},
										{900,147},
										{1000,131},
										{1100,118},
										{1200,108},
										{1300,99},
										{1400,94},
										{1500,89},
										{1600,83},
										{1700,71},
										{1800,72},
										{1900,69},
										{2000,69}
									   };


//for front right sensor
static USHORT ircalib_2[20][2] = {										
										{100,340},
										{200,325},
										{300,292},
										{400,290},
										{500,241},
										{600,198},
										{700,166},
										{800,146},
										{900,122},
										{1000,110},
										{1100,95},
										{1200,90},
										{1300,85},
										{1400,72},
										{1500,65},
										{1600,60},
										{1700,56},
										{1800,53},
										{1900,50},
										{2000,45}
									   };


#endif //  __SUMOBOT_IRCALIBS_H__
