BearXP/DLY_2014_Sumo/Software/Source Code/TDT/2007_09_14_TDT/src/sumo_util.h

#define 	cbi(sfr, bit)   (_SFR_BYTE(sfr) &= ~_BV(bit))  //clear bit
#define 	sbi(sfr, bit)   (_SFR_BYTE(sfr) |= _BV(bit))	//set bit

#define NOP							asm volatile ("nop\n\t" ::)



uint8_t Get_Switch(uint8_t sw); //returns >0 if the switch "sw" is high, 0 otherwise.
								//sw = 1 is PH6, sw = 2 is PH7
